jamead/psc_daughter_brd/psc_daughter_brd.png

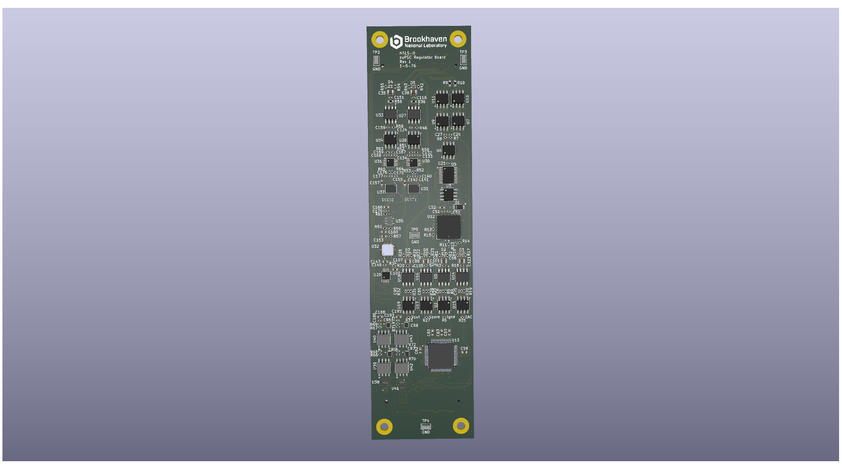
psc_daughter_brd.png
