jamead/psc_daughter_brd/assembly/psc_daughter_brd_BOM.ods

zuPSC Daughter Board
Parts per Board |  | 293
Total Parts Cost |  | $516.36
Do not install parts in red
Line Item | Qty per Board | Unit Cost | Cost Per Board | Part Number | Reference Designator | Value | Description | Manufacturer | DNP
1 | 1 | $0.01 | $0.01 | CL10B105KA8NNNC | C32 | 1uF | CAP CER 1UF 25V X7R 0603 | Samsung
2 | 4 | $0.01 | $0.04 | C0402C221K5RACTU | C1,C68,C78,C88 | 220pF | CAP CER 220PF 50V X7R 0402 | Kemet
3 | 6 | $0.01 | $0.06 | CL05B332KB5NNNC | C116,C133,C141,C151,C168,C176 | 3300pF | CAP CER 3300PF 50V X7R 0402 | Samsung
4 | 2 | $0.01 | $0.02 | MBASU105SB7103KFNA18 | C124,C159 | 0.01uF | CAP CER 0.01UF 50V X7R 0402 | Taiyo Yuden
5 | 8 |  | $0.00 | CAP CER 3300PF 50V X7R 0402 | C132,C134,C140,C142,C167,C169,C175,C177 | 6800pF | CAP CER 6800PF 50V X7R 0402 | Samsung
6 | 69 |  | $0.00 | CL10A106MA8NRNC | C2,C3,C6,C7,C11,C12,C15,C17,C18,C22,C23,C28,C30,C31,C33,C40,C41,C42,C43,C48,C52,C57,C59,C60,C61,C62,C63,C66,C69,C70,C73,C74,C79,C80,C83,C84,C89,C90,C93,C94,C98,C100,C106,C119,C121,C126,C127,C136,C137,C143,C145,C147,C153,C154,C155,C156,C157,C160,C161,C162,C166,C171,C172,C178,C180,C187,C188,C194,C195 | 10uF | CAP CER 10UF 25V X5R 0603 | Samsung
7 | 3 | $0.10 | $0.30 | C0402C100K5RACTU | C21,C26,C27 | 10pF | CAP CER 10PF 50V X7R 0402 | Kemet
8 | 6 | $0.22 | $1.32 | EMCT101W222M1GV001E | C35,C38,C101,C103,C105,C107 | 2200pF | CAP CER 2200PF 100V X7R 0805 FEED THROUGH | Johanson
9 | 76 |  | $0.00 | TMK105BJ104KV-F | C4,C5,C9,C10,C13,C14,C16,C19,C20,C24,C25,C29,C34,C36,C37,C39,C44,C45,C46,C47,C49,C50,C51,C53,C54,C55,C56,C58,C64,C65,C67,C71,C72,C76,C77,C81,C82,C86,C87,C91,C92,C96,C97,C99,C102,C104,C108,C117,C123,C128,C130,C138,C139,C144,C146,C148,C152,C158,C163,C164,C165,C170,C173,C174,C179,C181,C182,C183,C184,C185,C186,C189,C190,C191,C192,C193 | 0.1uF | CAP CER 0.1UF 25V X5R 0402 | Taiyo Yuden
10 | 4 | $0.10 | $0.40 | CL05B472KB5NNNC | C8,C75,C85,C95 | 4700pF | CAP CER 4700PF 50V X7R 0402 | Samsung
11 | 4 | $0.65 | $2.60 | SP3006-02XTG | CR5,CR6,CR7,CR8 |  | TVS DIODE 6VWM 15VC SOT563 | Littlefuse
12 | 1 | $0.23 | $0.23 | DFLS130-7 | D1 |  | DIODE SCHOTTK 30V 1A POWERDI 123 | Diodes Inc.
13 | 6 | $0.24 | $1.44 | SP3118-01ETG | D2,D3,D4,D5,D6,D7 |  | TVS DIODE 18VWM 38VC SOD882 | Littlefuse
14 | 2 | $2.53 | $5.06 | 61082-061400LF | J1,J2 |  | CONN RCPT 60POS SMD GOLD | Amphenol
15 | 1 |  | $0.00 | ERJ-2RKF1200X | R11 | 120 | RES SMD 120 OHM 1% 1/10W 0402 | Panasonic
16 | 1 |  | $0.00 | ERJ-2RKF6342X | R13 | 63K | RES SMD 63.4K OHM 1% 1/10W 0402 | Panasonic | DNP
17 | 1 |  | $0.00 | ERJ-2RKF7872X | R14 | 78.7K | RES SMD 78.7K OHM 1% 1/10W 0402 | Panasonic
18 | 1 |  | $0.00 | ERJ-2RKF1213X | R34 | 121K | RES SMD 121K OHM 1% 1/10W 0402 | Panasonic
19 | 12 | $0.01 | $0.12 | ERJ-2RKF1001X | R1,R2,R16,R17,R22,R23,R28,R29,R42,R43,R54,R55 | 1.0K | RES SMD 1K OHM 1% 1/10W 0402 | Panasonic
20 | 2 |  | $0.00 | ERJ-2GE0R00X | R15,R57 | 0 | RES SMD 0 OHM JUMPER 1/10W 0402 | Panasonic
21 | 4 |  | $0.00 | ERJ-2RKF10R0X | R3,R18,R24,R30 | 10 | RES SMD 10 OHM 1% 1/10W 0402 | Panasonic | DNP
22 | 2 | $0.32 | $0.64 | RQ73C1J665RBTD | R36,R56 | 665 | RES 665 OHMS 0.1% 0.15W 0603 | TE
23 | 10 | $0.01 | $0.10 | ERJ-2RKF1002X | R4,R5,R19,R20,R25,R26,R31,R32,R59,R60 | 10K | RES SMD 10K OHM 1% 1/10W 0402 | Panasonic
24 | 2 | $0.01 | $0.02 | ERJ-2RKF1301X | R46,R58 | 1.3K | RES SMD 1.3K OHM 1% 1/10W 0402 | Panasonic
25 | 2 | $0.01 | $0.02 | ERJ-2RKF15R0X | R51,R63 | 15 | RES SMD 15 OHM 1% 1/10W 0402 | Panasonic
26 | 4 | $0.01 | $0.04 | ERJ-2RKF30R1X | R52,R53,R64,R65 | 30.1 | RES SMD 30.1 OHM 1% 1/10W 0402 | Panasonic
27 | 8 | $0.01 | $0.08 | ERJ-2RKF10R0X | R6,R12,R21,R27,R33,R50,R61,R62 | 10 | RES SMD 10 OHM 1% 1/10W 0402 | Panasonic
28 | 8 | $0.01 | $0.08 | ERJ-2RKF2491X | R66,R67,R68,R69,R70,R71,R72,R73 | 2.49K | RES SMD 2.49K OHM 1% 1/10W 0402 | Panasonic
29 | 2 | $0.01 | $0.02 | ERJ-2RKF5111X | R7,R8 | 5.11K | RES SMD 5.11K OHM 1% 1/10W 0402 | Panasonic
30 | 2 | $0.01 | $0.02 | ERJ-PA3F1000V | R9,R10 | 100 | RES SMD 100 OHM 1% 1/3W 0603 | Panasonic
31 | 5 | $0.23 | $1.15 | RCS-0C | TP1,TP2,TP3,TP4,TP5 |  | PC TEST POINT NATURAL | TE
32 | 1 | $3.93 | $3.93 | AD8676ARZ-REEL7 | U3 |  | IC OPAMP GP 2 CIRCUIT 8SOIC | Analog Devices
33 | 1 | $129.29 | $129.29 | AD5791BRUZ | U5 |  | IC DAC 20BIT V-OUT 20TSSOP | Analog Devices
34 | 1 | $13.75 | $13.75 | AD797ARZ | U6 |  | IC OPAMP GP 1 CIRCUIT 8SOIC | Analog Devices
35 | 1 | $100.10 | $100.10 | ADR1001AEZ | U12 |  | IC VREF SERIES 5V 0.25% 20CLCC | Analog Devices
36 | 1 | $25.17 | $25.17 | ADS8568SPM | U13 |  | IC ADC 16BIT SAR 64LQFP | Analog Devices
37 | 1 | $4.96 | $4.96 | LT3042EMSE#TRPBF | U20 |  | IC REG LINEAR POS ADJ 10MSOP-EP | Analog Devices
38 | 1 | $14.02 | $14.02 | LTC6655BHLS8-5#PBF | U32 |  | IC VREF SERIES 0.025% 8CLCC | Analog Devices
39 | 1 | $3.79 | $3.79 | LT6202CS5#TRPBF | U35 |  | IC OPAMP GP 1 CIRCUIT TSOT23-5 | Analog Devices
40 | 4 | $10.23 | $40.92 | AD8221BRZ | U1,U14,U16,U18 |  | IC INST AMP 1 CIRCUIT 8SOIC | Analog Devices
41 | 2 | $2.99 | $5.98 | BUF634AIDR | U10,U11 |  | IC OPAMP GP 1 CIRCUIT 8SOIC | Analog Devices
42 | 6 | $2.66 | $15.96 | OPA277UA/2K5 | U2,U7,U9,U15,U17,U19 |  | IC OPAMP GP 1 CIRCUIT 8SOIC | Analog Devices
43 | 2 | $12.76 | $25.52 | AD8429BRZ | U27,U33 |  | IC INST AMP 1 CIRCUIT 8SOIC | Analog Devices
44 | 2 | $2.88 | $5.76 | AD8675ARZ | U28,U34 |  | IC OPAMP GP 1 CIRCUIT 8SOIC | Analog Devices
45 | 2 | $7.61 | $15.22 | LTC6363IMS8#TRPBF | U30,U36 |  | IC OPAMP DIFF 1 CIRCUIT 8MSOP | Analog Devices
46 | 2 | $34.72 | $69.44 | LTC2376CDE-20#PBF | U31,U37 |  | IC ADC 20BIT SAR 16DFN | Analog Devices
47 | 2 | $0.77 | $1.54 | TXUN0104RUTR | U38,U41 |  | IC XLTR VL UNIDIR 12-UQFN | TI
48 | 2 | $6.81 | $13.62 | ADUM5240ARZ | U39,U40 |  | DGTL ISOLTR 2.5KV 2CH GP 8-SOIC | Analog Devices
49 | 2 | $6.81 | $13.62 | ADUM5242ARZ | U42,U43 |  | DGTL ISOLTR 2.5KV 2CH GP 8-SOIC | Analog Devices
