jamead/psc_daughter_brd/3dmodels/E-20-1_ADI.step

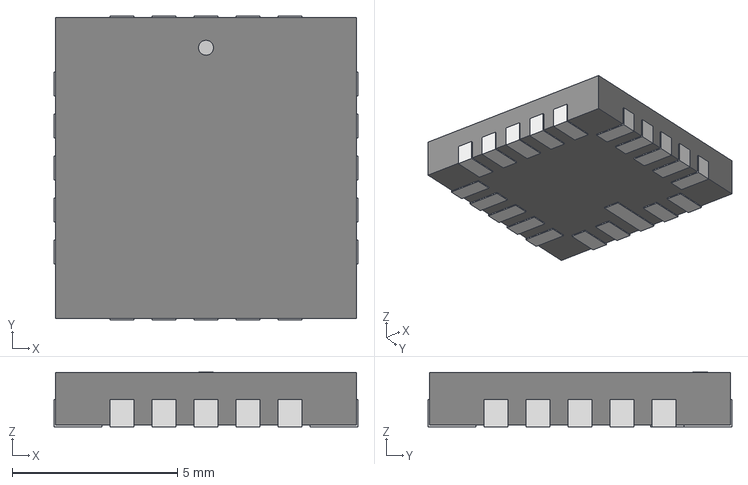
[picture p2: CAD file, 2026-01-05]
3dmodels/E-20-1_ADI.step
9.19 x 9.19 x 1.65 mm
