jamead/psc_daughter_brd/3dmodels/DFLS130-7_DIO.step

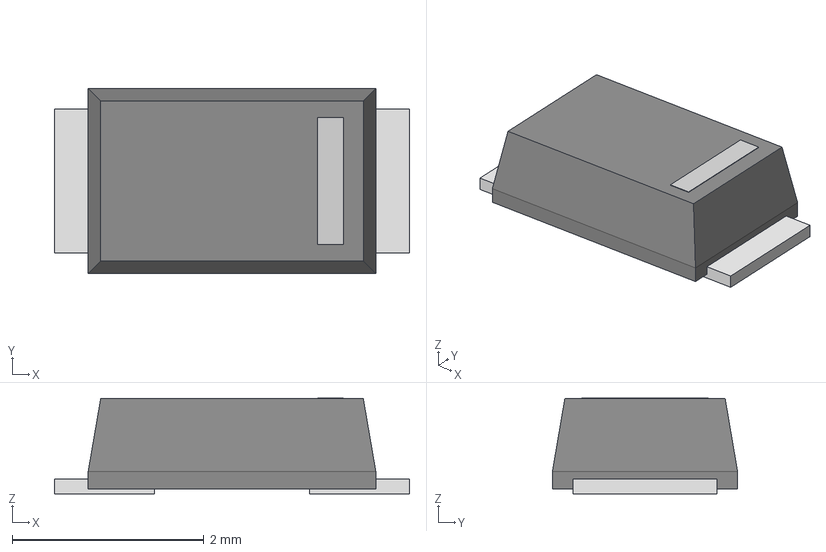
[picture p3: CAD file, 2026-01-05]
3dmodels/DFLS130-7_DIO.step
3.70 x 1.93 x 0.997 mm
