jamead/psc_daughter_brd/3dmodels/c-1625854-1-ba-3d.step

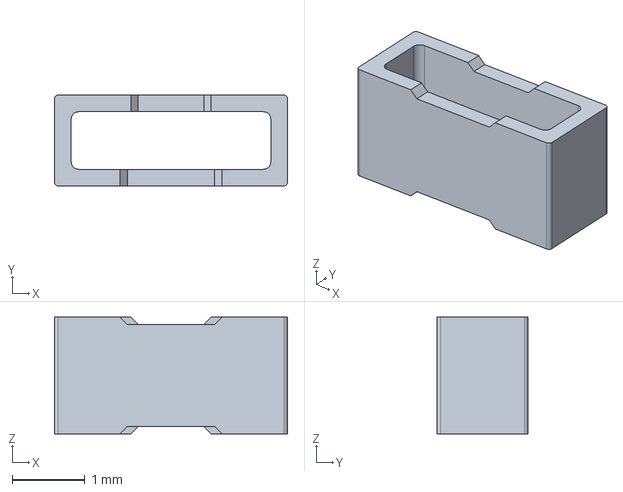
[picture p4: CAD file, 2026-01-05]
3dmodels/c-1625854-1-ba-3d.step
3.20 x 1.25 x 1.60 mm
