jamead/psc_daughter_brd/3dmodels/S_5_ADI.step

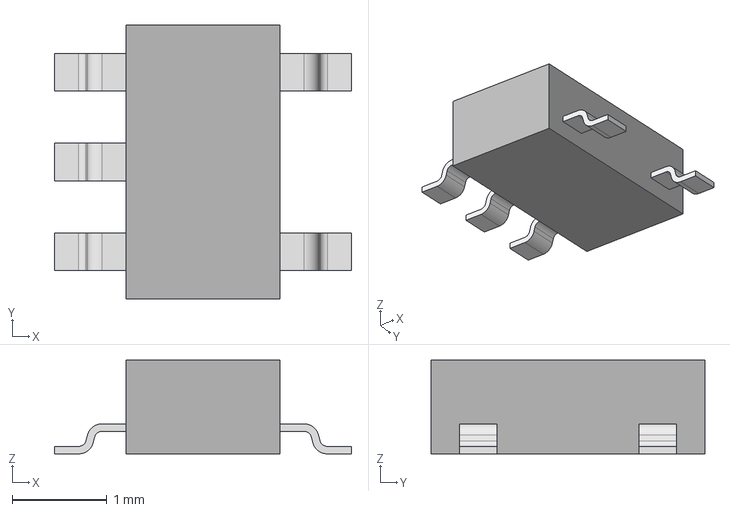
[picture p5: CAD file, 2026-01-05]
3dmodels/S_5_ADI.step
3.14 x 2.90 x 0.991 mm
