jamead/psc_daughter_brd/3dmodels/SOT563_LTF.step

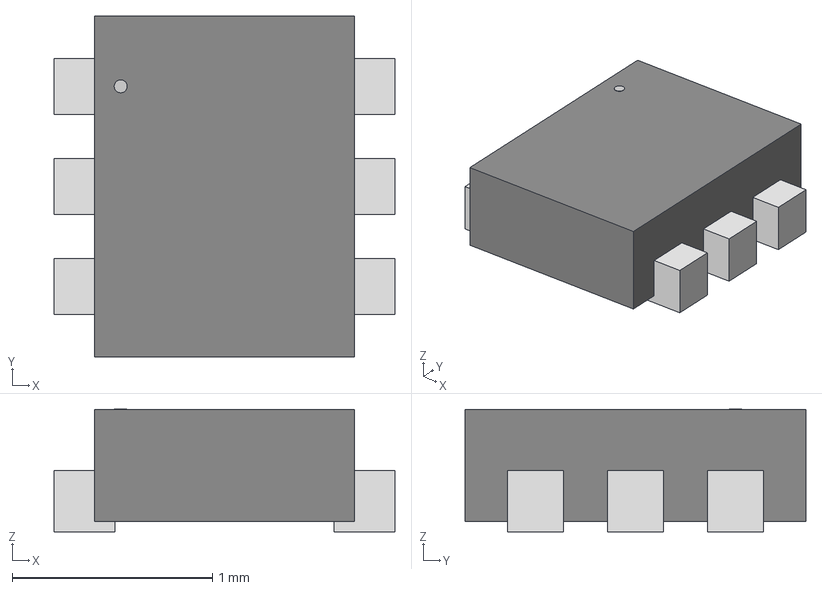
[picture p6: CAD file, 2026-01-05]
3dmodels/SOT563_LTF.step
1.70 x 1.70 x 0.612 mm
