jamead/psc_daughter_brd/3dmodels/RUT0012A.stp

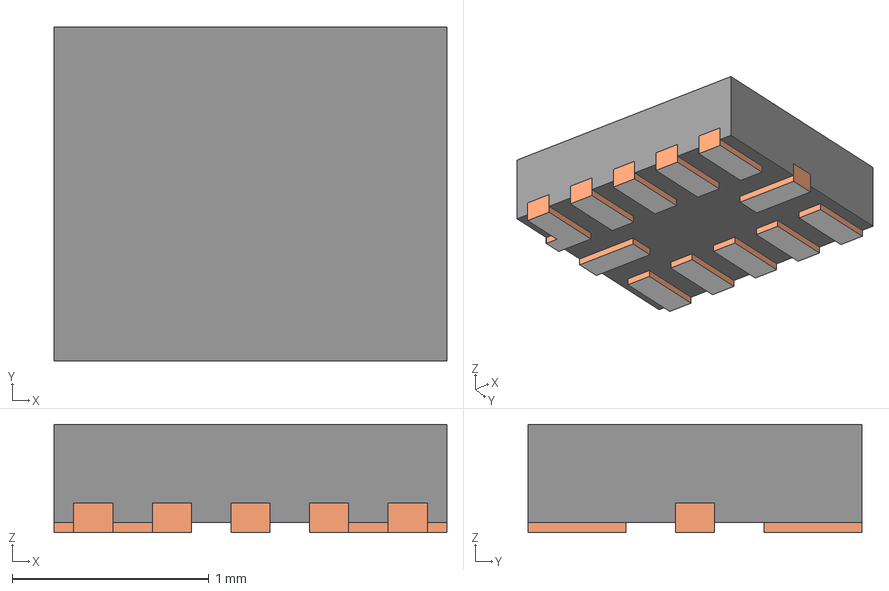
[picture p7: CAD file, 2026-01-05]
3dmodels/RUT0012A.stp
2.00 x 1.70 x 0.55 mm
BODY-SON
FRAME-RUT0012A
PIN1-ID
