jamead/psc_daughter_brd/3dmodels/R_8_ADI.step

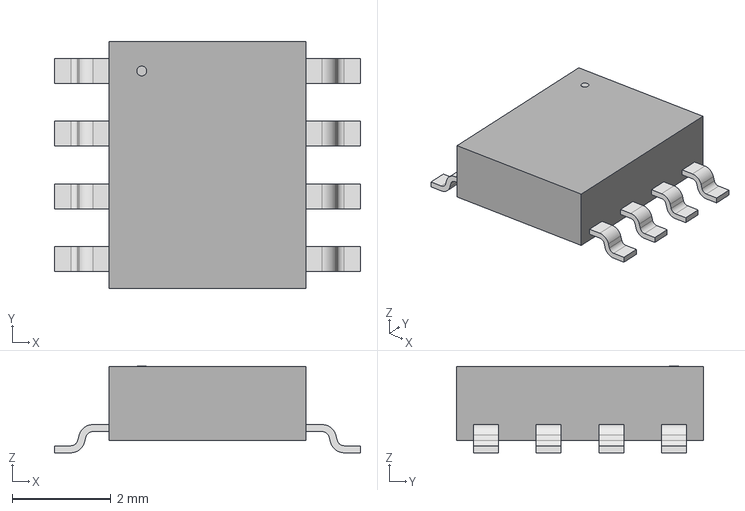
[picture p8: CAD file, 2026-01-05]
3dmodels/R_8_ADI.step
6.20 x 5.00 x 1.75 mm
