jamead/psc_daughter_brd/3dmodels/LTC2378CDE-20#PBF.STEP

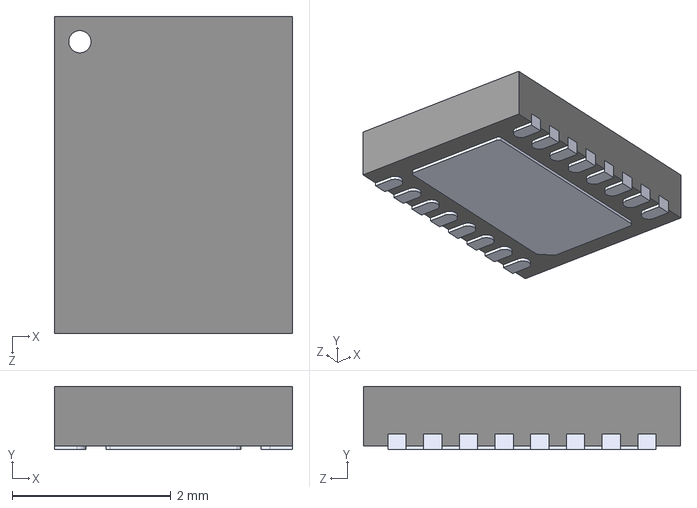
[picture p9: CAD file, 2025-11-20]
3dmodels/LTC2378CDE-20#PBF.STEP
3.00 x 0.8 x 4.00 mm
