jamead/psc_daughter_brd/3dmodels/LTC6655BHLS8-5#PBF.STEP

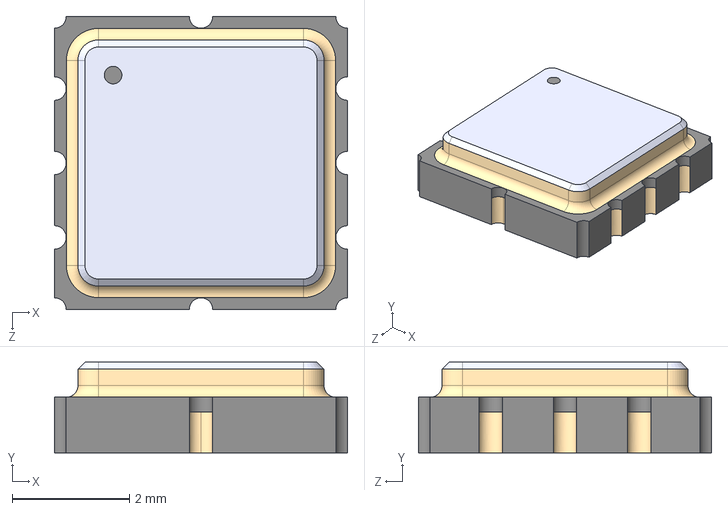
[picture p10: CAD file, 2025-11-20]
3dmodels/LTC6655BHLS8-5#PBF.STEP
5.00 x 1.55 x 5.00 mm
