jamead/psc_daughter_brd/3dmodels/ADS8568SPM.step

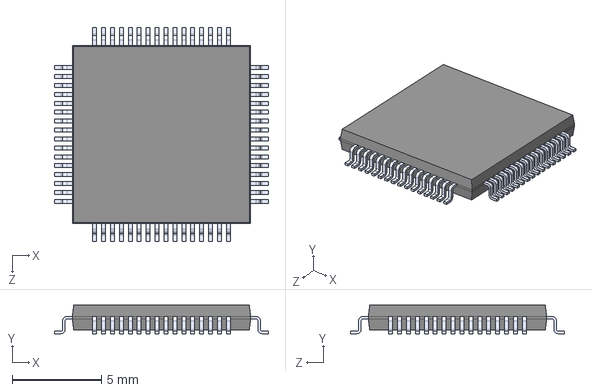
[picture p11: CAD file, 2025-07-15]
3dmodels/ADS8568SPM.step
12.0 x 1.60 x 12.0 mm
