jamead/psc_daughter_brd/3dmodels/AD8221BRZ.STEP

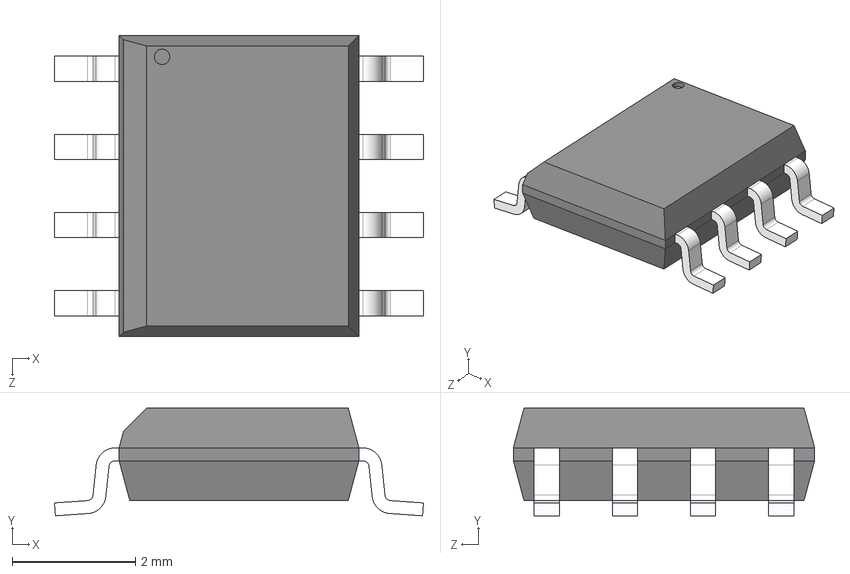
[picture p12: CAD file, 2025-07-15]
3dmodels/AD8221BRZ.STEP
6.00 x 1.75 x 4.90 mm
