jamead/psc_daughter_brd/3dmodels/Amphenol_10090926-P264XLF.step

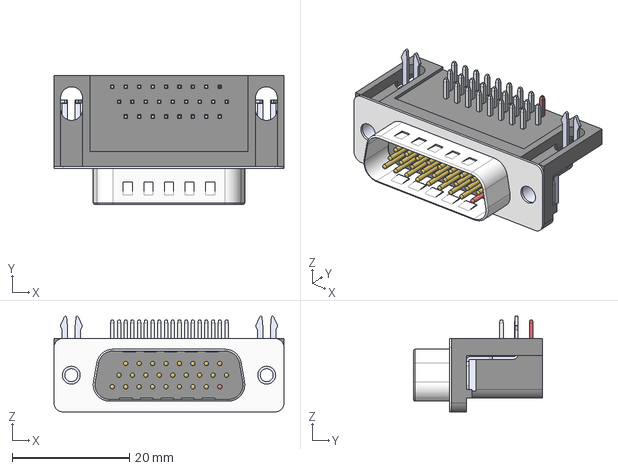
[picture p13: CAD file, 2025-07-02]
3dmodels/Amphenol_10090926-P264XLF.step
39.2 x 22.0 x 16.3 mm
