jamead/psc_daughter_brd/3dmodels/61082-061400LF--3DModel-STEP-740395.STEP

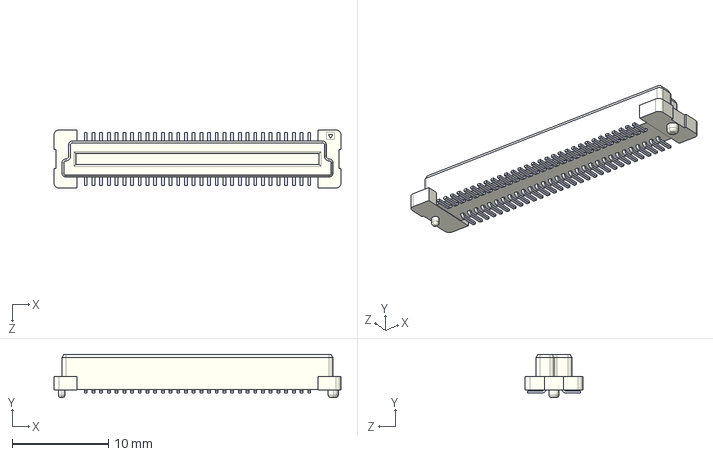
[picture p14: CAD file, 2025-11-18]
3dmodels/61082-061400LF--3DModel-STEP-740395.STEP
29.8 x 4.50 x 6.00 mm
61082-additional_06
pin^61082 add Ass x 30
