jamead/psc_daughter_brd/3dmodels/39301022.step

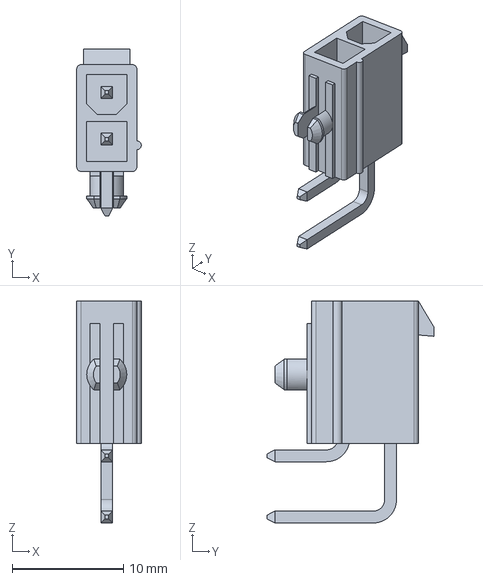
[picture p15: CAD file, 2025-07-02]
3dmodels/39301022.step
5.80 x 15.0 x 19.9 mm
