jamead/psc_daughter_brd/3dmodels/836149012.step

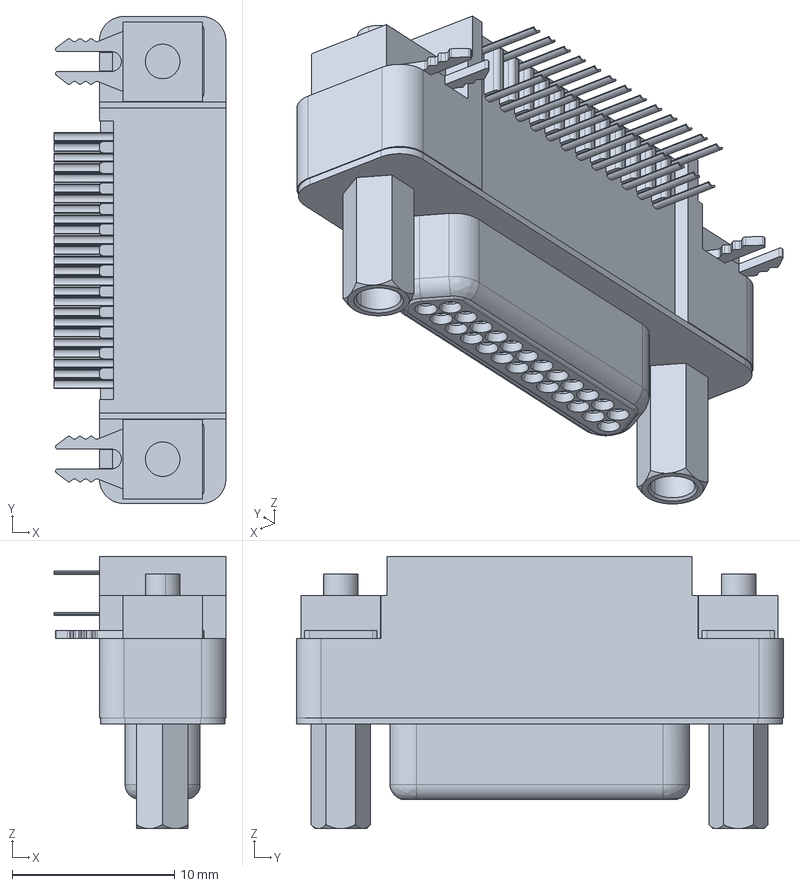
[picture p16: CAD file, 2025-07-02]
3dmodels/836149012.step
10.6 x 30.0 x 16.8 mm
