jamead/psc_daughter_brd/3dmodels/6469028-1.step

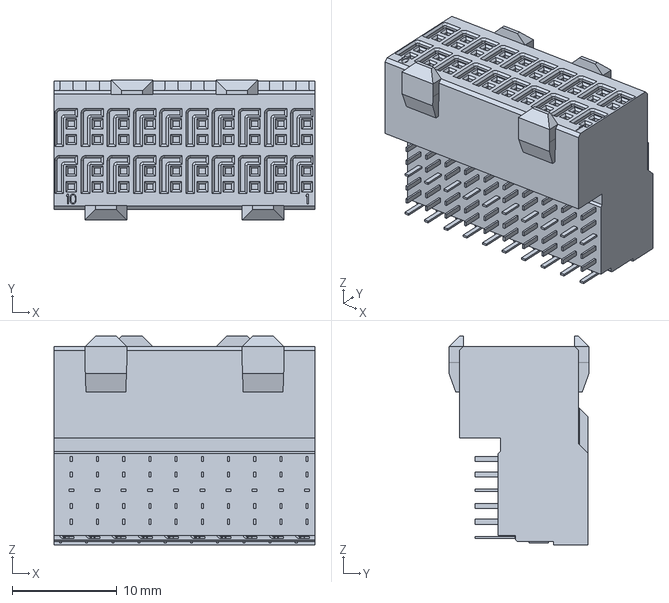
[picture p17: CAD file, 2025-07-02]
3dmodels/6469028-1.step
24.9 x 13.3 x 19.9 mm
