jamead/psc_daughter_brd/psc_daughter_brd_sch.pdf

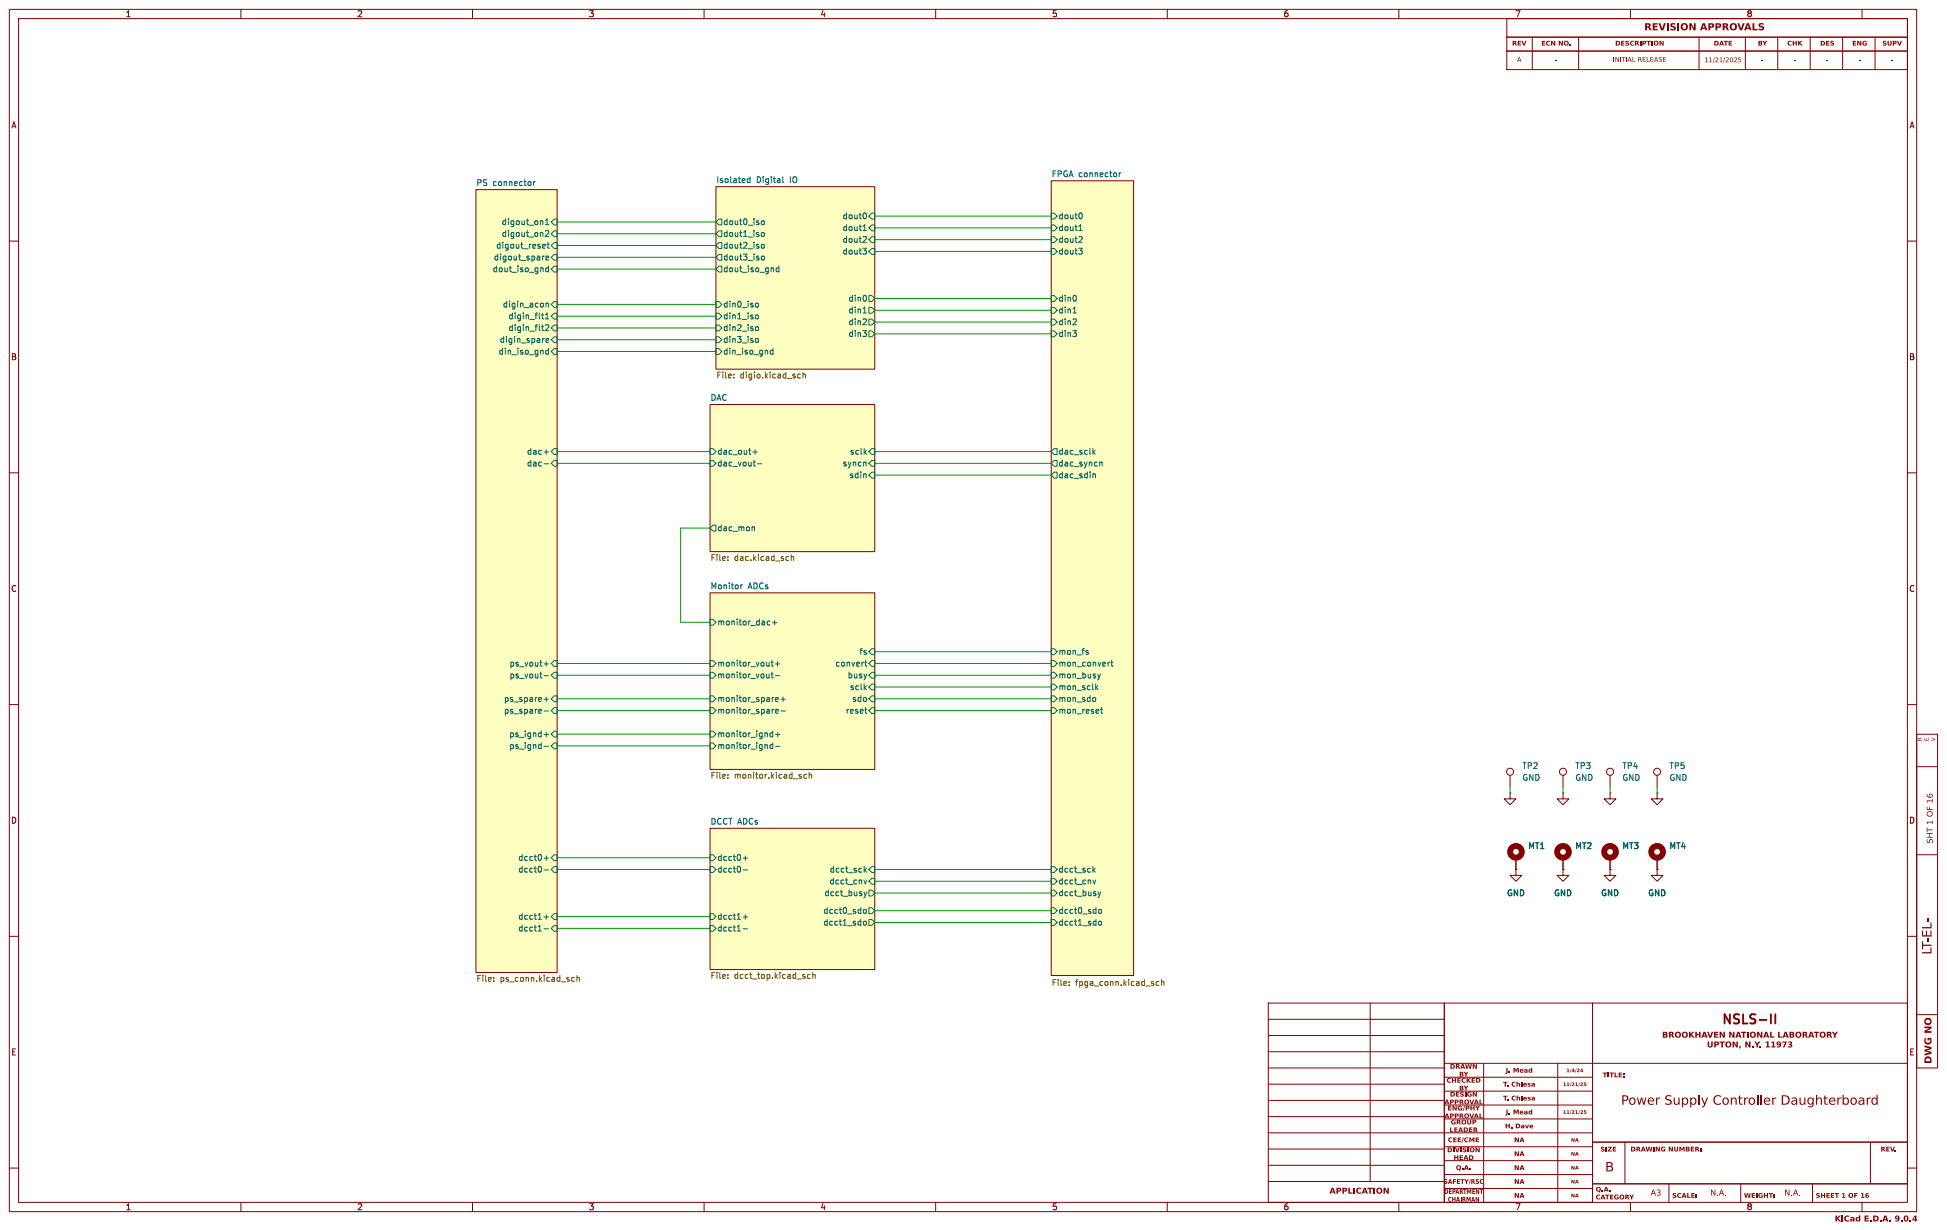
[picture p18: page 1]

REV | ECN NO. - | INITIAL RELEASE REVISION APPROVALS DESCRIPTION | DATE | BY | CHK | DES | ENG | SUPV A

BY CHECKED | J. Mead | 1/4/24 | TITLE:Power Supply Controller Daughterboard
BY DESIGN | T. Chiesa | 11/21/25
APPROVAL ENG/PHY
APPROVAL GROUP

LEADER | J. Mead H. Dave NA | 11/21/25 NA

CEE/CME DIVISION
HEAD Q.A. SAFETY/RSC | NA | NA

SIZE | DRAWING NUMBER: | REV. Q.A.

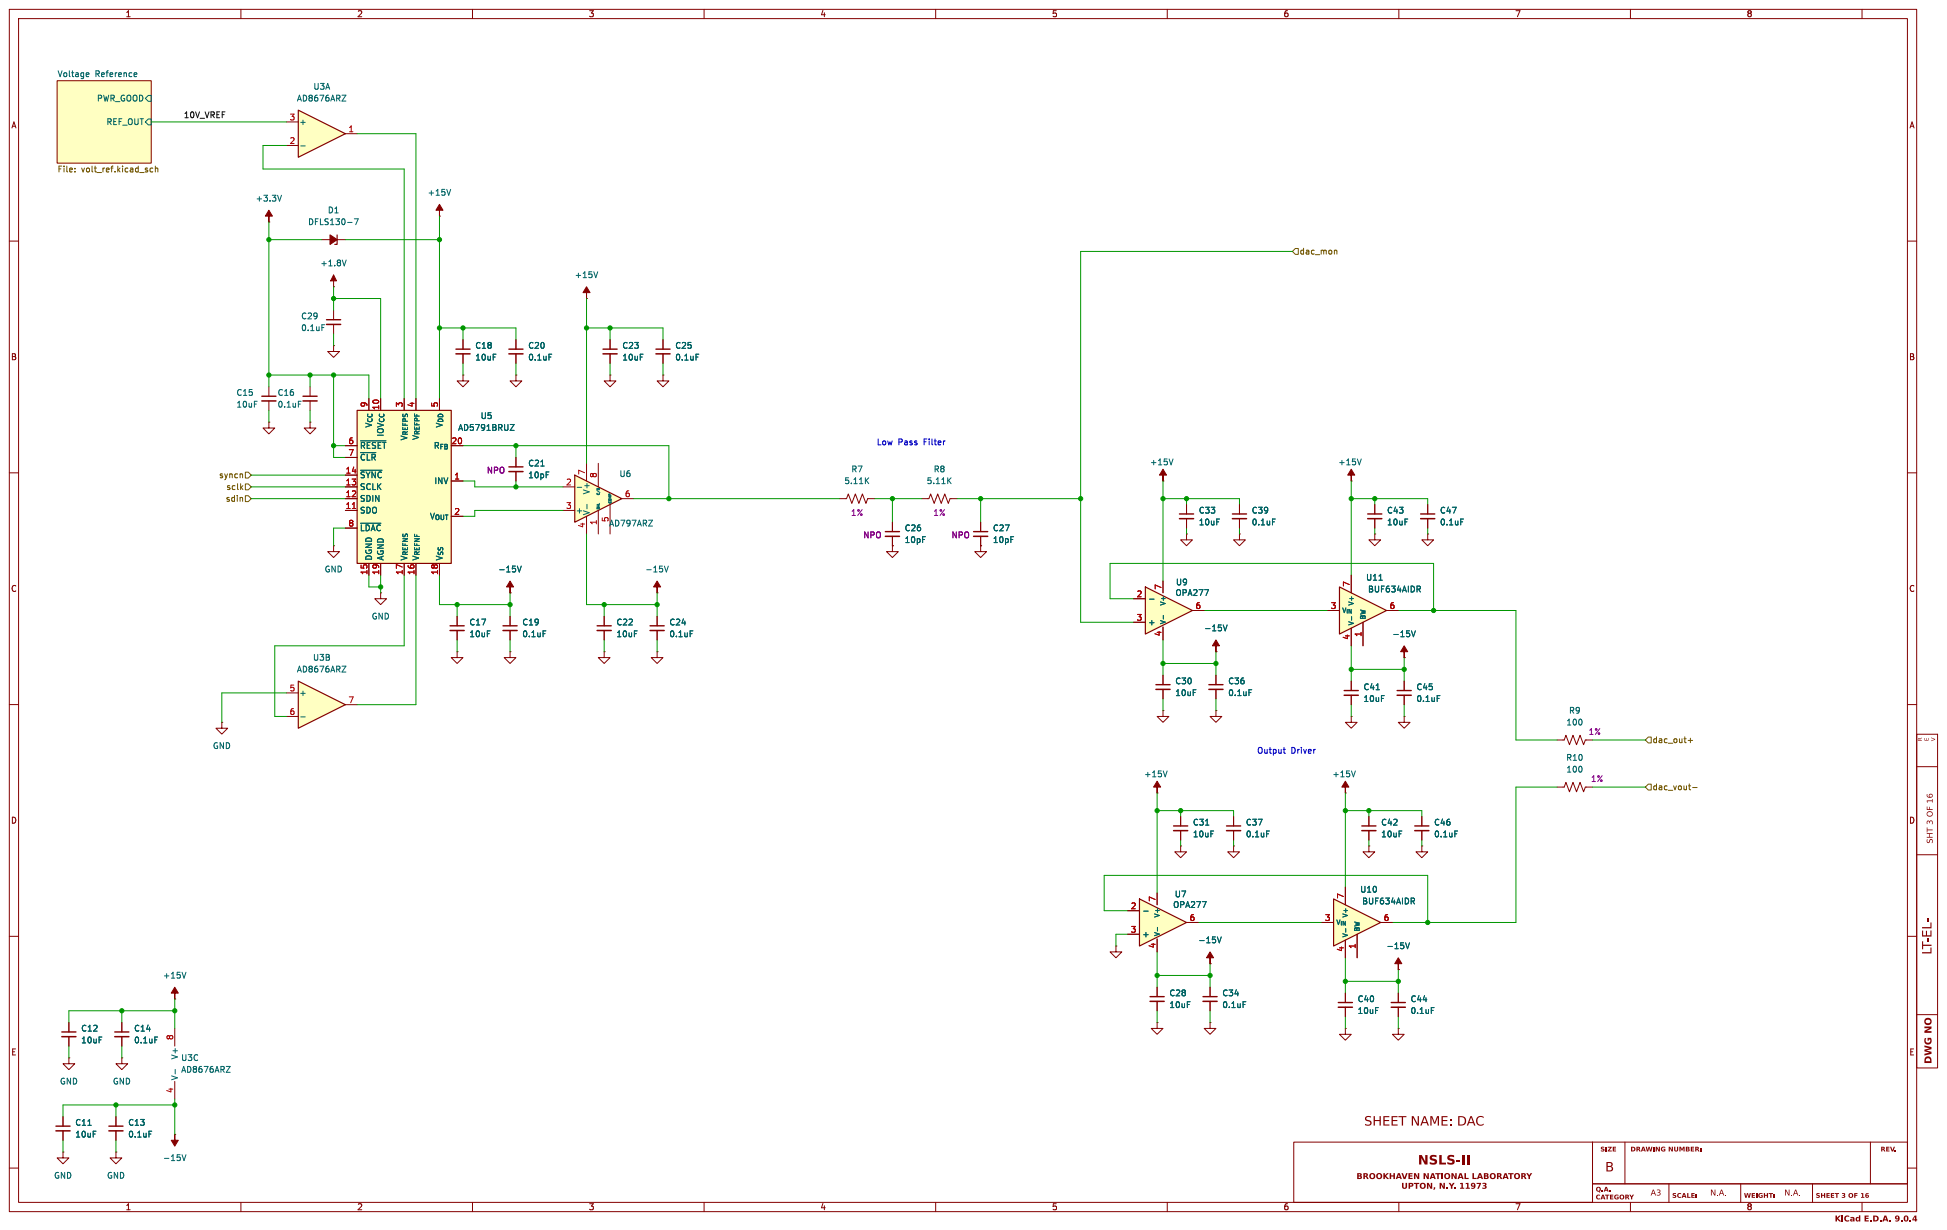
[picture p19: page 2]

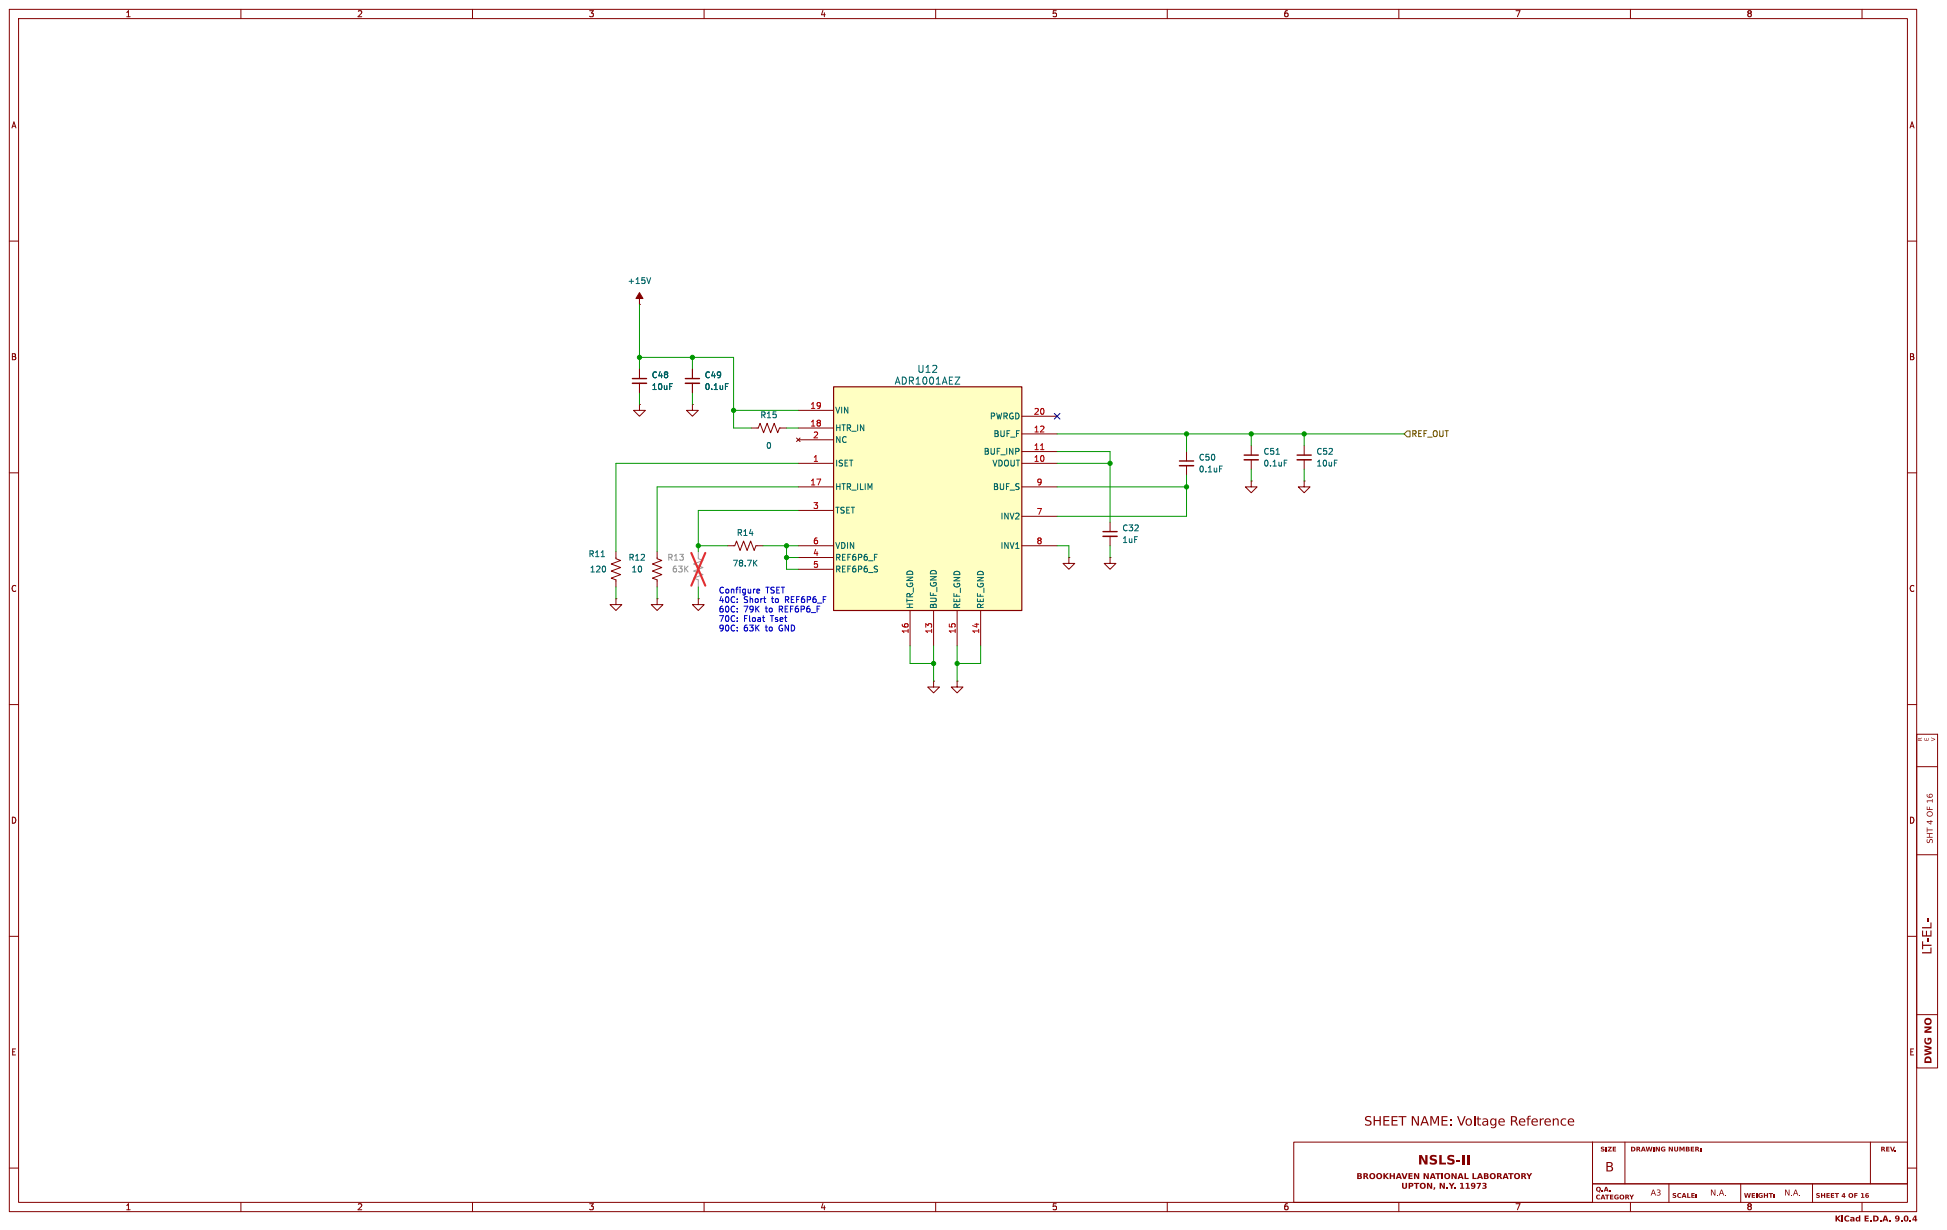
[picture p20: page 3]

40C: Short to REF6P6_F
60C: 79K to REF6P6_F
70C: Float Tset 90C: 63K to GND

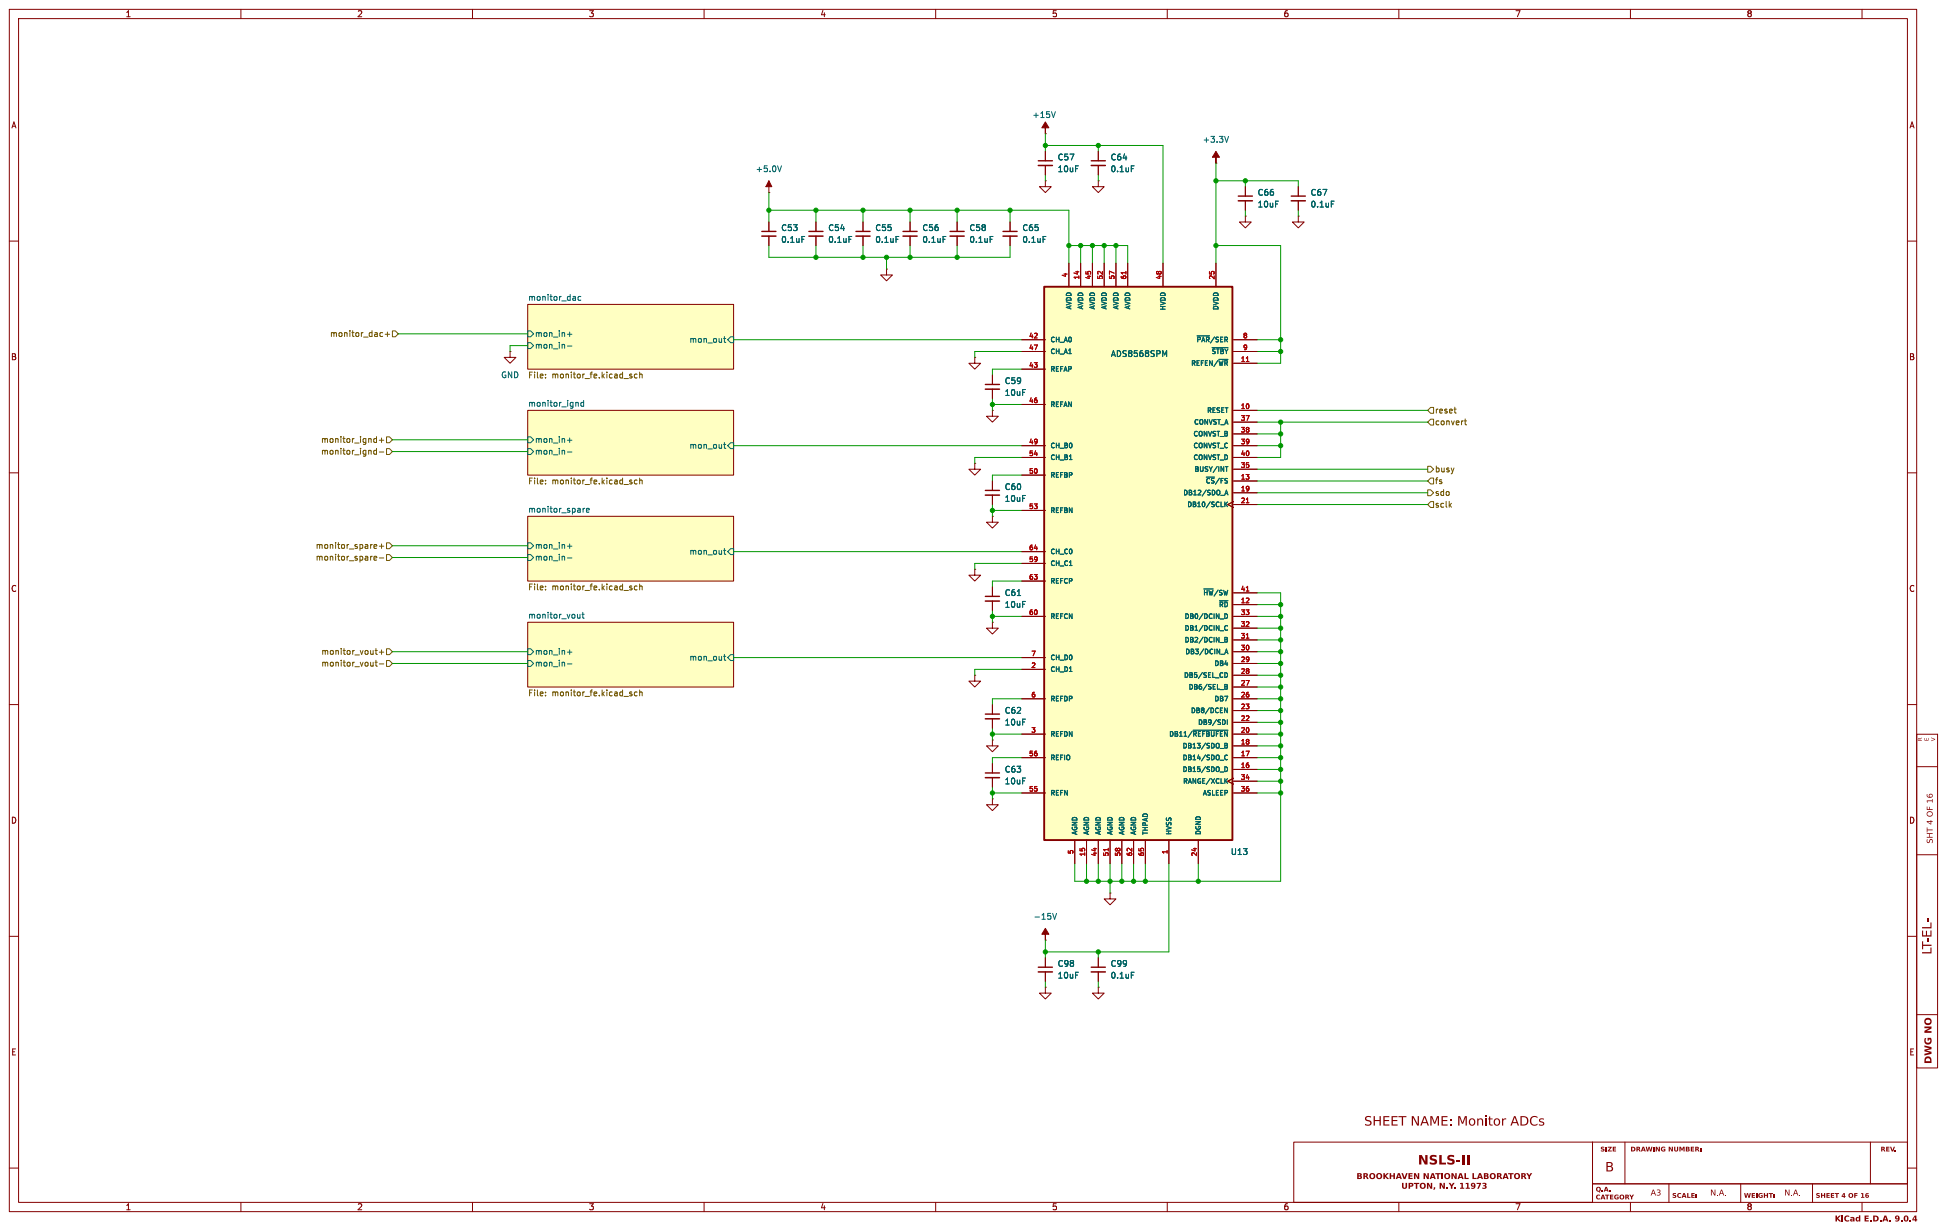
[picture p21: page 4]

1 DGND 24 DVDD 25 ~{PAR}/SER 8 ~{STBY} 9 REFEN/~{WR} 11 RESET 10 CONVST_B 38 CONVST_C 39 CONVST_D 40 BUSY/INT 35 ~{CS}/FS 13 DB12/SDO_A 19 DB10/SCLK 21 ~{HW}/SW 41 ~{RD} 12 DB0/DCIN_D 33 DB1/DCIN_C 32 DB2/DCIN_B 31 DB3/DCIN_A 30 DB4 29 DB5/SEL_CD 28 DB6/SEL_B 27 DB7 26 DB8/DCEN 23 DB9/SDI 22 DB11/~{REFBUFEN} 20 DB13/SDO_B 18 DB14/SDO_C 17 DB15/SDO_D 16 RANGE/XCLK 34 ASLEEP 36 AVDD 14 AGND 15 AVDD 45 AGND 44 AVDD 52 AGND 51 AVDD 57 AGND 58 AVDD 61 AGND 62 THPAD 65 CONVST_A 37 C61

1 DGND 24 DVDD 25 ~{PAR}/SER 8 ~{STBY} 9 REFEN/~{WR} 11 RESET 10 CONVST_B 38 CONVST_C 39 CONVST_D 40 BUSY/INT 35 ~{CS}/FS 13 DB12/SDO_A 19 DB10/SCLK 21 ~{HW}/SW 41 ~{RD} 12 DB0/DCIN_D 33 DB1/DCIN_C 32 DB2/DCIN_B 31 DB3/DCIN_A 30 DB4 29 DB5/SEL_CD 28 DB6/SEL_B 27 DB7 26 DB8/DCEN 23 DB9/SDI 22 DB11/~{REFBUFEN} 20 DB13/SDO_B 18 DB14/SDO_C 17 DB15/SDO_D 16 RANGE/XCLK 34 ASLEEP 36 AVDD 14 AGND 15 AVDD 45 AGND 44 AVDD 52 AGND 51 AVDD 57 AGND 58 AVDD 61 AGND 62 THPAD 65 CONVST_A 37 U13

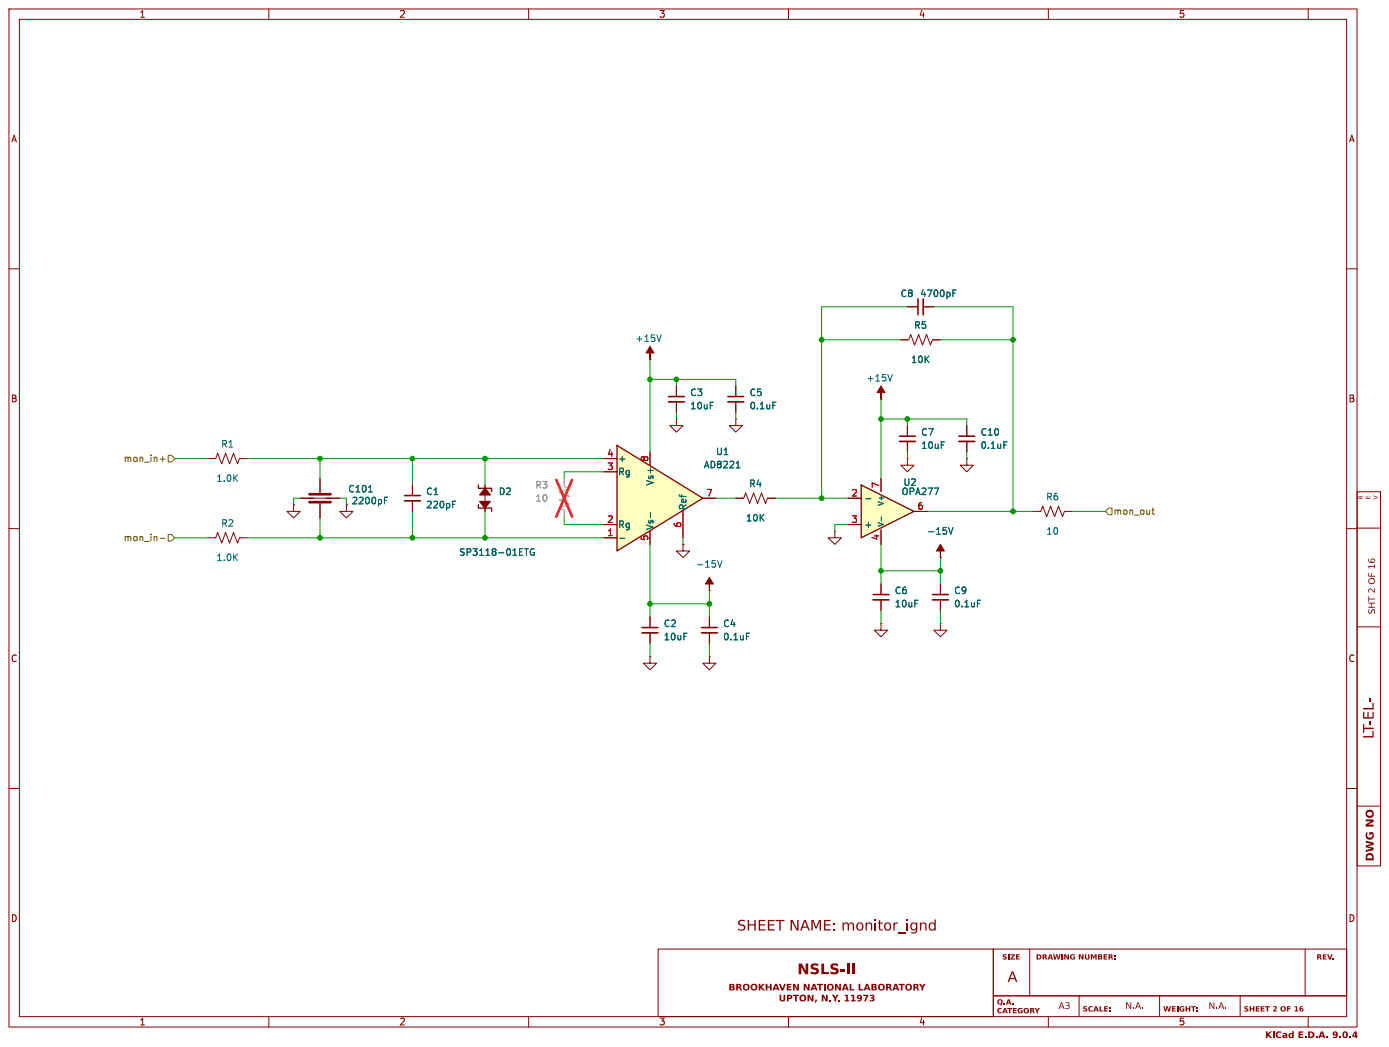
[picture p22: page 5]

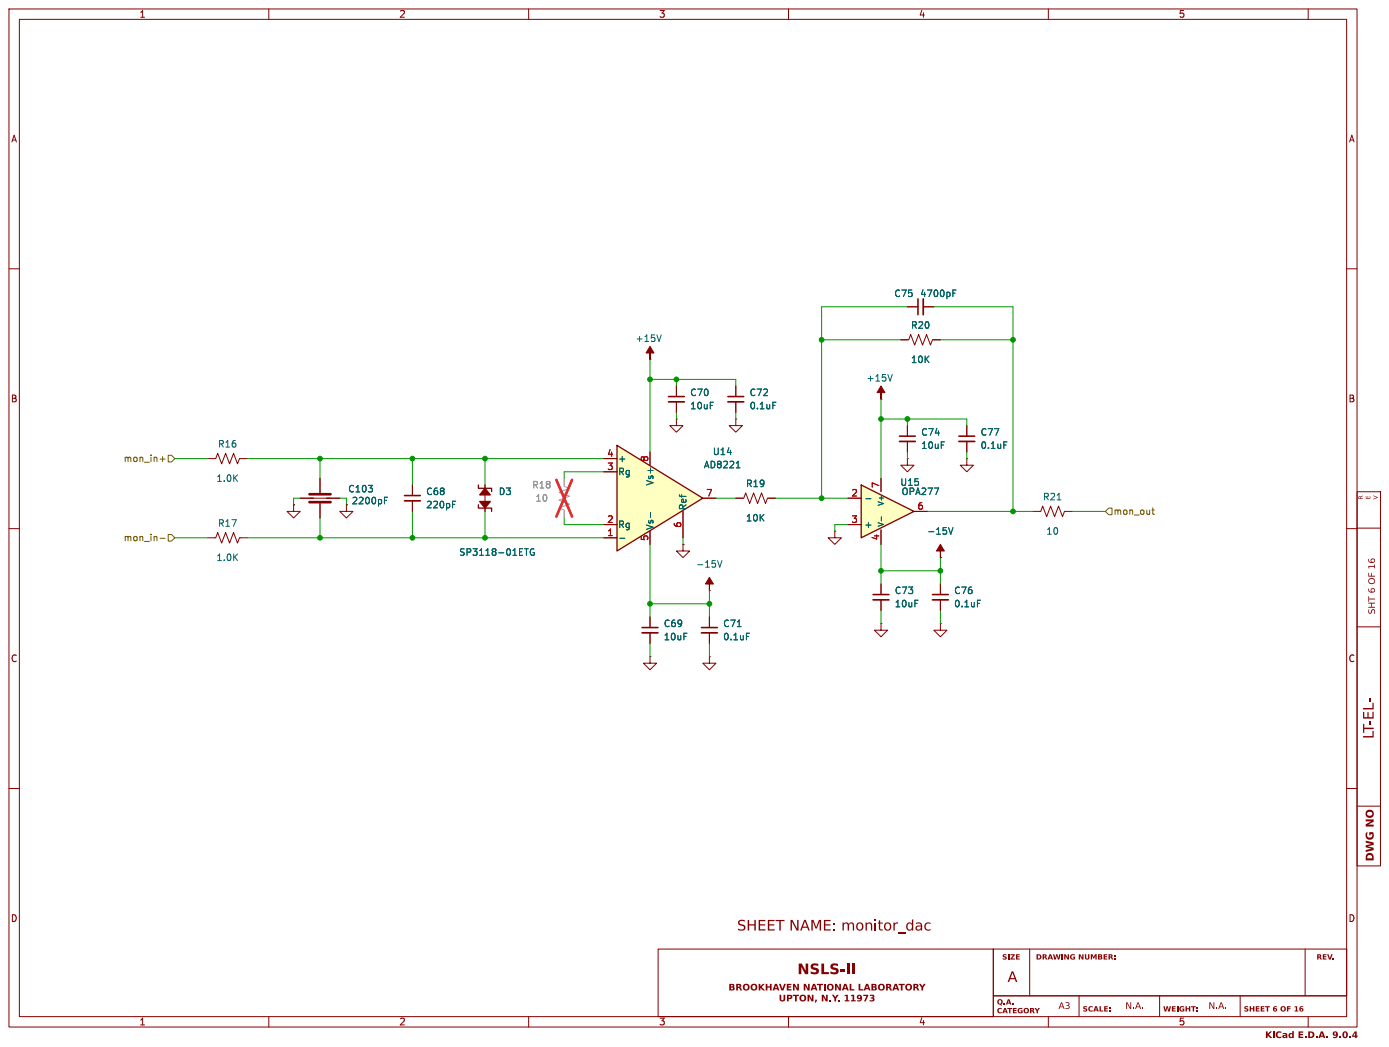
[picture p23: page 6]

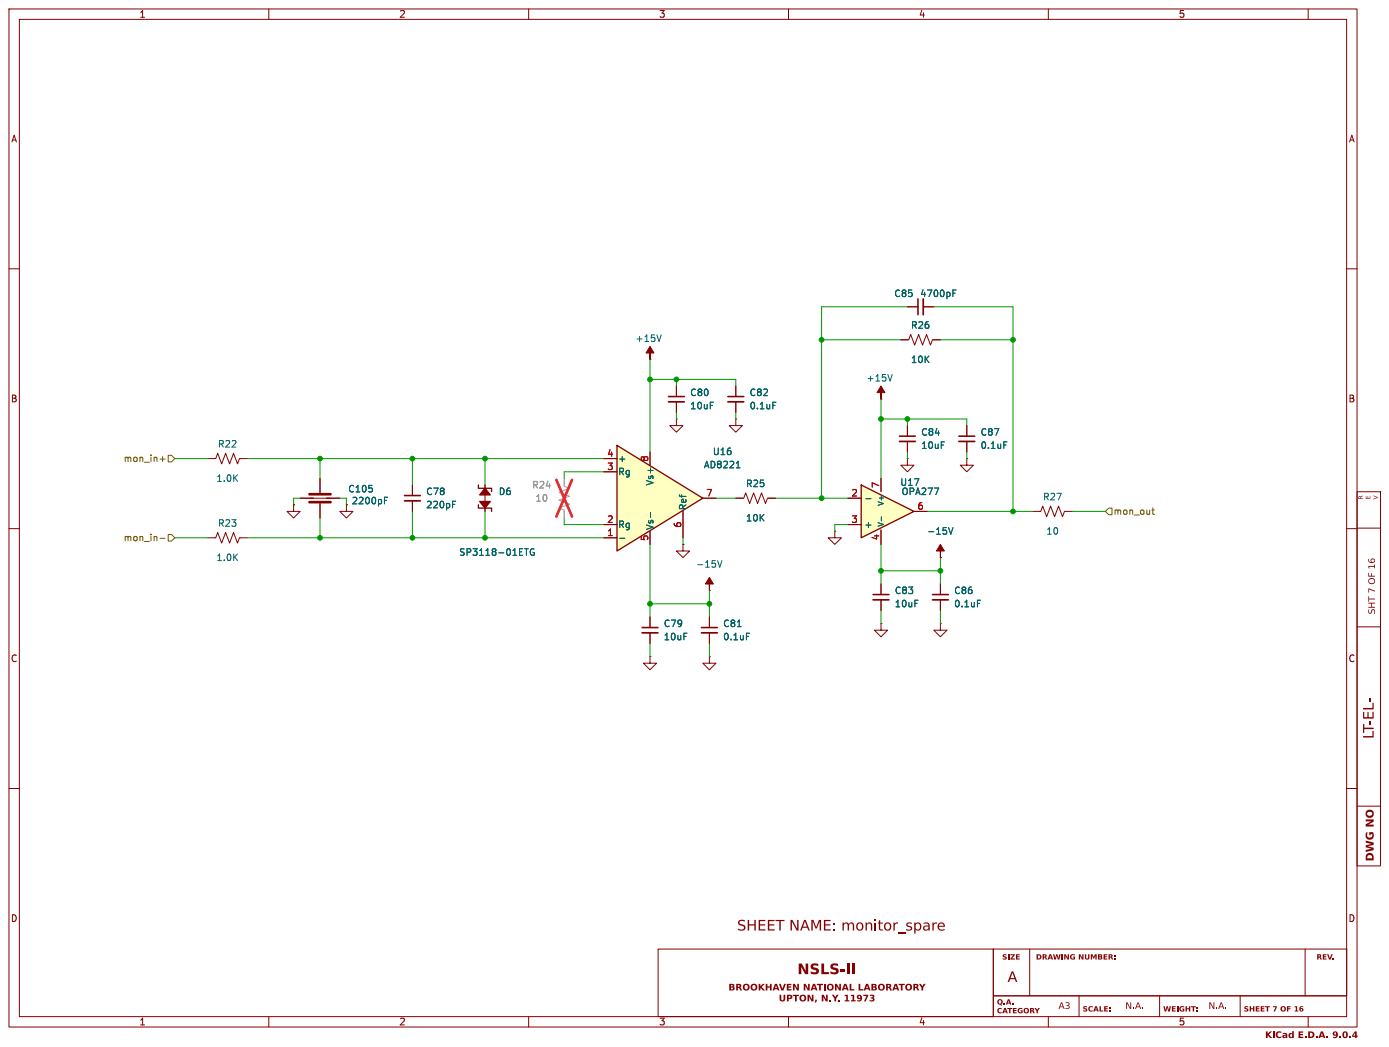
[picture p24: page 7]

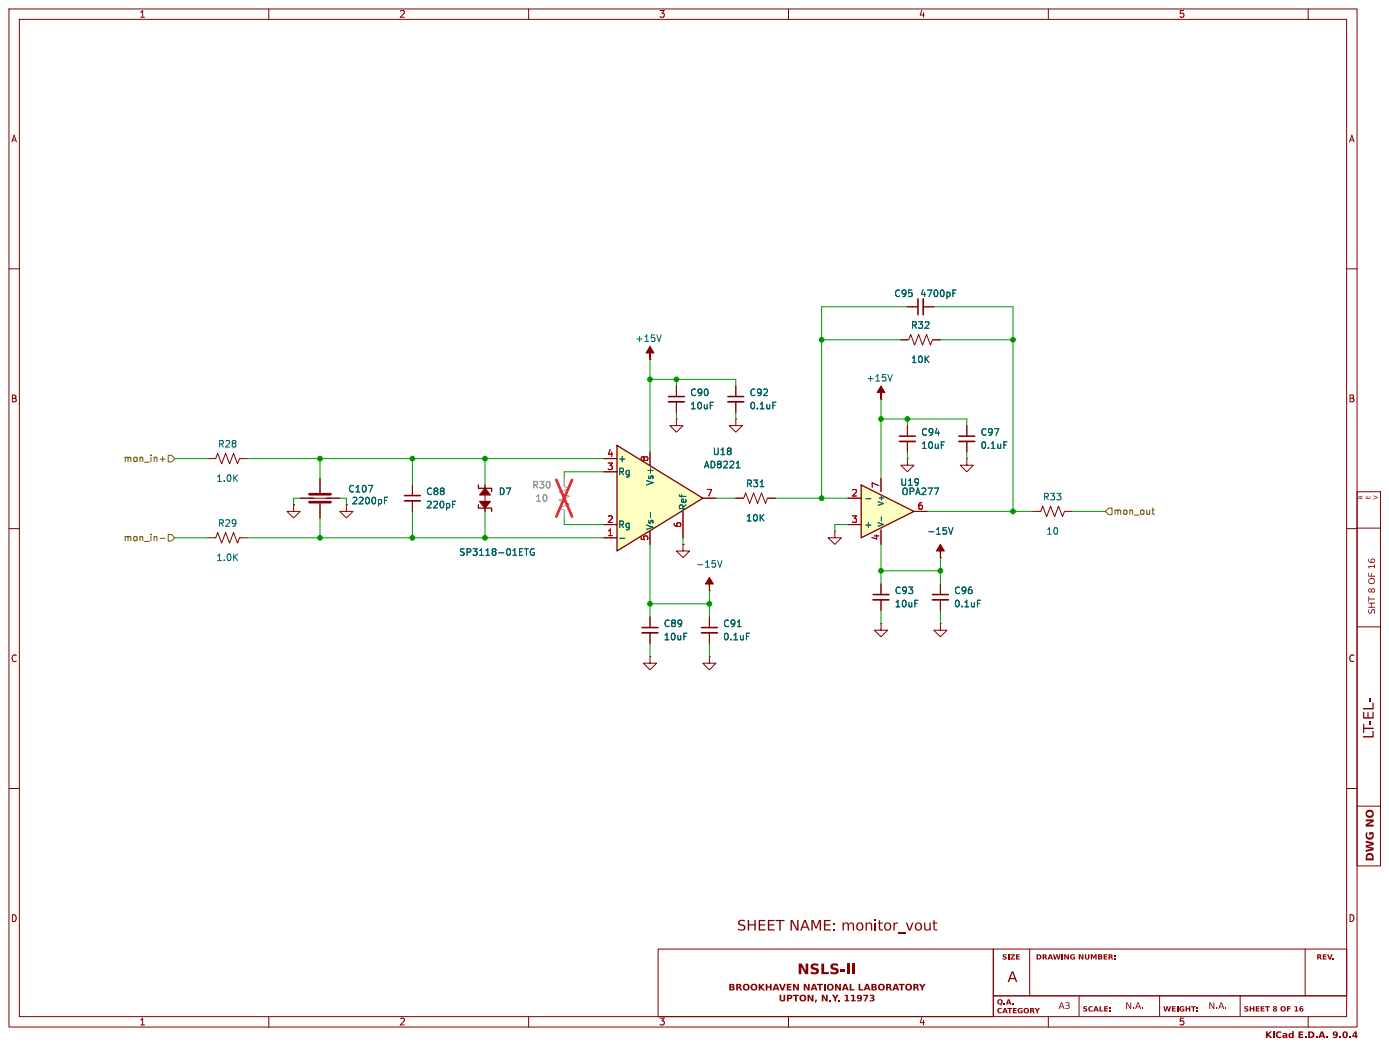
[picture p25: page 8]

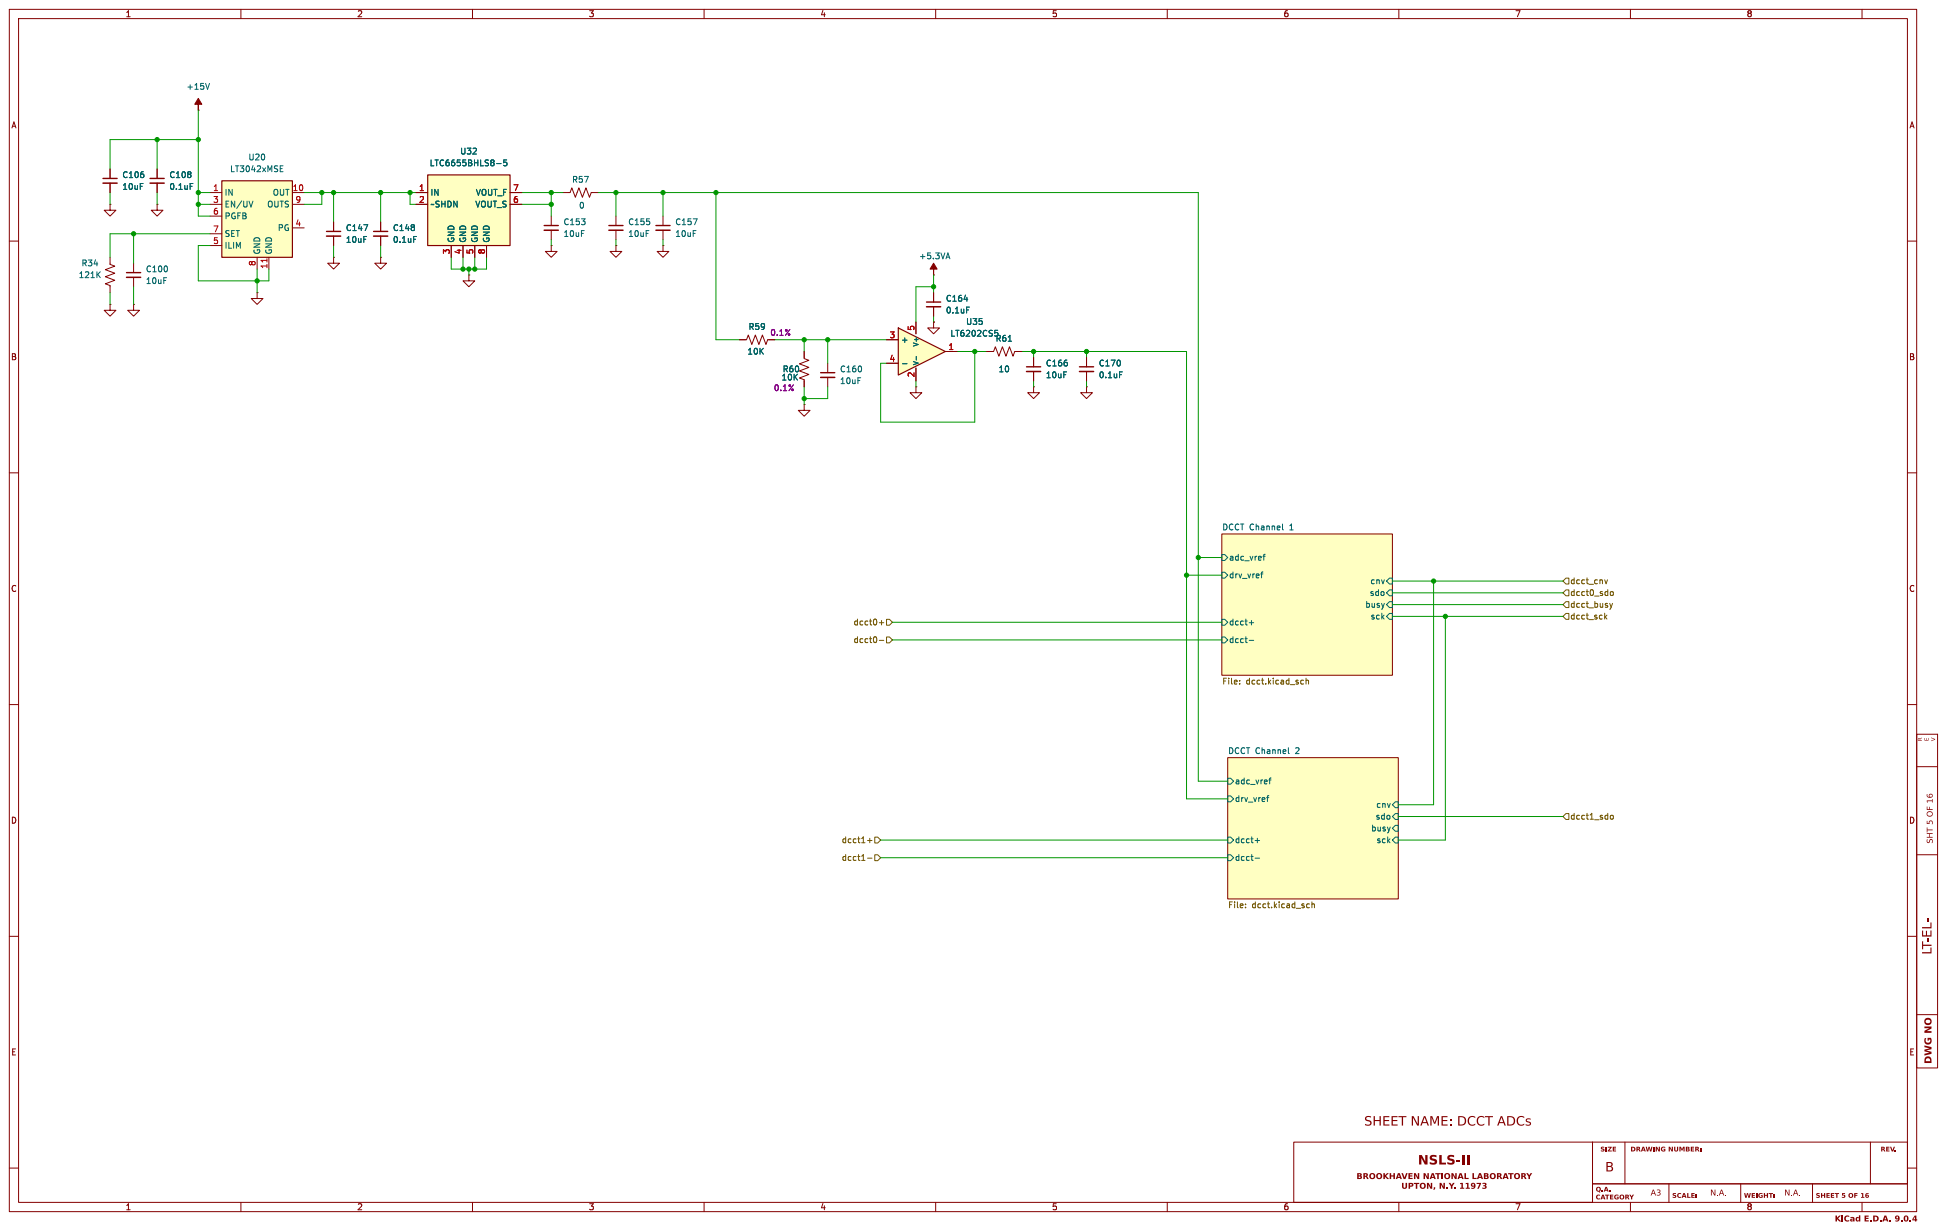
[picture p26: page 9]

8 GND 11 OUT 10 OUTS 9 PG 4 U20

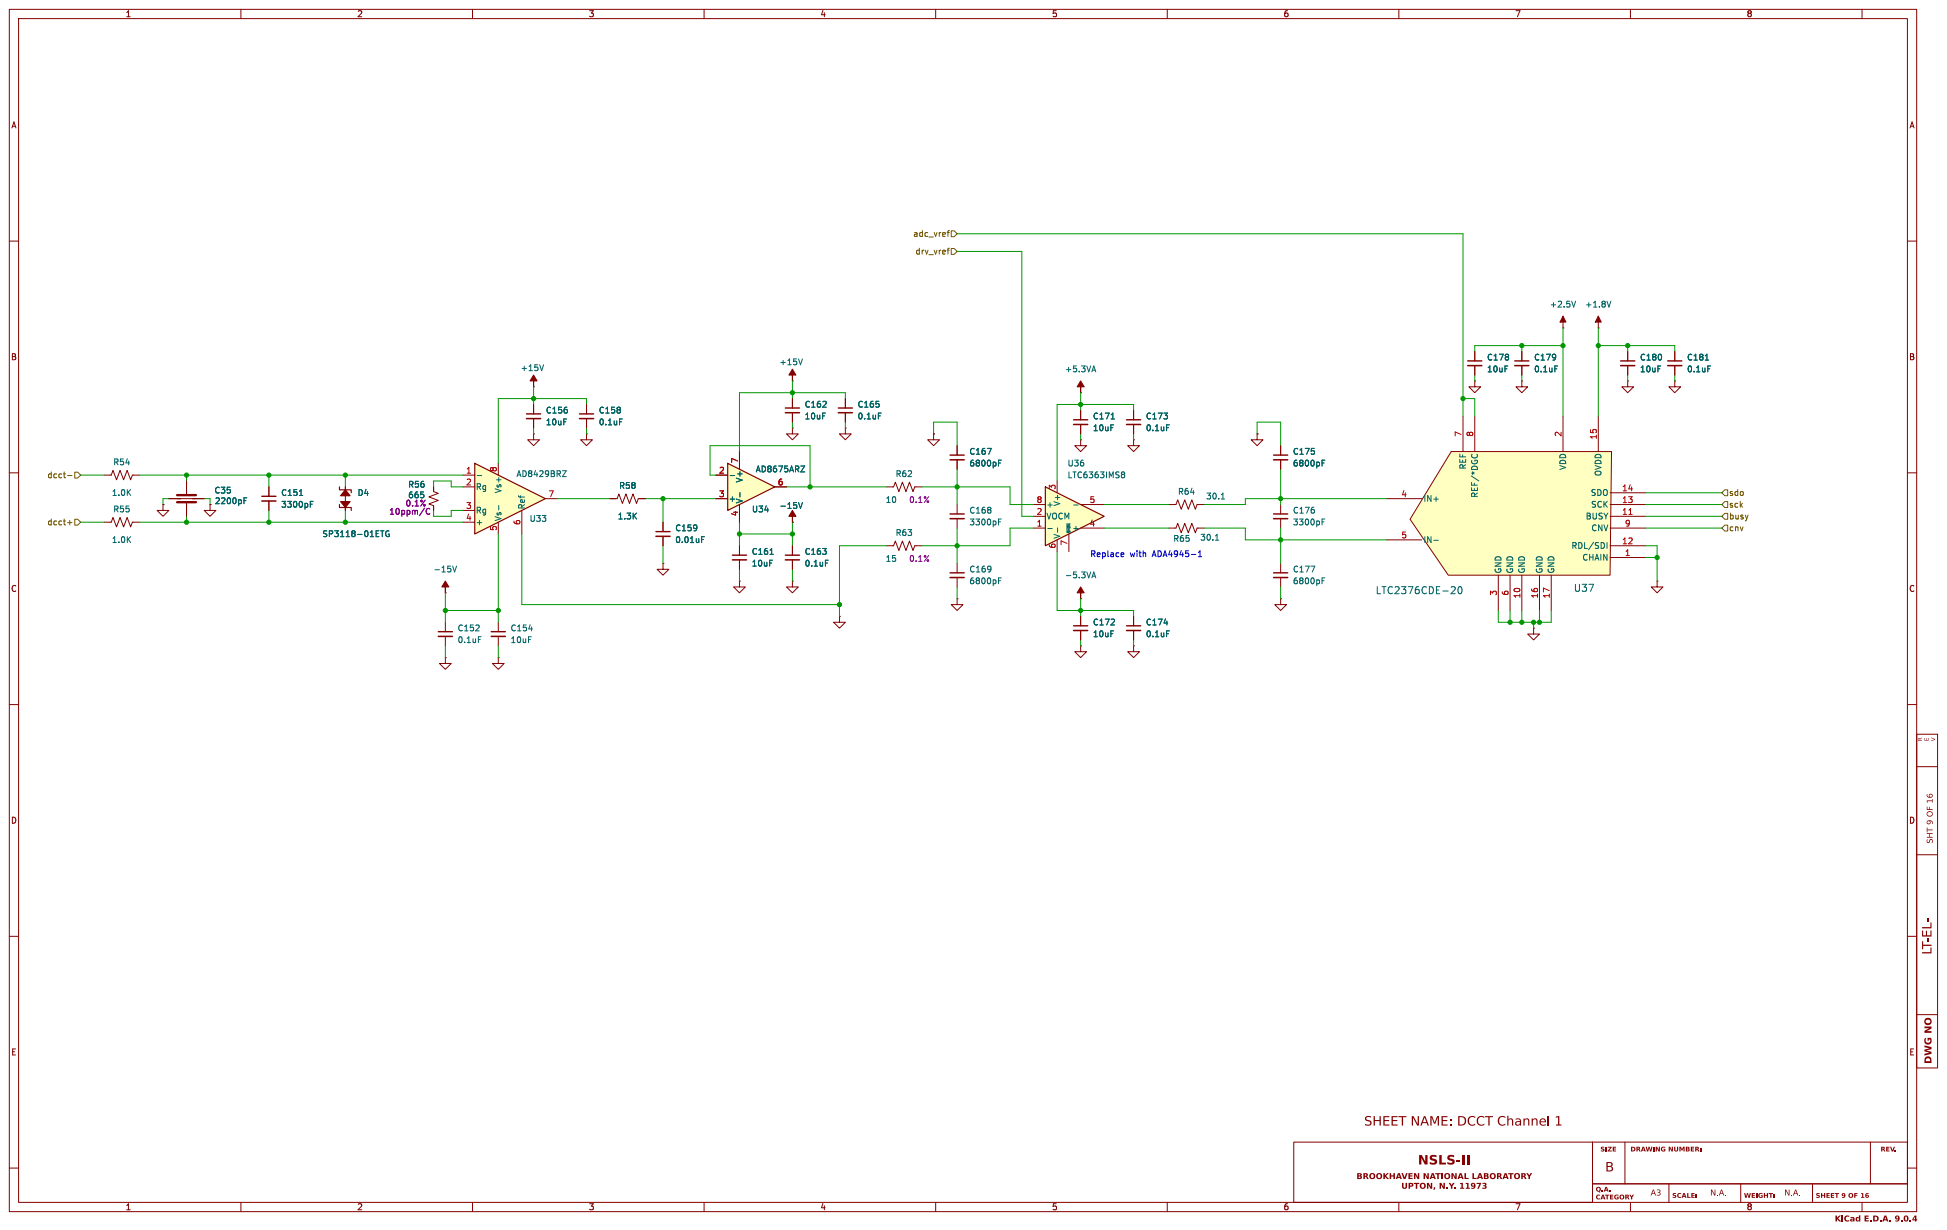
[picture p27: page 10]

6 GND 10 GND 16 GND 17 VDD

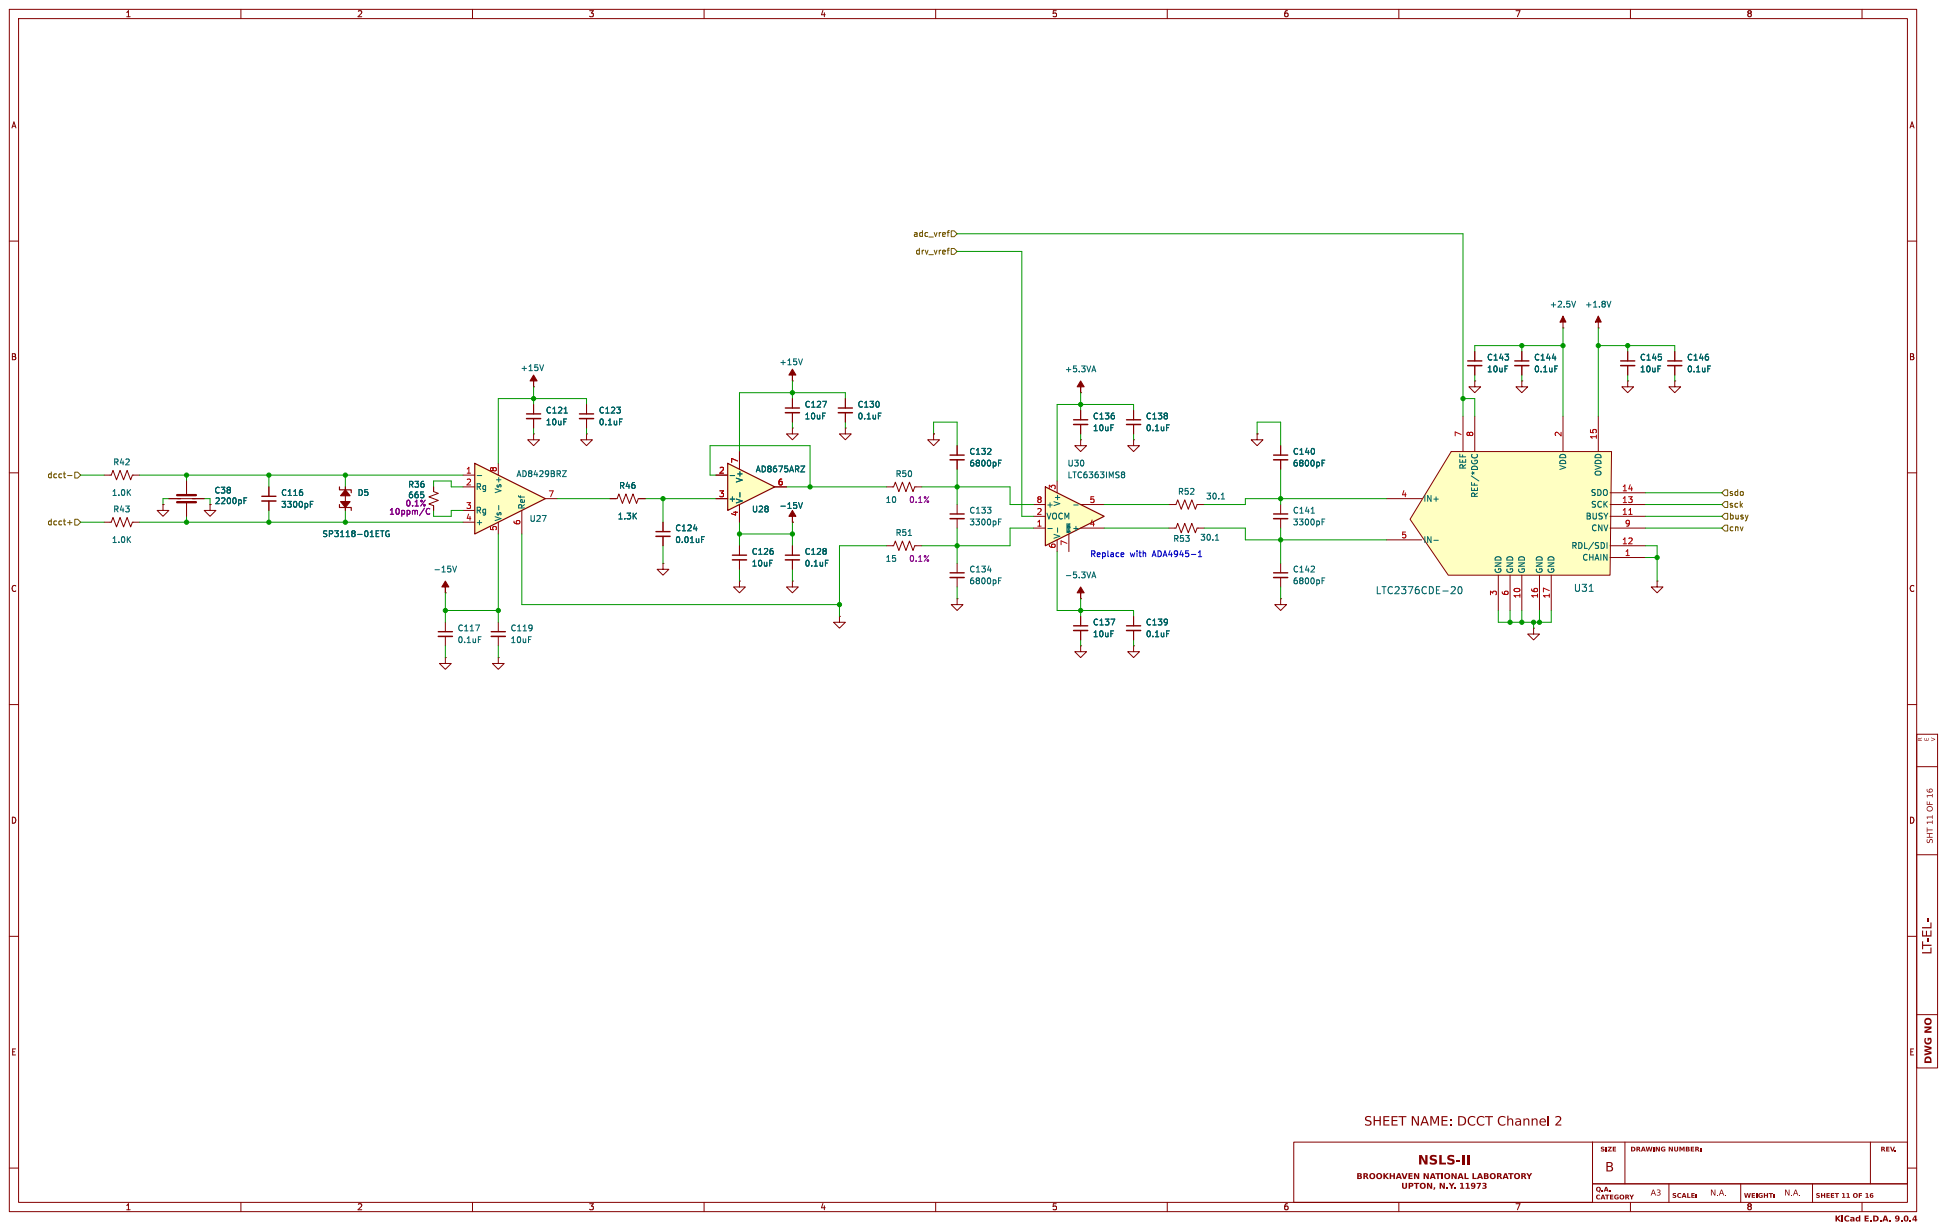
[picture p28: page 11]

6 GND 10 GND 16 GND 17 VDD

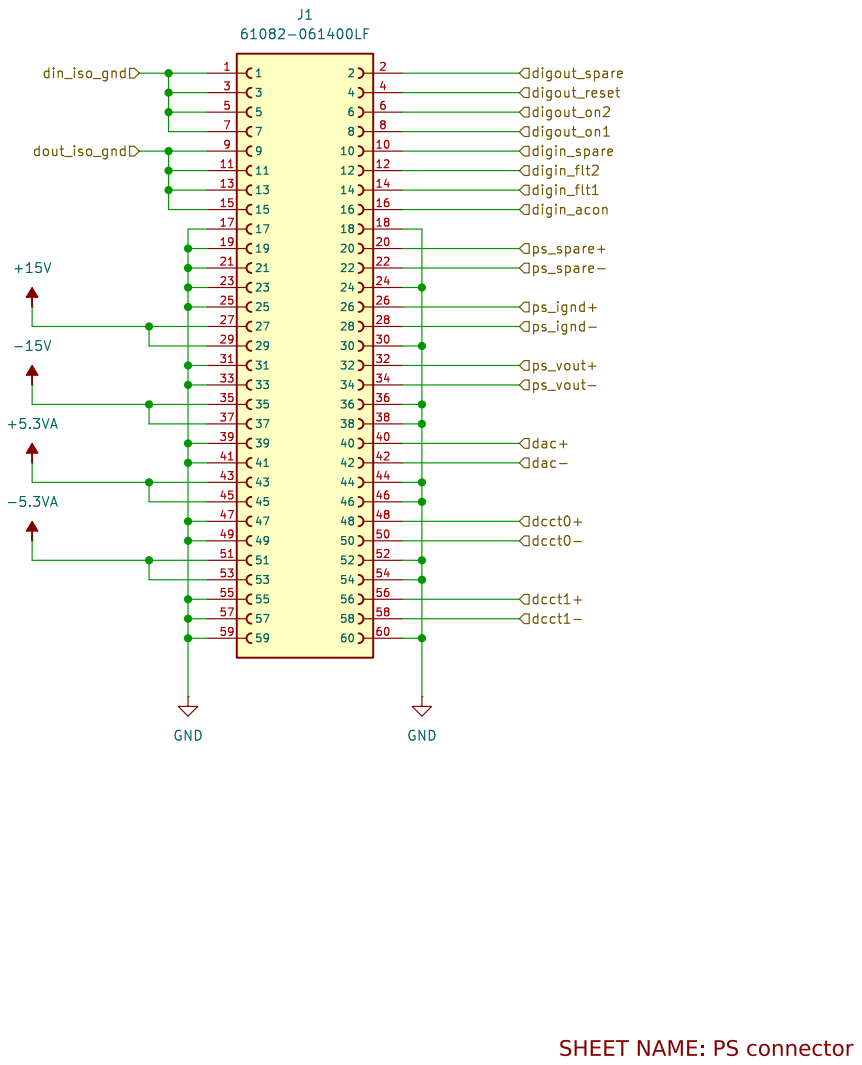
[picture p29: page 12]

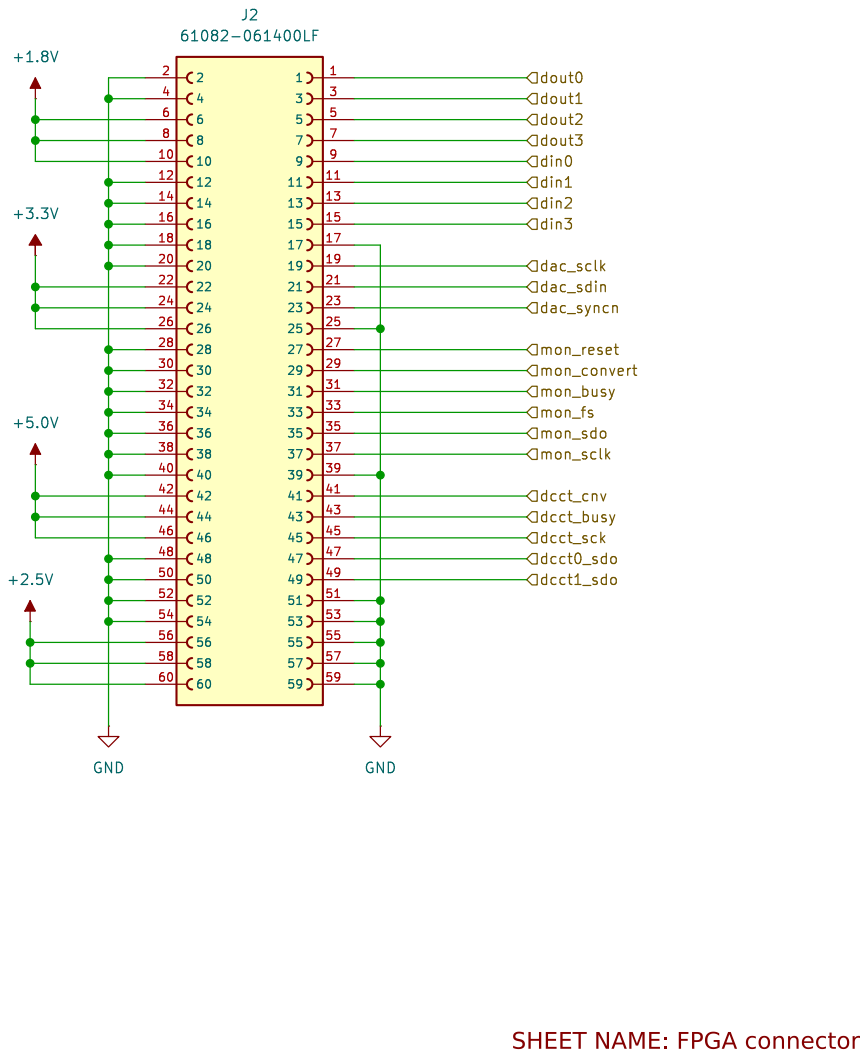
[picture p30: page 13]

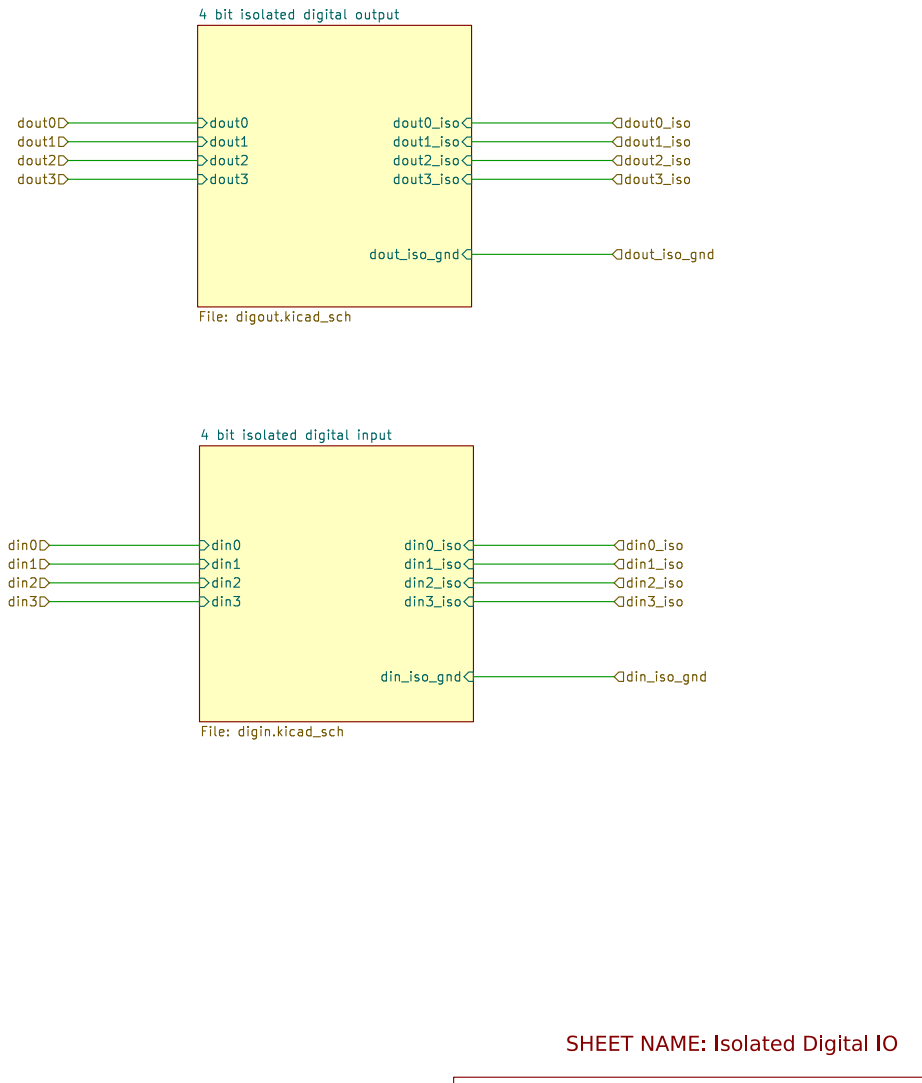
[picture p31: page 14]

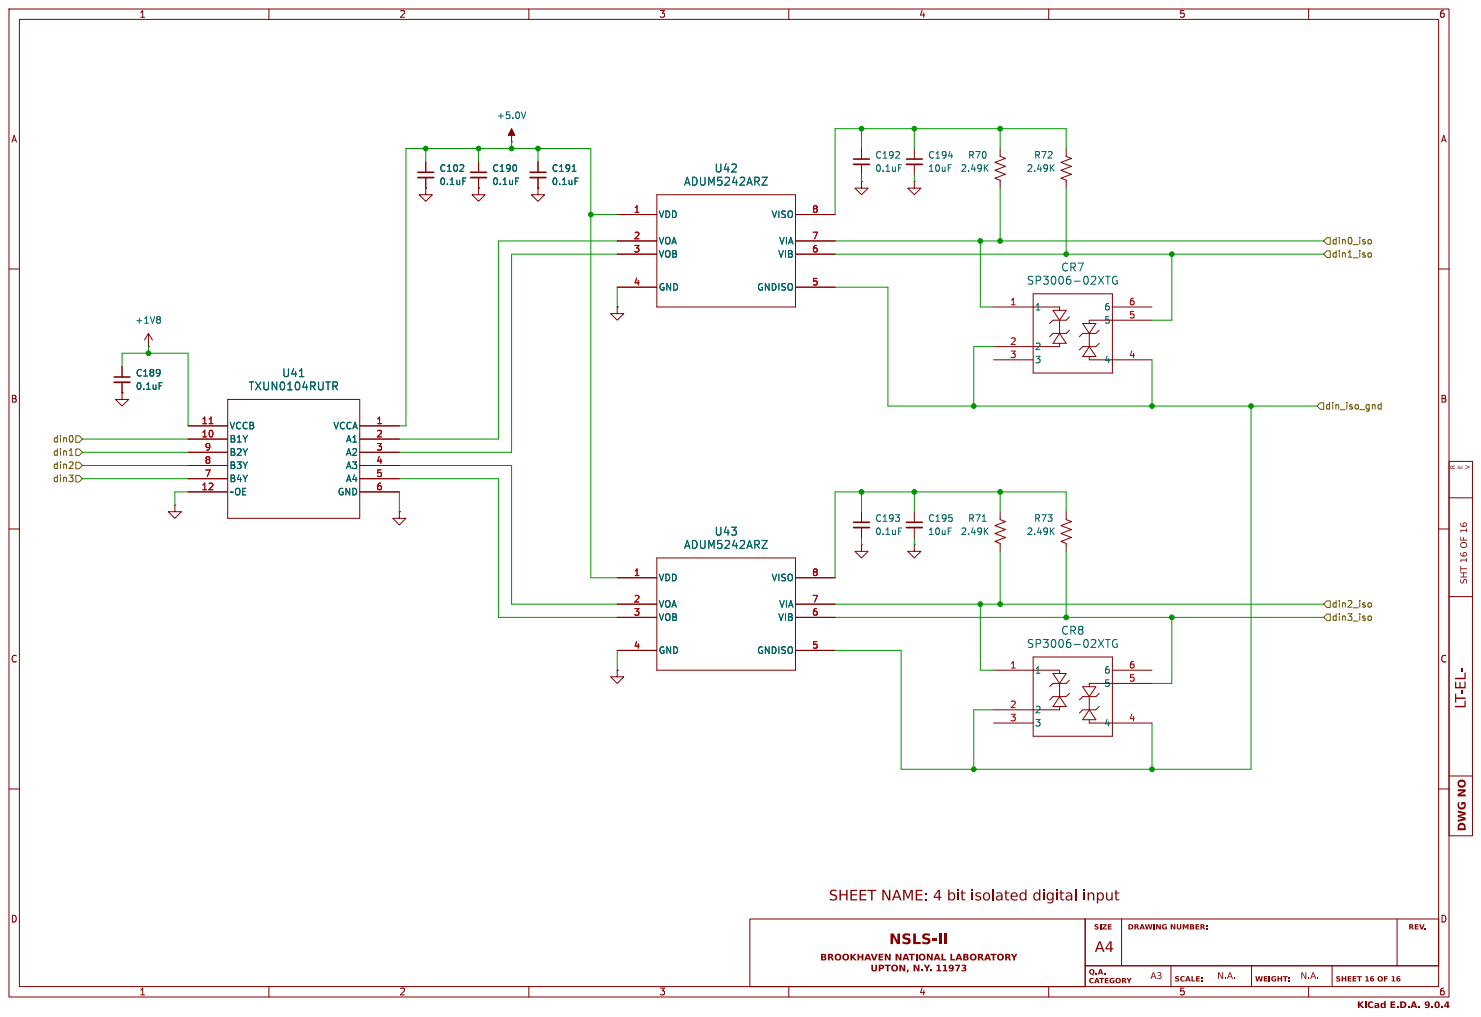
[picture p32: page 15]

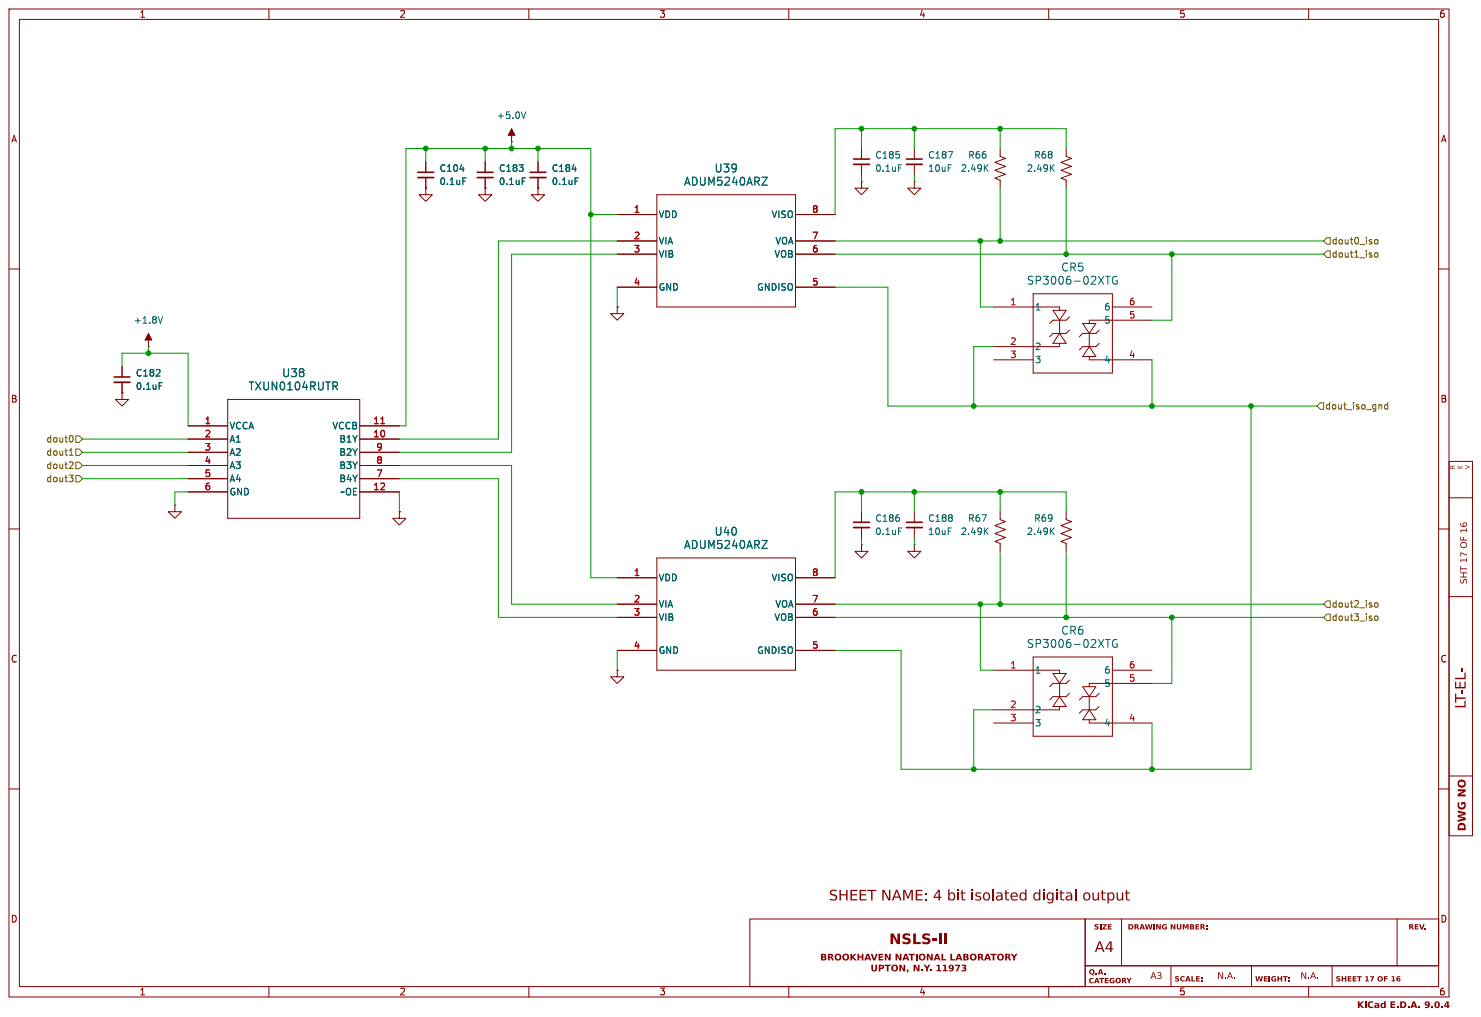
[picture p33: page 16]
