jamead/psc_daughter_brd/psc_daughter_brd.kicad_pcb

## KiCad design psc_daughter_brd.kicad_pcb (2025-12-03)

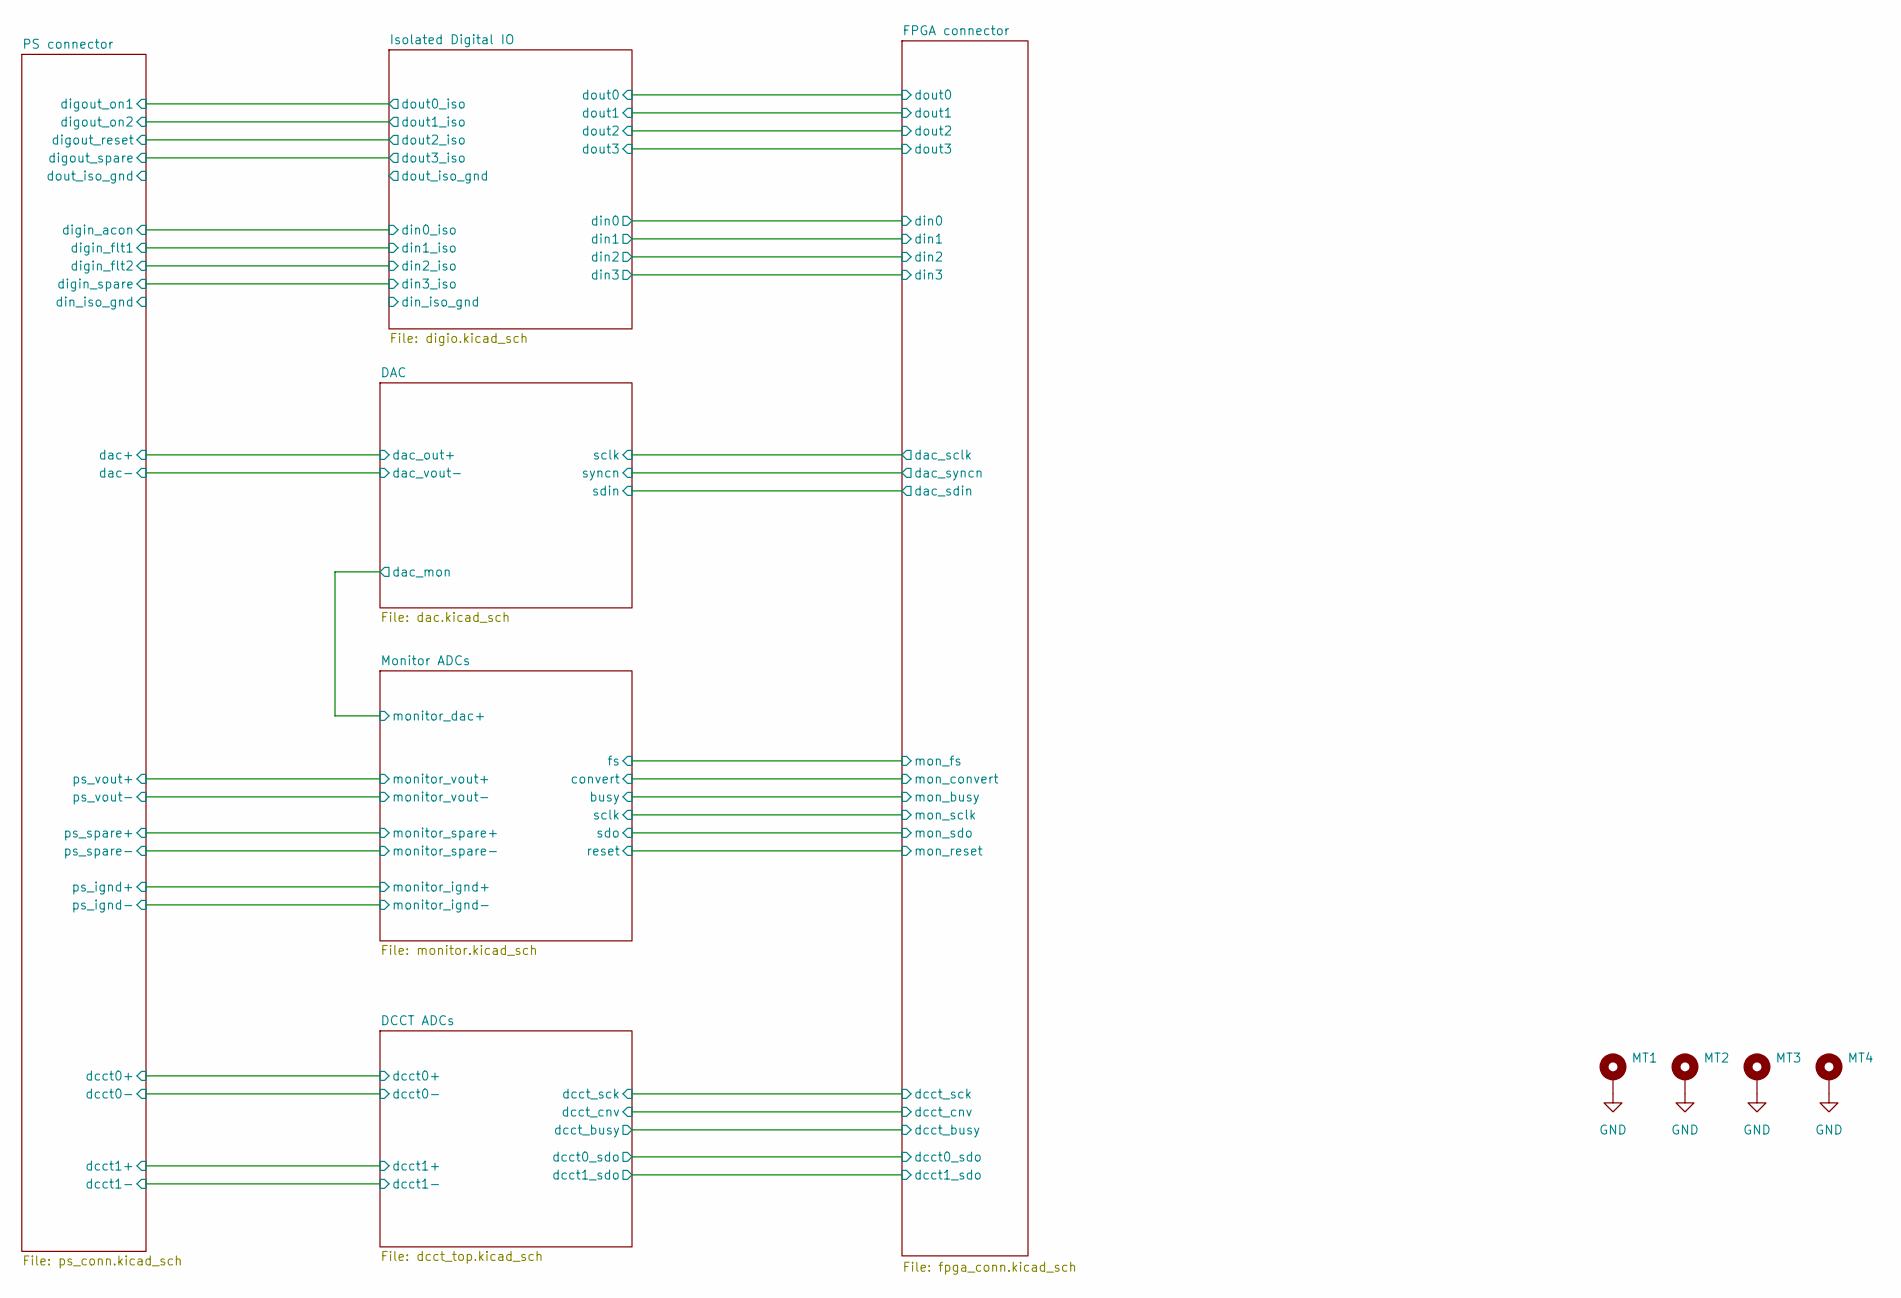
[picture p34: schematic psc_daughter_brd.kicad_sch, Power Supply Controller Daughterboard]

Parts:
MT1, MT2, MT3, MT4: MountingHole_Pad; MountingHole_3.2mm_M3_Pad_TopBottom

Connections:
GND: MT1.1, MT2.1, MT3.1, MT4.1; also elsewhere on the board

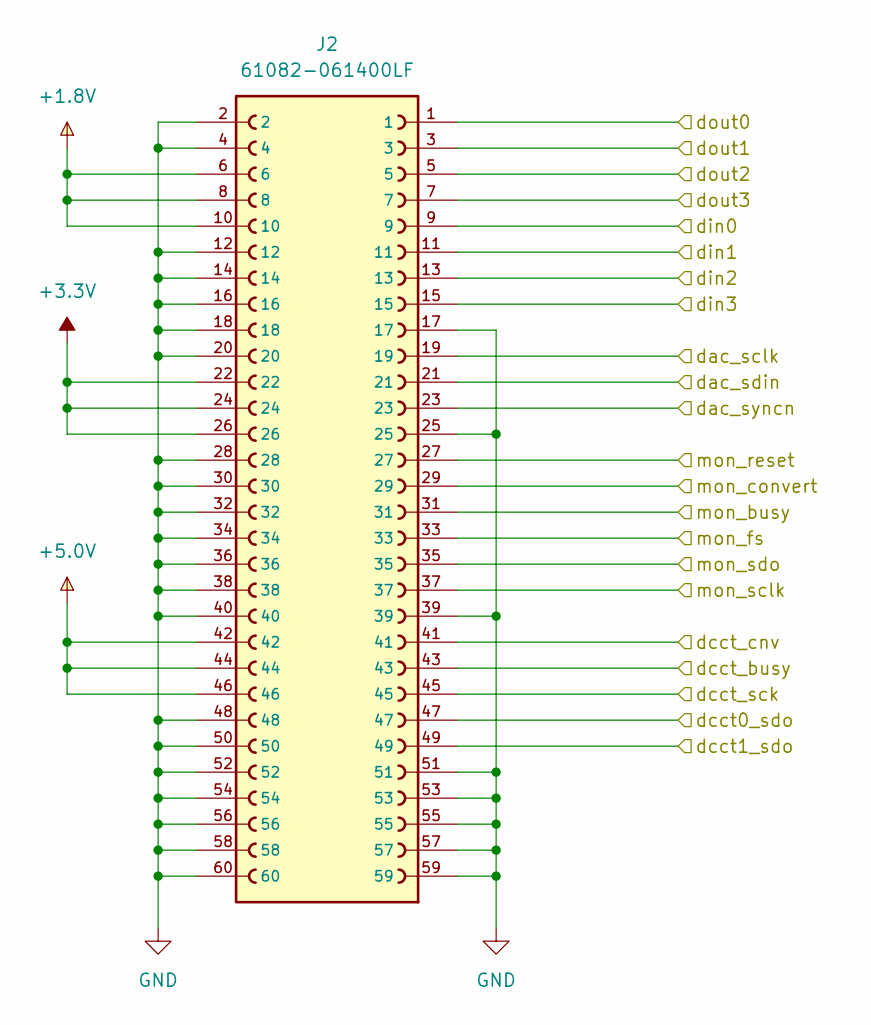
[picture p35: schematic fpga_conn.kicad_sch]

Parts:
J2: 61082-061400LF; AMPHENOL_61082-061400LF; PARTREV AS

Connections:
+1.8V: J2.6, J2.8, J2.10; also elsewhere on the board
+3.3V: J2.22, J2.24, J2.26; also elsewhere on the board
+5.0V: J2.42, J2.44, J2.46; also elsewhere on the board
/DAC/sclk: J2.19; also elsewhere on the board
/DAC/sdin: J2.21; also elsewhere on the board
/DAC/syncn: J2.23; also elsewhere on the board
/DCCT ADCs/dcct0_sdo: J2.47; also elsewhere on the board
/DCCT ADCs/dcct1_sdo: J2.49; also elsewhere on the board
/DCCT ADCs/dcct_busy: J2.43; also elsewhere on the board
/DCCT ADCs/dcct_cnv: J2.41; also elsewhere on the board
/DCCT ADCs/dcct_sck: J2.45; also elsewhere on the board
/FPGA connector/din0: J2.9; also elsewhere on the board
/FPGA connector/din1: J2.11; also elsewhere on the board
/FPGA connector/din2: J2.13; also elsewhere on the board
/FPGA connector/din3: J2.15; also elsewhere on the board
/FPGA connector/dout0: J2.1; also elsewhere on the board
/FPGA connector/dout1: J2.3; also elsewhere on the board
/FPGA connector/dout2: J2.5; also elsewhere on the board
/FPGA connector/dout3: J2.7; also elsewhere on the board
/FPGA connector/mon_busy: J2.31; also elsewhere on the board
/FPGA connector/mon_convert: J2.29; also elsewhere on the board
/FPGA connector/mon_fs: J2.33; also elsewhere on the board
/FPGA connector/mon_reset: J2.27; also elsewhere on the board
/FPGA connector/mon_sclk: J2.37; also elsewhere on the board
/FPGA connector/mon_sdo: J2.35; also elsewhere on the board
GND: J2.2, J2.4, J2.12, J2.14, J2.16, J2.17, J2.18, J2.20, J2.25, J2.28, J2.30, J2.32, J2.34, J2.36, J2.38, J2.39, J2.40, J2.48, J2.50, J2.51, J2.52, J2.53, J2.54, J2.55, J2.56, J2.57, J2.58, J2.59, J2.60; also elsewhere on the board

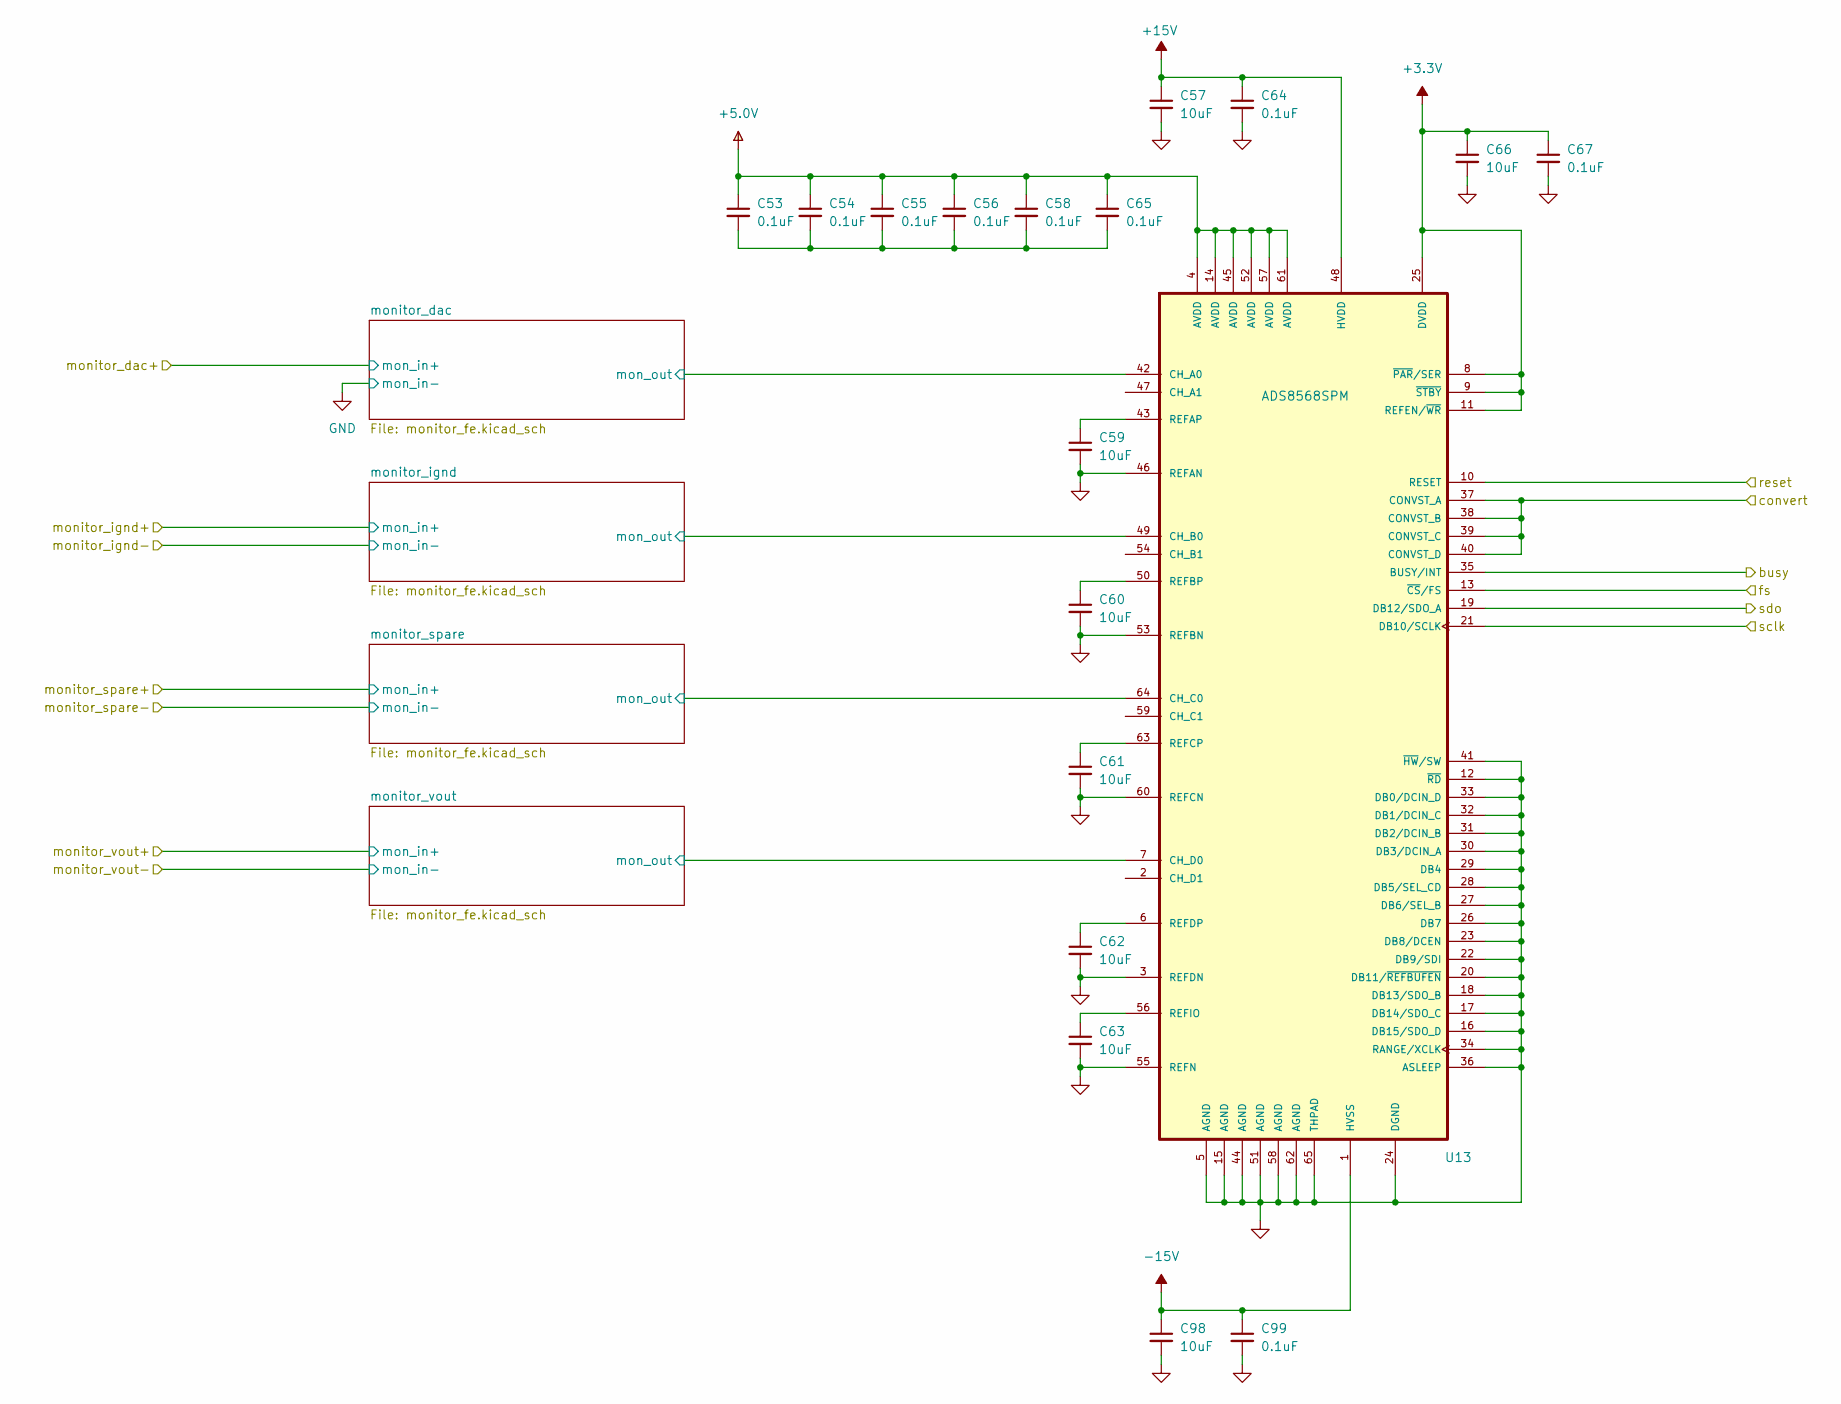
[picture p36: schematic monitor.kicad_sch]

Parts:
C53, C54, C55, C56, C58, C64, C65, C67, C99: 0.1uF; C_0402_1005Metric
C57, C59, C60, C61, C62, C63, C66, C98: 10uF; C_0603_1608Metric; Voltage 25V
U13: ADS8568SPM; QFP50P1200X1200X160-64N

Connections:
+3.3V: C66.1, C67.1, U13.8 (~PAR/SER), U13.9 (~STBY), U13.11 (REFEN/~WR), U13.25 (DVDD); also elsewhere on the board
+5.0V: C53.1, C54.1, C55.1, C56.1, C58.1, C65.1, U13.4 (AVDD), U13.14 (AVDD), U13.45 (AVDD), U13.52 (AVDD), U13.57 (AVDD), U13.61 (AVDD); also elsewhere on the board
+15V: C57.1, C64.1, U13.48 (HVDD); also elsewhere on the board
-15V: C98.1, C99.1, U13.1 (HVSS); also elsewhere on the board
/FPGA connector/mon_busy: U13.35 (BUSY/INT); also elsewhere on the board
/FPGA connector/mon_convert: U13.37 (CONVST_A), U13.38 (CONVST_B), U13.39 (CONVST_C), U13.40 (CONVST_D); also elsewhere on the board
/FPGA connector/mon_fs: U13.13 (~CS/FS); also elsewhere on the board
/FPGA connector/mon_reset: U13.10 (RESET); also elsewhere on the board
/FPGA connector/mon_sclk: U13.21 (DB10/SCLK); also elsewhere on the board
/FPGA connector/mon_sdo: U13.19 (DB12/SDO_A); also elsewhere on the board
/Monitor ADCs/monitor_dac/mon_out: U13.42 (CH_A0); also elsewhere on the board
/Monitor ADCs/monitor_ignd/mon_out: U13.49 (CH_B0); also elsewhere on the board
/Monitor ADCs/monitor_spare/mon_out: U13.64 (CH_C0); also elsewhere on the board
/Monitor ADCs/monitor_vout/mon_out: U13.7 (CH_D0); also elsewhere on the board
GND: C57.2, C59.2, C60.2, C61.2, C62.2, C63.2, C64.2, C66.2, C67.2, C98.2, C99.2, U13.3 (REFDN), U13.5 (AGND), U13.12 (~RD), U13.15 (AGND), U13.16 (DB15/SDO_D), U13.17 (DB14/SDO_C), U13.18 (DB13/SDO_B), U13.20 (DB11/~REFBUFEN), U13.22 (DB9/SDI), U13.23 (DB8/DCEN), U13.24 (DGND), U13.26 (DB7), U13.27 (DB6/SEL_B), U13.28 (DB5/SEL_CD), U13.29 (DB4), U13.30 (DB3/DCIN_A), U13.31 (DB2/DCIN_B), U13.32 (DB1/DCIN_C), U13.33 (DB0/DCIN_D), U13.34 (RANGE/XCLK), U13.36 (ASLEEP), U13.41 (~HW/SW), U13.44 (AGND), U13.46 (REFAN), U13.51 (AGND), U13.53 (REFBN), U13.55 (REFN), U13.58 (AGND), U13.60 (REFCN), U13.62 (AGND), U13.65 (THPAD); also elsewhere on the board
unnamed: C53.2, C54.2, C55.2, C56.2, C58.2, C65.2
unnamed: C59.1, U13.43 (REFAP)
unnamed: C60.1, U13.50 (REFBP)
unnamed: C61.1, U13.63 (REFCP)
unnamed: C62.1, U13.6 (REFDP)
unnamed: C63.1, U13.56 (REFIO)

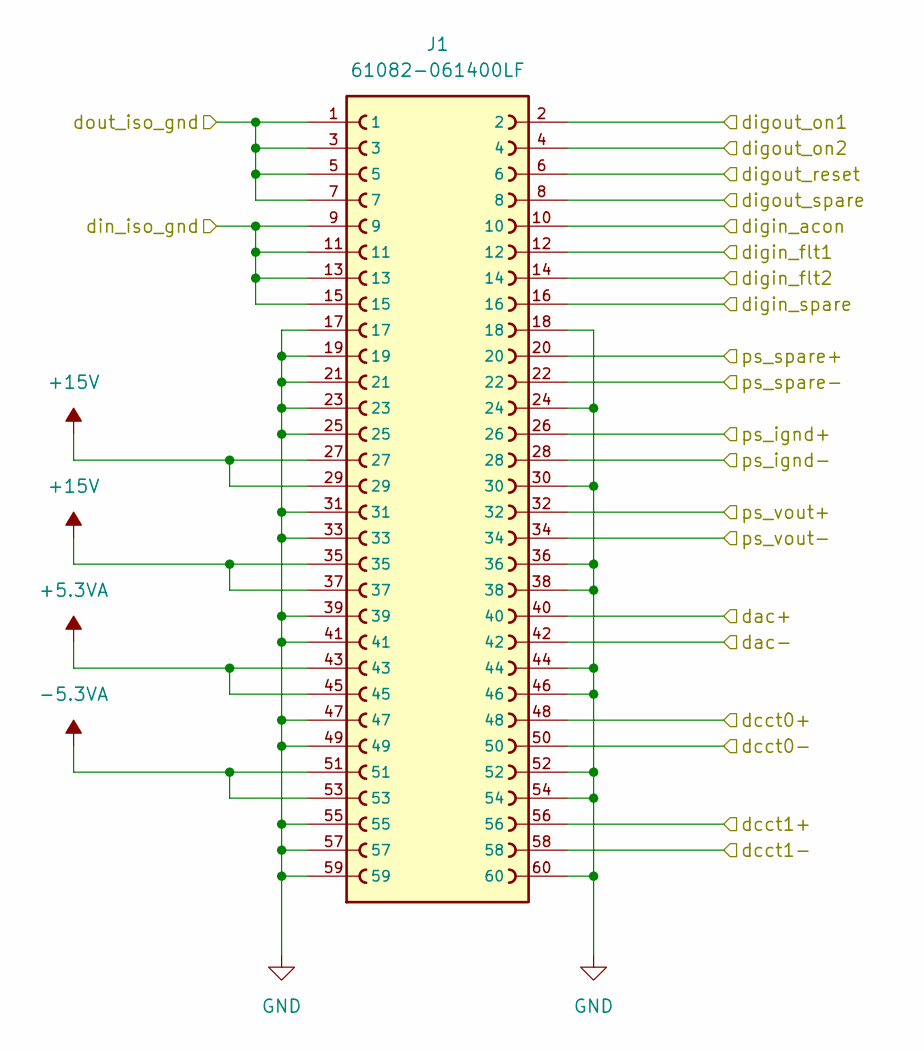
[picture p37: schematic ps_conn.kicad_sch]

Parts:
J1: 61082-061400LF; AMPHENOL_61082-061400LF; PARTREV AS

Connections:
+5.3VA: J1.43, J1.45; also elsewhere on the board
+15V: J1.27, J1.29, J1.35, J1.37; also elsewhere on the board
-5.3VA: J1.51, J1.53; also elsewhere on the board
/DAC/dac_out+: J1.40; also elsewhere on the board
/DAC/dac_vout-: J1.42; also elsewhere on the board
/DCCT ADCs/dcct0+: J1.48; also elsewhere on the board
/DCCT ADCs/dcct0-: J1.50; also elsewhere on the board
/DCCT ADCs/dcct1+: J1.56; also elsewhere on the board
/DCCT ADCs/dcct1-: J1.58; also elsewhere on the board
/Isolated Digital IO/din0_iso: J1.10; also elsewhere on the board
/Isolated Digital IO/din1_iso: J1.12; also elsewhere on the board
/Isolated Digital IO/din2_iso: J1.14; also elsewhere on the board
/Isolated Digital IO/din3_iso: J1.16; also elsewhere on the board
/Isolated Digital IO/dout0_iso: J1.2; also elsewhere on the board
/Isolated Digital IO/dout1_iso: J1.4; also elsewhere on the board
/Isolated Digital IO/dout2_iso: J1.6; also elsewhere on the board
/Isolated Digital IO/dout3_iso: J1.8; also elsewhere on the board
/Monitor ADCs/monitor_ignd+: J1.26; also elsewhere on the board
/Monitor ADCs/monitor_ignd-: J1.28; also elsewhere on the board
/Monitor ADCs/monitor_spare+: J1.20; also elsewhere on the board
/Monitor ADCs/monitor_spare-: J1.22; also elsewhere on the board
/Monitor ADCs/monitor_vout+: J1.32; also elsewhere on the board
/Monitor ADCs/monitor_vout-: J1.34; also elsewhere on the board
/PS connector/din_iso_gnd: J1.9, J1.11, J1.13, J1.15
/PS connector/dout_iso_gnd: J1.1, J1.3, J1.5, J1.7
GND: J1.17, J1.18, J1.19, J1.21, J1.23, J1.24, J1.25, J1.30, J1.31, J1.33, J1.36, J1.38, J1.39, J1.41, J1.44, J1.46, J1.47, J1.49, J1.52, J1.54, J1.55, J1.57, J1.59, J1.60; also elsewhere on the board

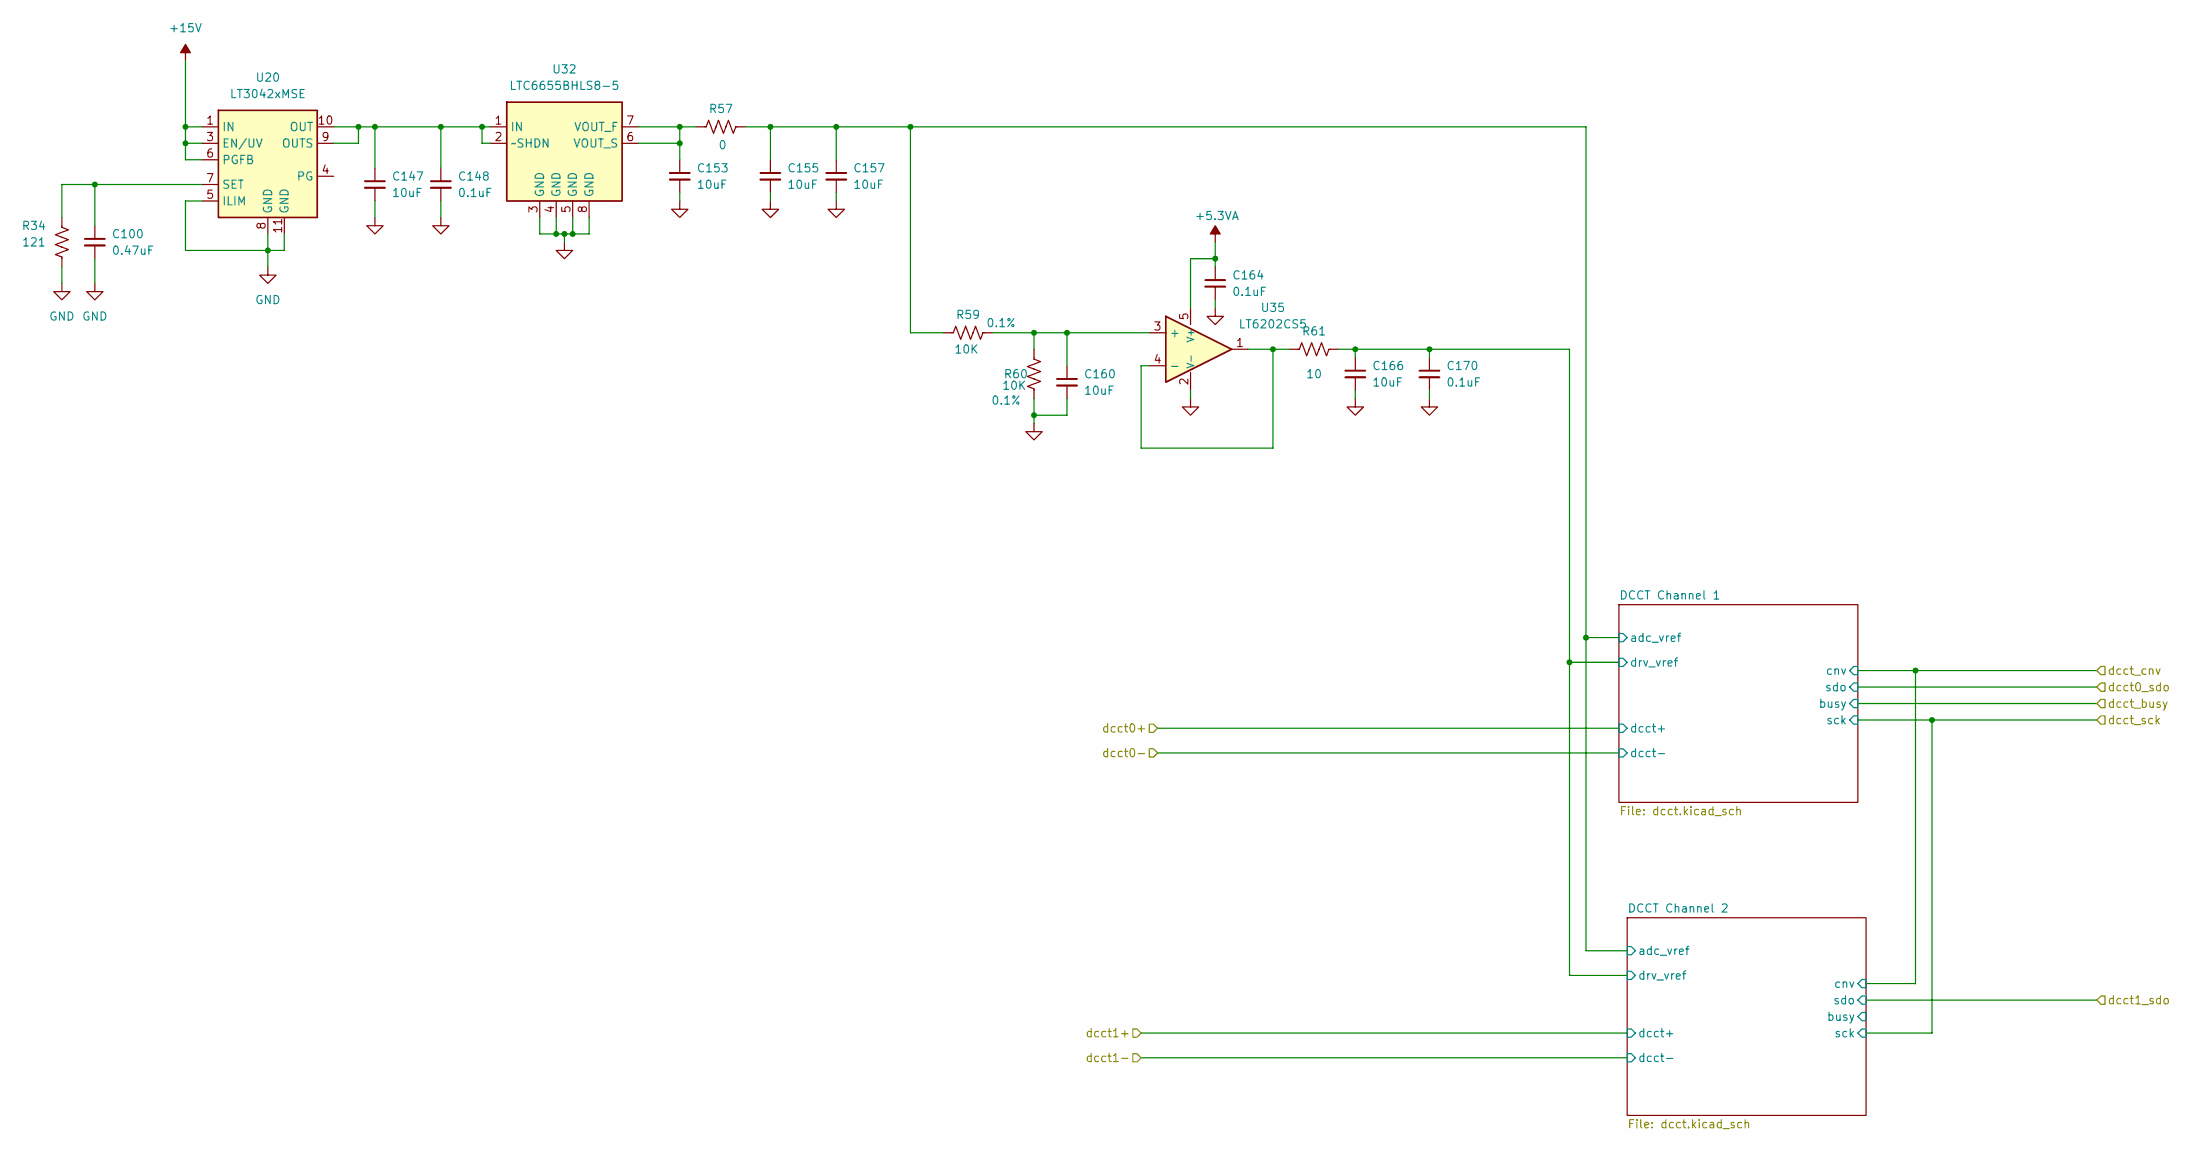
[picture p38: schematic dcct_top.kicad_sch]

Parts:
C100: 0.47uF; C_0402_1005Metric
C147, C153, C155, C157, C160, C166: 10uF; C_0603_1608Metric; Voltage 25V
C148, C164, C170: 0.1uF; C_0402_1005Metric
R34: 121; R_0402_1005Metric; Tolerance 1%
R57: 0; R_0402_1005Metric; Tolerance 1%
R59, R60: 10K; R_0402_1005Metric; Tolerance 0.1%
R61: 10; R_0402_1005Metric; Tolerance 1%
U20: LT3042xMSE; MSOP-10-1EP_3x3mm_P0.5mm_EP1.68x1.88mm
U32: LTC6655BHLS8-5; LTC6655
U35: LT6202CS5

Connections:
+5.3VA: C164.1, U35.5 (V+); also elsewhere on the board
+15V: U20.1 (IN), U20.2 (IN), U20.3 (EN/UV), U20.6 (PGFB); also elsewhere on the board
/DCCT ADCs/DCCT Channel 1/adc_vref: C155.1, C157.1, R57.1, R59.2; also elsewhere on the board
/DCCT ADCs/DCCT Channel 1/drv_vref: C166.1, C170.1, R61.1; also elsewhere on the board
GND: C100.2, C147.2, C148.2, C153.2, C155.2, C157.2, C160.2, C164.2, C166.2, C170.2, R34.1, R60.2, U20.5 (ILIM), U20.8 (GND), U20.11 (GND), U32.3 (GND), U32.4 (GND), U32.5 (GND), U32.8 (GND), U35.2 (V-); also elsewhere on the board
unnamed: C147.1, C148.1, U20.9 (OUTS), U20.10 (OUT), U32.1 (IN), U32.2 (~SHDN)
unnamed: C100.1, R34.2, U20.7 (SET)
unnamed: C153.1, R57.2, U32.6 (VOUT_S), U32.7 (VOUT_F)
unnamed: C160.1, R59.1, R60.1, U35.3 (+)
unnamed: R61.2, U35.1, U35.4 (-)

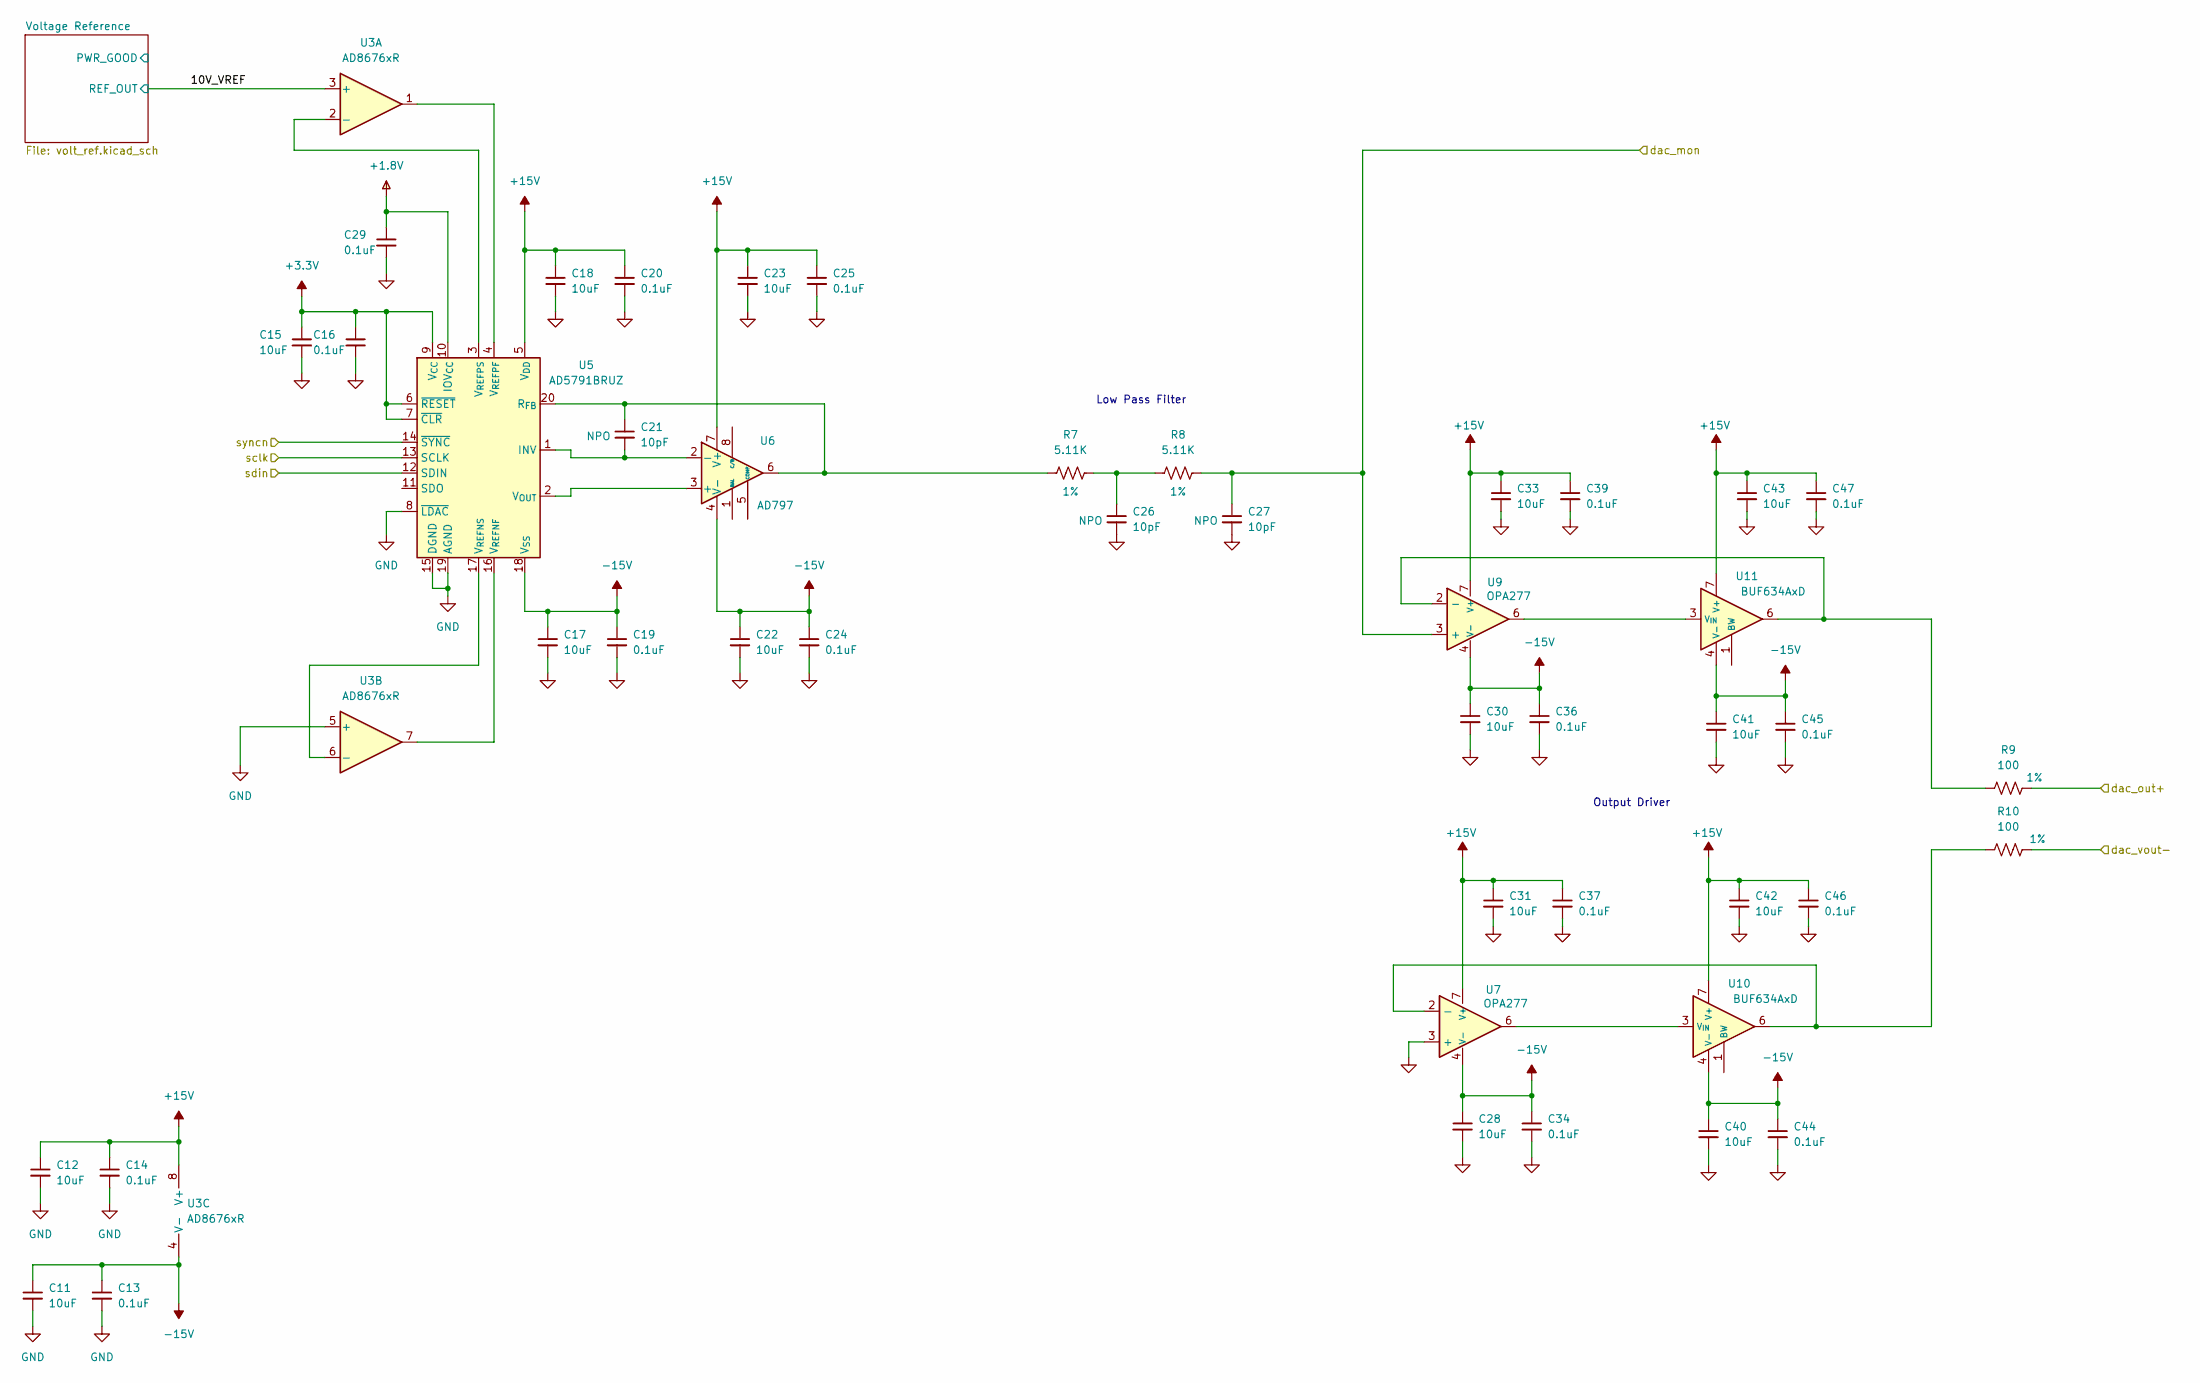
[picture p39: schematic dac.kicad_sch]

Parts:
C11, C12, C15, C17, C18, C22, C23, C28, C30, C31, C33, C40, C41, C42, C43: 10uF; C_0603_1608Metric; Voltage 25V
C13, C14, C16, C19, C20, C24, C25, C29, C34, C36, C37, C39, C44, C45, C46, C47: 0.1uF; C_0402_1005Metric
C21, C26, C27: 10pF; C_0402_1005Metric
R7, R8: 5.11K; R_0402_1005Metric; Tolerance 1%
R9, R10: 100; R_0603_1608Metric; Tolerance 1%
U3: AD8676xR; SOIC-8_3.9x4.9mm_P1.27mm
U5: AD5791BRUZ; TSSOP-20_4.4x6.5mm_P0.65mm
U6: AD797; SOIC-8_3.9x4.9mm_P1.27mm
U7, U9: OPA277; SOIC-8_3.9x4.9mm_P1.27mm
U10, U11: BUF634AxD; SOIC-8_3.9x4.9mm_P1.27mm

Connections:
+1.8V: C29.1, U5.10 (IOV_{CC}); also elsewhere on the board
+3.3V: C15.1, C16.1, U5.6 (~RESET), U5.7 (~CLR), U5.9 (V_{CC}); also elsewhere on the board
+15V: C12.1, C14.1, C18.1, C20.1, C23.1, C25.1, C31.1, C33.1, C37.1, C39.1, C42.1, C43.1, C46.1, C47.1, U3.8 (V+), U5.5 (V_{DD}), U6.7 (V+), U7.7 (V+), U9.7 (V+), U10.7 (V+), U11.7 (V+); also elsewhere on the board
-15V: C11.1, C13.1, C17.1, C19.1, C22.1, C24.1, C28.1, C30.1, C34.1, C36.1, C40.1, C41.1, C44.1, C45.1, U3.4 (V-), U5.18 (V_{SS}), U6.4 (V-), U7.4 (V-), U9.4 (V-), U10.4 (V-), U11.4 (V-); also elsewhere on the board
/DAC/Voltage Reference/REF_OUT: U3.3 (+); also elsewhere on the board
/DAC/dac_mon: C27.1, R8.2, U9.3 (+); also elsewhere on the board
/DAC/dac_out+: R9.2; also elsewhere on the board
/DAC/dac_vout-: R10.2; also elsewhere on the board
/DAC/sclk: U5.13 (SCLK); also elsewhere on the board
/DAC/sdin: U5.12 (SDIN); also elsewhere on the board
/DAC/syncn: U5.14 (~SYNC); also elsewhere on the board
GND: C11.2, C12.2, C13.2, C14.2, C15.2, C16.2, C17.2, C18.2, C19.2, C20.2, C22.2, C23.2, C24.2, C25.2, C26.2, C27.2, C28.2, C29.2, C30.2, C31.2, C33.2, C34.2, C36.2, C37.2, C39.2, C40.2, C41.2, C42.2, C43.2, C44.2, C45.2, C46.2, C47.2, U3.5 (+), U5.8 (~LDAC), U5.15 (DGND), U5.19 (AGND), U7.3 (+); also elsewhere on the board
unnamed: C26.1, R7.2, R8.1
unnamed: U3.2 (-), U5.3 (V_{REFPS})
unnamed: U3.6 (-), U5.17 (V_{REFNS})
unnamed: C21.2, U5.1 (INV), U6.2 (-)
unnamed: C21.1, R7.1, U5.20 (R_{FB}), U6.6
unnamed: U5.2 (V_{OUT}), U6.3 (+)
unnamed: U3.7, U5.16 (V_{REFNF})
unnamed: U3.1, U5.4 (V_{REFPF})
unnamed: R10.1, U7.2 (-), U10.6
unnamed: R9.1, U9.2 (-), U11.6
unnamed: U7.6, U10.3 (V_{IN})
unnamed: U9.6, U11.3 (V_{IN})

Notes on the sheet:
Output Driver
Low Pass Filter

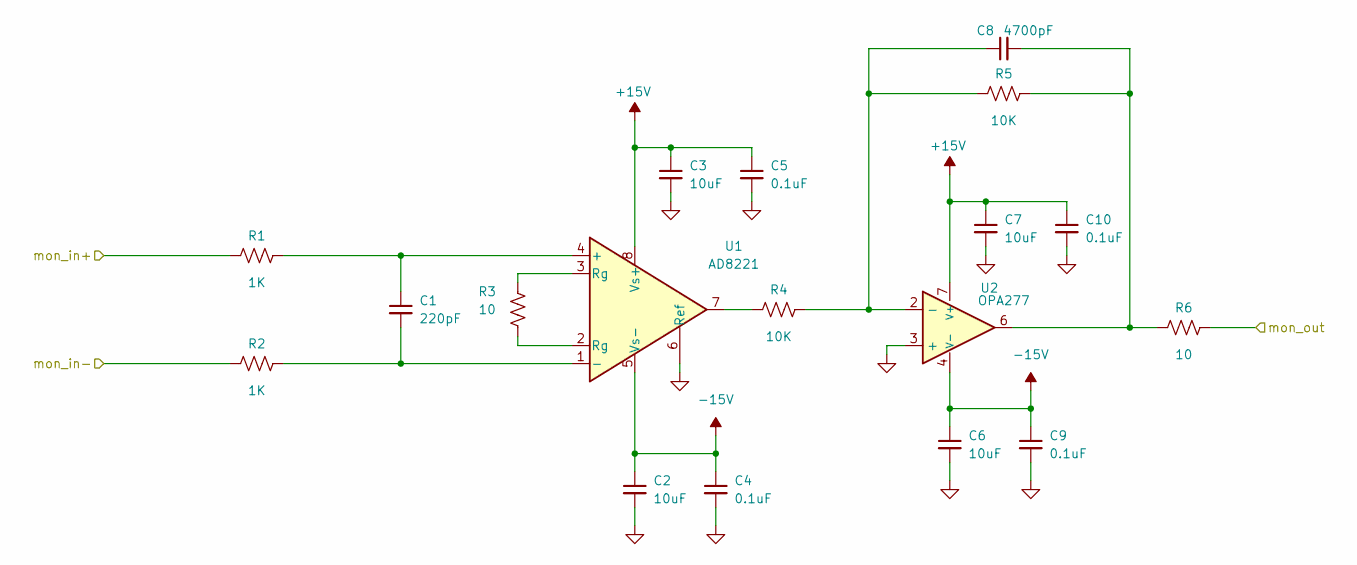
[picture p40: schematic monitor_fe.kicad_sch]

Parts:
C1: 220pF; C_0402_1005Metric
C2, C3, C6, C7: 10uF; C_0603_1608Metric; Voltage 25V
C4, C5, C9, C10: 0.1uF; C_0402_1005Metric
C8: 4700pF; C_0402_1005Metric
R1, R2: 1K; R_0402_1005Metric; Tolerance 1%
R3, R6: 10; R_0402_1005Metric; Tolerance 1%
R4, R5: 10K; R_0402_1005Metric; Tolerance 1%
U1: AD8221; SOIC127P600X175-8N
U2: OPA277; SOIC-8_3.9x4.9mm_P1.27mm

Connections:
+15V: C3.1, C5.1, C7.1, C10.1, U1.8 (Vs+), U2.7 (V+); also elsewhere on the board
-15V: C2.1, C4.1, C6.1, C9.1, U1.5 (Vs-), U2.4 (V-); also elsewhere on the board
/Monitor ADCs/monitor_ignd+: R1.2; also elsewhere on the board
/Monitor ADCs/monitor_ignd-: R2.2; also elsewhere on the board
/Monitor ADCs/monitor_ignd/mon_out: R6.1; also elsewhere on the board
GND: C2.2, C3.2, C4.2, C5.2, C6.2, C7.2, C9.2, C10.2, U1.6 (Ref), U2.3 (+); also elsewhere on the board
unnamed: C8.2, R5.1, R6.2, U2.6
unnamed: R3.1, U1.2 (Rg)
unnamed: R3.2, U1.3 (Rg)
unnamed: R4.2, U1.7
unnamed: C1.1, R1.1, U1.4 (+)
unnamed: C1.2, R2.1, U1.1 (-)
unnamed: C8.1, R4.1, R5.2, U2.2 (-)

Parts of its further copies:
C68, C78, C88: 220pF; C_0402_1005Metric
C69, C70, C73, C74, C79, C80, C83, C84, C89, C90, C93, C94: 10uF; C_0603_1608Metric; Voltage 25V
C71, C72, C76, C77, C81, C82, C86, C87, C91, C92, C96, C97: 0.1uF; C_0402_1005Metric
C75, C85, C95: 4700pF; C_0402_1005Metric
R16, R17, R22, R23, R28, R29: 1K; R_0402_1005Metric; Tolerance 1%
R18, R21, R24, R27, R30, R33: 10; R_0402_1005Metric; Tolerance 1%
R19, R20, R25, R26, R31, R32: 10K; R_0402_1005Metric; Tolerance 1%
U14, U16, U18: AD8221; SOIC127P600X175-8N
U15, U17, U19: OPA277; SOIC-8_3.9x4.9mm_P1.27mm

Connections of its further copies:
+15V: C70.1, C72.1, C74.1, C77.1, C80.1, C82.1, C84.1, C87.1, C90.1, C92.1, C94.1, C97.1, U14.8 (Vs+), U15.7 (V+), U16.8 (Vs+), U17.7 (V+), U18.8 (Vs+), U19.7 (V+); also elsewhere on the board
-15V: C69.1, C71.1, C73.1, C76.1, C79.1, C81.1, C83.1, C86.1, C89.1, C91.1, C93.1, C96.1, U14.5 (Vs-), U15.4 (V-), U16.5 (Vs-), U17.4 (V-), U18.5 (Vs-), U19.4 (V-); also elsewhere on the board
/DAC/dac_mon: R16.2; also elsewhere on the board
/Monitor ADCs/monitor_dac/mon_out: R21.1; also elsewhere on the board
/Monitor ADCs/monitor_spare+: R22.2; also elsewhere on the board
/Monitor ADCs/monitor_spare-: R23.2; also elsewhere on the board
/Monitor ADCs/monitor_spare/mon_out: R27.1; also elsewhere on the board
/Monitor ADCs/monitor_vout+: R28.2; also elsewhere on the board
/Monitor ADCs/monitor_vout-: R29.2; also elsewhere on the board
/Monitor ADCs/monitor_vout/mon_out: R33.1; also elsewhere on the board
GND: C69.2, C70.2, C71.2, C72.2, C73.2, C74.2, C76.2, C77.2, C79.2, C80.2, C81.2, C82.2, C83.2, C84.2, C86.2, C87.2, C89.2, C90.2, C91.2, C92.2, C93.2, C94.2, C96.2, C97.2, R17.2, U14.6 (Ref), U15.3 (+), U16.6 (Ref), U17.3 (+), U18.6 (Ref), U19.3 (+); also elsewhere on the board
unnamed: C75.2, R20.1, R21.2, U15.6
unnamed: C85.2, R26.1, R27.2, U17.6
unnamed: C95.2, R32.1, R33.2, U19.6
unnamed: R18.1, U14.2 (Rg)
unnamed: R18.2, U14.3 (Rg)
unnamed: R19.2, U14.7
unnamed: R24.1, U16.2 (Rg)
unnamed: R24.2, U16.3 (Rg)
unnamed: R25.2, U16.7
unnamed: R30.1, U18.2 (Rg)
unnamed: R30.2, U18.3 (Rg)
unnamed: R31.2, U18.7
unnamed: C68.1, R16.1, U14.4 (+)
unnamed: C68.2, R17.1, U14.1 (-)
unnamed: C75.1, R19.1, R20.2, U15.2 (-)
unnamed: C78.1, R22.1, U16.4 (+)
unnamed: C78.2, R23.1, U16.1 (-)
unnamed: C85.1, R25.1, R26.2, U17.2 (-)
unnamed: C88.1, R28.1, U18.4 (+)
unnamed: C88.2, R29.1, U18.1 (-)
unnamed: C95.1, R31.1, R32.2, U19.2 (-)
