jamead/psc_daughter_brd/psc_daughter_brd.kicad_pcb

## KiCad design psc_daughter_brd.kicad_pcb (continued)

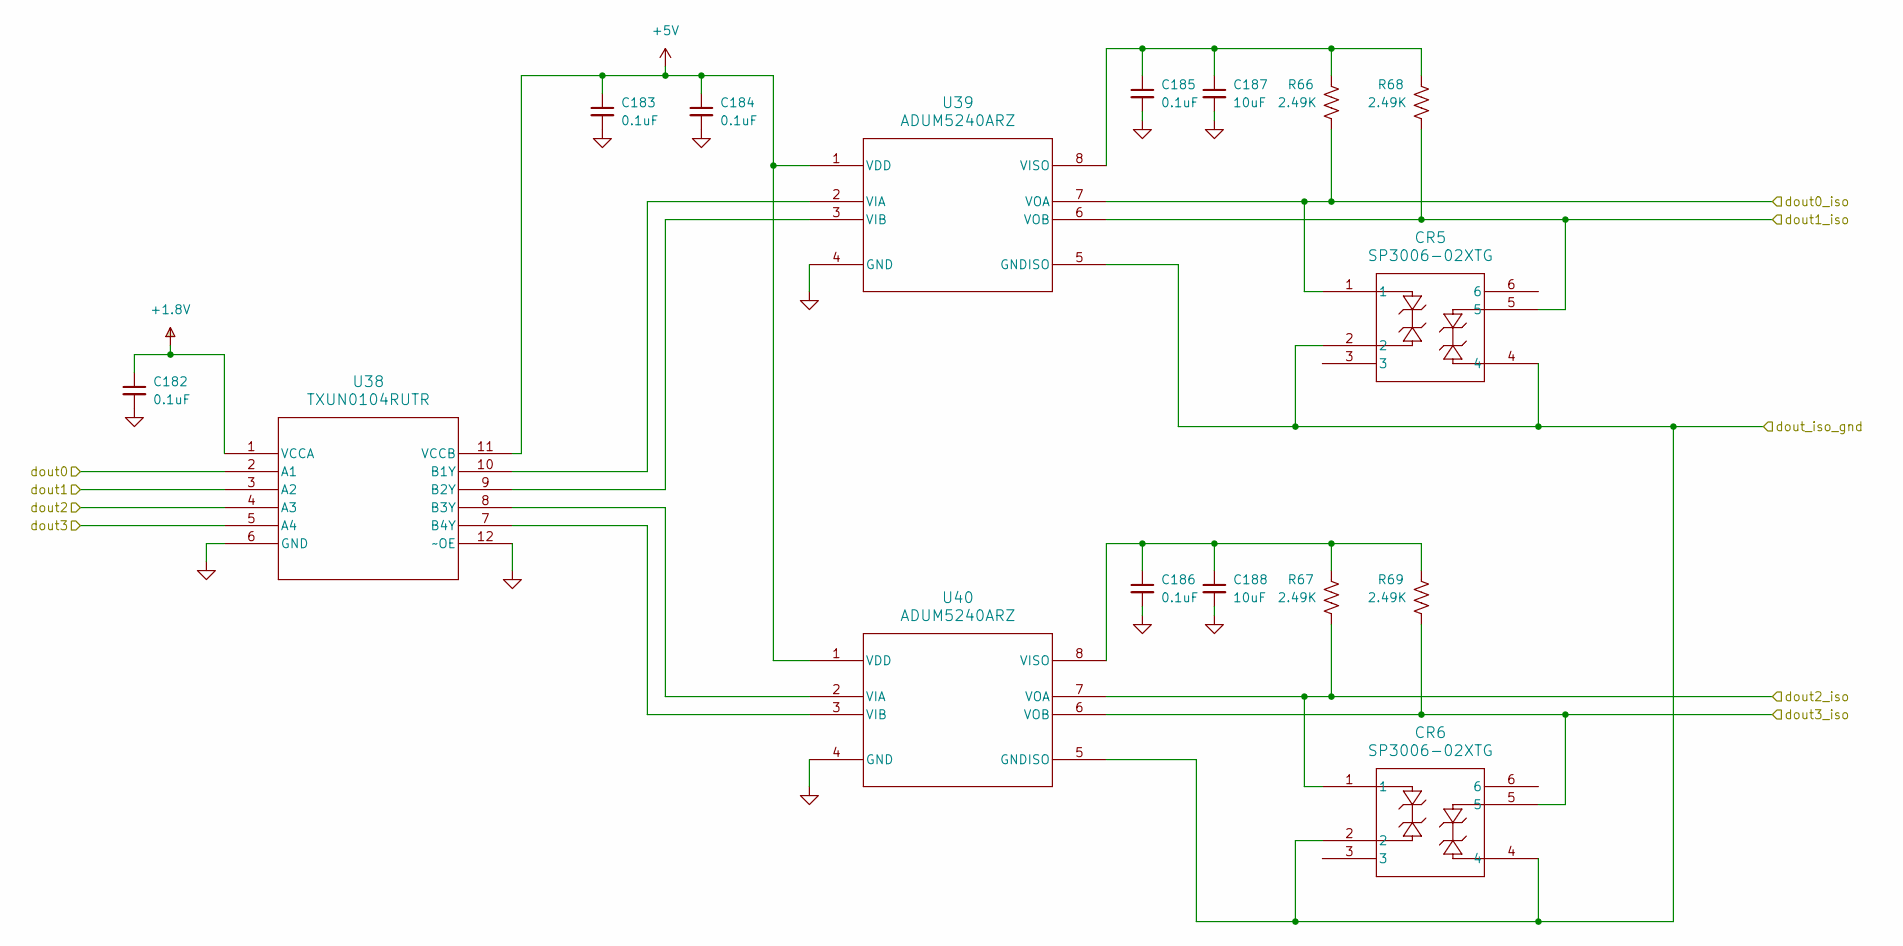
[picture p41: schematic digout.kicad_sch]

Parts:
C182, C183, C184, C185, C186: 0.1uF; C_0402_1005Metric
C187, C188: 10uF; C_0603_1608Metric; Voltage 25V
CR5, CR6: SP3006-02XTG; SOT563_LTF
R66, R67, R68, R69: 2.49K; R_0402_1005Metric; Tolerance 1%
U38: TXUN0104RUTR; PQFP12_RUT_TEX
U39, U40: ADUM5240ARZ; R_8_ADI

Connections:
+1.8V: C182.1, U38.1 (VCCA); also elsewhere on the board
+5V: C183.1, C184.1, U38.11 (VCCB), U39.1 (VDD), U40.1 (VDD); also elsewhere on the board
/FPGA connector/dout0: U38.2 (A1); also elsewhere on the board
/FPGA connector/dout1: U38.3 (A2); also elsewhere on the board
/FPGA connector/dout2: U38.4 (A3); also elsewhere on the board
/FPGA connector/dout3: U38.5 (A4); also elsewhere on the board
/Isolated Digital IO/dout0_iso: CR5.1, R66.1, U39.7 (VOA); also elsewhere on the board
/Isolated Digital IO/dout1_iso: CR5.5, R68.1, U39.6 (VOB); also elsewhere on the board
/Isolated Digital IO/dout2_iso: CR6.1, R67.1, U40.7 (VOA); also elsewhere on the board
/Isolated Digital IO/dout3_iso: CR6.5, R69.1, U40.6 (VOB); also elsewhere on the board
/Isolated Digital IO/dout_iso_gnd: CR5.2, CR5.4, CR6.2, CR6.4, U39.5 (GNDISO), U40.5 (GNDISO)
GND: C182.2, C183.2, C184.2, C185.2, C186.2, C187.2, C188.2, U38.6 (GND), U38.12 (~OE), U39.4 (GND), U40.4 (GND); also elsewhere on the board
unnamed: U38.10 (B1Y), U39.2 (VIA)
unnamed: U38.9 (B2Y), U39.3 (VIB)
unnamed: U38.8 (B3Y), U40.2 (VIA)
unnamed: U38.7 (B4Y), U40.3 (VIB)
unnamed: C185.1, C187.1, R66.2, R68.2, U39.8 (VISO)
unnamed: C186.1, C188.1, R67.2, R69.2, U40.8 (VISO)

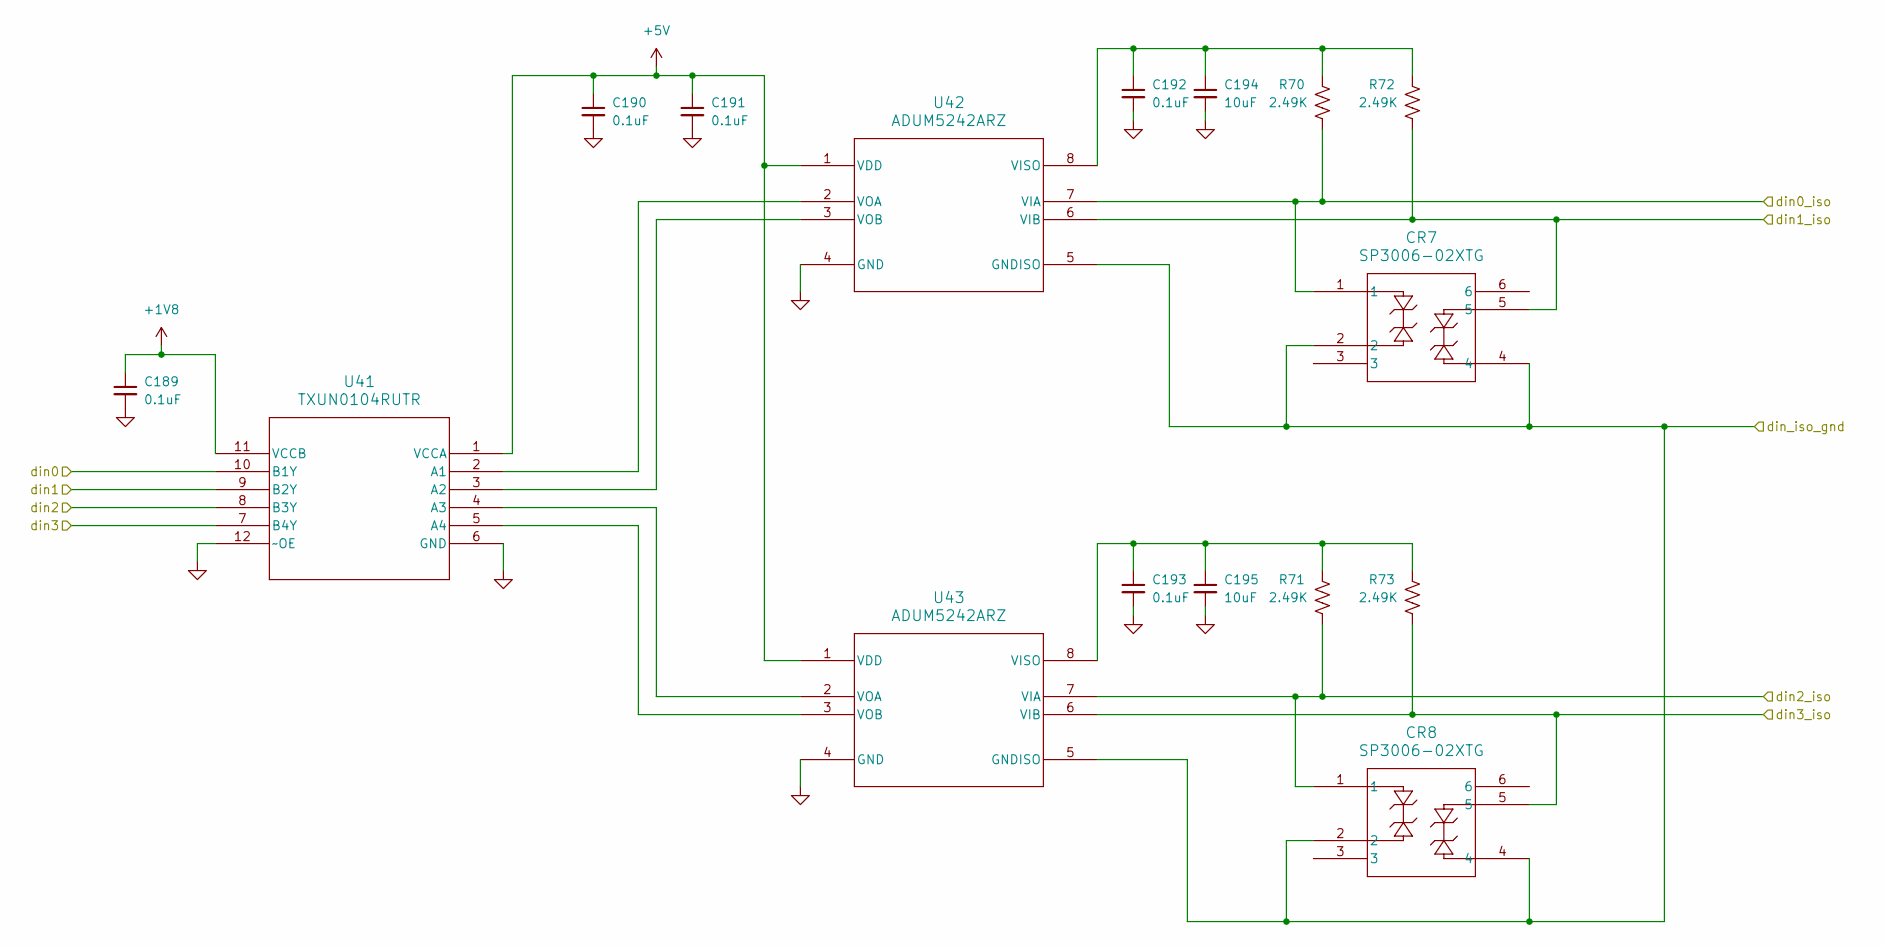
[picture p42: schematic digin.kicad_sch]

Parts:
C189, C190, C191, C192, C193: 0.1uF; C_0402_1005Metric
C194, C195: 10uF; C_0603_1608Metric; Voltage 25V
CR7, CR8: SP3006-02XTG; SOT563_LTF
R70, R71, R72, R73: 2.49K; R_0402_1005Metric; Tolerance 1%
U41: TXUN0104RUTR; PQFP12_RUT_TEX
U42, U43: ADUM5242ARZ; R_8_ADI

Connections:
+1V8: C189.1, U41.11 (VCCB)
+5V: C190.1, C191.1, U41.1 (VCCA), U42.1 (VDD), U43.1 (VDD); also elsewhere on the board
/FPGA connector/din0: U41.10 (B1Y); also elsewhere on the board
/FPGA connector/din1: U41.9 (B2Y); also elsewhere on the board
/FPGA connector/din2: U41.8 (B3Y); also elsewhere on the board
/FPGA connector/din3: U41.7 (B4Y); also elsewhere on the board
/Isolated Digital IO/din0_iso: CR7.1, R70.1, U42.7 (VIA); also elsewhere on the board
/Isolated Digital IO/din1_iso: CR7.5, R72.1, U42.6 (VIB); also elsewhere on the board
/Isolated Digital IO/din2_iso: CR8.1, R71.1, U43.7 (VIA); also elsewhere on the board
/Isolated Digital IO/din3_iso: CR8.5, R73.1, U43.6 (VIB); also elsewhere on the board
/Isolated Digital IO/din_iso_gnd: CR7.2, CR7.4, CR8.2, CR8.4, U42.5 (GNDISO), U43.5 (GNDISO)
GND: C189.2, C190.2, C191.2, C192.2, C193.2, C194.2, C195.2, U41.6 (GND), U41.12 (~OE), U42.4 (GND), U43.4 (GND); also elsewhere on the board
unnamed: U41.2 (A1), U42.2 (VOA)
unnamed: U41.3 (A2), U42.3 (VOB)
unnamed: U41.4 (A3), U43.2 (VOA)
unnamed: U41.5 (A4), U43.3 (VOB)
unnamed: C192.1, C194.1, R70.2, R72.2, U42.8 (VISO)
unnamed: C193.1, C195.1, R71.2, R73.2, U43.8 (VISO)

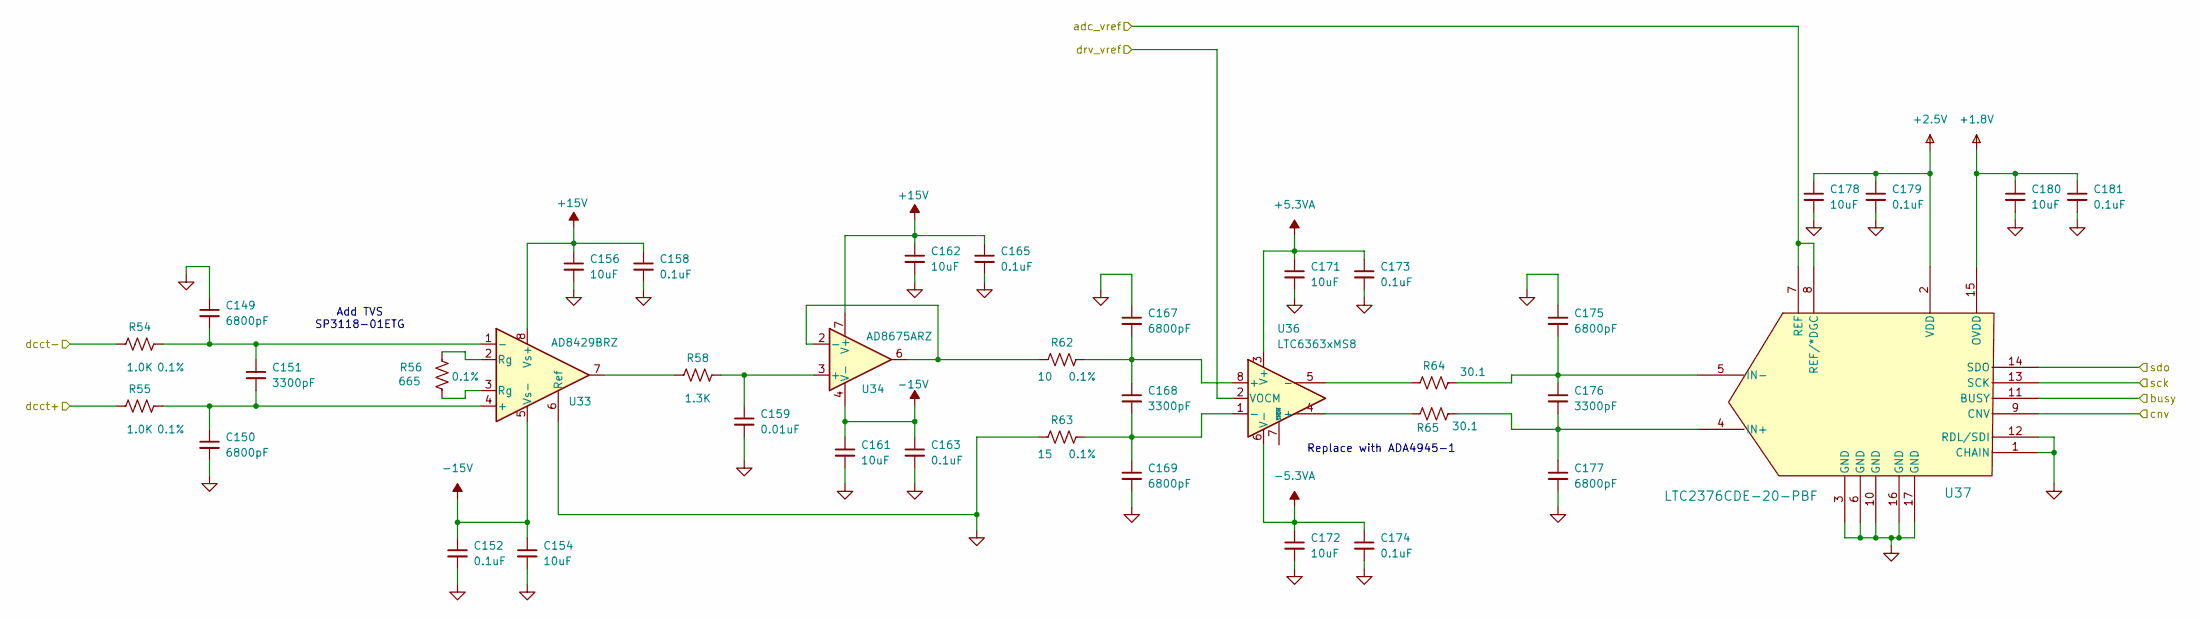
[picture p43: schematic dcct.kicad_sch]

Parts:
C149, C150, C167, C169, C175, C177: 6800pF; C_0402_1005Metric
C151, C168, C176: 3300pF; C_0402_1005Metric
C152, C158, C163, C165, C173, C174, C179, C181: 0.1uF; C_0402_1005Metric
C154, C156, C161, C162, C171, C172, C178, C180: 10uF; C_0603_1608Metric; Voltage 25V
C159: 0.01uF; C_0402_1005Metric
R54, R55: 1.0K; R_0402_1005Metric; Tolerance 0.1%
R56: 665; R_0402_1005Metric; Tolerance 0.1%
R58: 1.3K; R_0402_1005Metric; Tolerance 1%
R62: 10; R_0402_1005Metric; Tolerance 0.1%
R63: 15; R_0402_1005Metric; Tolerance 0.1%
R64, R65: 30.1; R_0402_1005Metric; Tolerance 1%
U33: AD8429BRZ; SOIC127P600X175-8N
U34: AD8675ARZ; SOIC-8_3.9x4.9mm_P1.27mm
U36: LTC6363xMS8; MSOP-8_3x3mm_P0.65mm
U37: LTC2376CDE-20-PBF; DFN-16_DE_LIT

Connections:
+1.8V: C180.1, C181.1, U37.15 (OVDD); also elsewhere on the board
+2.5V: C178.1, C179.1, U37.2 (VDD); also elsewhere on the board
+5.3VA: C171.1, C173.1, U36.3 (V+); also elsewhere on the board
+15V: C156.1, C158.1, C162.1, C165.1, U33.8 (Vs+), U34.7 (V+); also elsewhere on the board
-5.3VA: C172.1, C174.1, U36.6 (V-); also elsewhere on the board
-15V: C152.1, C154.1, C161.1, C163.1, U33.5 (Vs-), U34.4 (V-); also elsewhere on the board
/DCCT ADCs/DCCT Channel 1/adc_vref: U37.7 (REF), U37.8 (REF/*DGC); also elsewhere on the board
/DCCT ADCs/DCCT Channel 1/drv_vref: U36.2 (VOCM); also elsewhere on the board
/DCCT ADCs/dcct0+: R55.2; also elsewhere on the board
/DCCT ADCs/dcct0-: R54.2; also elsewhere on the board
/DCCT ADCs/dcct0_sdo: U37.14 (SDO); also elsewhere on the board
/DCCT ADCs/dcct_busy: U37.11 (BUSY); also elsewhere on the board
/DCCT ADCs/dcct_cnv: U37.9 (CNV); also elsewhere on the board
/DCCT ADCs/dcct_sck: U37.13 (SCK); also elsewhere on the board
GND: C149.1, C150.2, C152.2, C154.2, C156.2, C158.2, C159.2, C161.2, C162.2, C163.2, C165.2, C167.1, C169.2, C171.2, C172.2, C173.2, C174.2, C175.1, C177.2, C178.2, C179.2, C180.2, C181.2, R63.2, U33.6 (Ref), U37.1 (CHAIN), U37.3 (GND), U37.6 (GND), U37.10 (GND), U37.12 (RDL/SDI), U37.16 (GND), U37.17 (GND); also elsewhere on the board
unnamed: C167.2, C168.1, R62.1, U36.8 (+)
unnamed: C168.2, C169.1, R63.1, U36.1 (-)
unnamed: R56.1, U33.2 (Rg)
unnamed: R56.2, U33.3 (Rg)
unnamed: R58.2, U33.7
unnamed: R64.2, U36.5 (-)
unnamed: R65.2, U36.4 (+)
unnamed: C150.1, C151.2, R55.1, U33.4 (+)
unnamed: C149.2, C151.1, R54.1, U33.1 (-)
unnamed: C159.1, R58.1, U34.3 (+)
unnamed: R62.2, U34.2 (-), U34.6
unnamed: C176.2, C177.1, R65.1, U37.4 (IN+)
unnamed: C175.2, C176.1, R64.1, U37.5 (IN-)

Parts of its further copies:
C114, C115, C132, C134, C140, C142: 6800pF; C_0402_1005Metric
C116, C133, C141: 3300pF; C_0402_1005Metric
C117, C123, C128, C130, C138, C139, C144, C146: 0.1uF; C_0402_1005Metric
C119, C121, C126, C127, C136, C137, C143, C145: 10uF; C_0603_1608Metric; Voltage 25V
C124: 0.01uF; C_0402_1005Metric
R42, R43: 1.0K; R_0402_1005Metric; Tolerance 0.1%
R44: 665; R_0402_1005Metric; Tolerance 0.1%
R46: 1.3K; R_0402_1005Metric; Tolerance 1%
R50: 10; R_0402_1005Metric; Tolerance 0.1%
R51: 15; R_0402_1005Metric; Tolerance 0.1%
R52, R53: 30.1; R_0402_1005Metric; Tolerance 1%
U27: AD8429BRZ; SOIC127P600X175-8N
U28: AD8675ARZ; SOIC-8_3.9x4.9mm_P1.27mm
U30: LTC6363xMS8; MSOP-8_3x3mm_P0.65mm
U31: LTC2376CDE-20-PBF; DFN-16_DE_LIT

Connections of its further copies:
+1.8V: C145.1, C146.1, U31.15 (OVDD); also elsewhere on the board
+2.5V: C143.1, C144.1, U31.2 (VDD); also elsewhere on the board
+5.3VA: C136.1, C138.1, U30.3 (V+); also elsewhere on the board
+15V: C121.1, C123.1, C127.1, C130.1, U27.8 (Vs+), U28.7 (V+); also elsewhere on the board
-5.3VA: C137.1, C139.1, U30.6 (V-); also elsewhere on the board
-15V: C117.1, C119.1, C126.1, C128.1, U27.5 (Vs-), U28.4 (V-); also elsewhere on the board
/DCCT ADCs/DCCT Channel 1/adc_vref: U31.7 (REF), U31.8 (REF/*DGC); also elsewhere on the board
/DCCT ADCs/DCCT Channel 1/drv_vref: U30.2 (VOCM); also elsewhere on the board
/DCCT ADCs/DCCT Channel 2/busy: U31.11 (BUSY)
/DCCT ADCs/dcct1+: R43.2; also elsewhere on the board
/DCCT ADCs/dcct1-: R42.2; also elsewhere on the board
/DCCT ADCs/dcct1_sdo: U31.14 (SDO); also elsewhere on the board
/DCCT ADCs/dcct_cnv: U31.9 (CNV); also elsewhere on the board
/DCCT ADCs/dcct_sck: U31.13 (SCK); also elsewhere on the board
GND: C114.1, C115.2, C117.2, C119.2, C121.2, C123.2, C124.2, C126.2, C127.2, C128.2, C130.2, C132.1, C134.2, C136.2, C137.2, C138.2, C139.2, C140.1, C142.2, C143.2, C144.2, C145.2, C146.2, R51.2, U27.6 (Ref), U31.1 (CHAIN), U31.3 (GND), U31.6 (GND), U31.10 (GND), U31.12 (RDL/SDI), U31.16 (GND), U31.17 (GND); also elsewhere on the board
unnamed: C132.2, C133.1, R50.1, U30.8 (+)
unnamed: C133.2, C134.1, R51.1, U30.1 (-)
unnamed: R44.1, U27.2 (Rg)
unnamed: R44.2, U27.3 (Rg)
unnamed: R46.2, U27.7
unnamed: R52.2, U30.5 (-)
unnamed: R53.2, U30.4 (+)
unnamed: C115.1, C116.2, R43.1, U27.4 (+)
unnamed: C114.2, C116.1, R42.1, U27.1 (-)
unnamed: C124.1, R46.1, U28.3 (+)
unnamed: R50.2, U28.2 (-), U28.6
unnamed: C141.2, C142.1, R53.1, U31.4 (IN+)
unnamed: C140.2, C141.1, R52.1, U31.5 (IN-)

Notes on the sheet:
Add TVS SP3118-01ETG
Replace with ADA4945-1

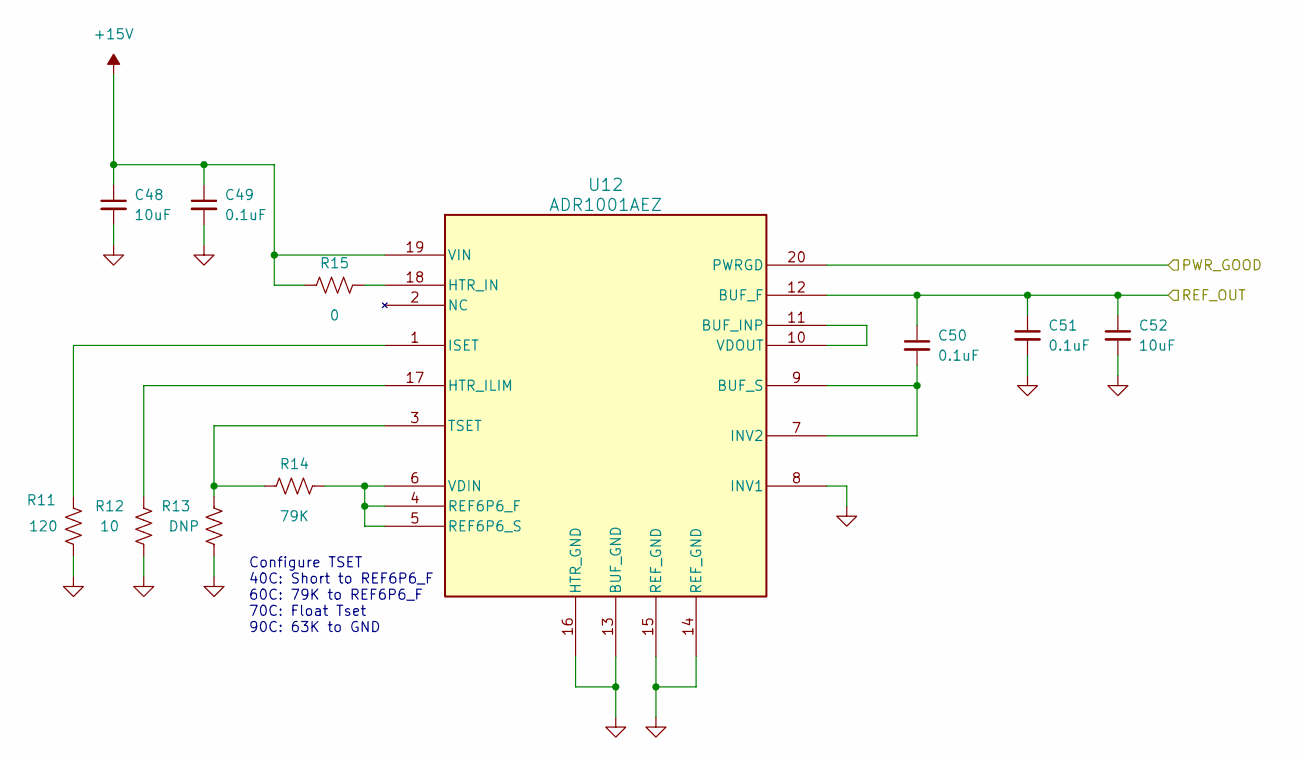
[picture p44: schematic volt_ref.kicad_sch]

Parts:
C48, C52: 10uF; C_0603_1608Metric; Voltage 25V
C49, C50, C51: 0.1uF; C_0402_1005Metric
R11: 120; R_0402_1005Metric; Tolerance 1%
R12: 10; R_0402_1005Metric; Tolerance 1%
R13: DNP; R_0402_1005Metric; Tolerance 1%
R14: 79K; R_0402_1005Metric; Tolerance 1%
R15: 0; R_0402_1005Metric; Tolerance 1%
U12: ADR1001AEZ; E-20-1_ADI

Connections:
+15V: C48.1, C49.1, R15.2, U12.19 (VIN); also elsewhere on the board
/DAC/Voltage Reference/PWR_GOOD: U12.20 (PWRGD)
/DAC/Voltage Reference/REF_OUT: C50.1, C51.1, C52.1, U12.12 (BUF_F); also elsewhere on the board
GND: C48.2, C49.2, C51.2, C52.2, R11.1, R12.1, R13.1, U12.8 (INV1), U12.13 (BUF_GND), U12.14 (REF_GND), U12.15 (REF_GND), U12.16 (HTR_GND); also elsewhere on the board
unnamed: U12.10 (VDOUT), U12.11 (BUF_INP)
unnamed: C50.2, U12.7 (INV2), U12.9 (BUF_S)
unnamed: R12.2, U12.17 (HTR_ILIM)
unnamed: R15.1, U12.18 (HTR_IN)
unnamed: R11.2, U12.1 (ISET)
unnamed: R14.1, U12.4 (REF6P6_F), U12.5 (REF6P6_S), U12.6 (VDIN)
unnamed: R13.2, R14.2, U12.3 (TSET)

Notes on the sheet:
Configure TSET 40C: Short to REF6P6_F 60C: 79K to REF6P6_F 70C: Float Tset 90C: 63K to GND

Board: 10 copper layers, 278 parts (120 on the bottom side), 161 nets, no tracks yet.
