jamead/psc_daughter_brd/(commit log)

2025-07-02 Initial commit, copied from Carrier Board
    [39301022.step, 6469028-1.step, 836149012.step, Amphenol_10090926-P264XLF.step, dac.kicad_sch, psc_carrier_brd.kicad_pcb, psc_carrier_brd.kicad_sch, untitled.kicad_sch]
2025-07-02 Add DAC Sheet
    [dac.kicad_sch, psc_carrier_brd.kicad_pcb, psc_carrier_brd.kicad_sch, psc_daughter_brd.kicad_pcb, psc_daughter_brd.kicad_sch, untitled.kicad_sch, zudfe_conn.kicad_sch]
2025-07-09 DAC section schematic updates
    [dac.kicad_sch, psc_daughter_brd.kicad_sch]
2025-07-13 Add ADR1001 Voltage Reference
    [dac.kicad_sch, psc_daughter_brd.kicad_pcb, psc_daughter_brd.kicad_sch, volt_ref.kicad_sch]
2025-07-15 Add ADC monitor circuit
    [AD8221BRZ.step, ADS8568SPM.step, dcct.kicad_sch, monitor.kicad_sch, monitor_fe.kicad_sch, psc_daughter_brd.kicad_pcb, psc_daughter_brd.kicad_sch, volt_ref.kicad_sch]
2025-11-17 Change board size, add DB connector
    [psc_daughter_brd.kicad_pcb, psc_daughter_brd.kicad_sch]
2025-11-18 Add isolated digital I/O
    [61082-061400LF.step, dac.kicad_sch, digin.kicad_sch, digio.kicad_sch, digout.kicad_sch, fpga_conn.kicad_sch, monitor.kicad_sch, ps_conn.kicad_sch]
2025-11-20 Add DCCT ADCs
    [LTC2378CDE-20#PBF.STEP, LTC6655BHLS8-5#PBF.STEP, dac.kicad_sch, dcct.kicad_sch, dcct_top.kicad_sch, digin.kicad_sch, digio.kicad_sch, digout.kicad_sch]
2025-11-22 DAC and DCCT placement
    [dcct.kicad_sch, dcct_top.kicad_sch, digout.kicad_sch, fpga_conn.kicad_sch, monitor.kicad_sch, ps_conn.kicad_sch, psc_daughter_brd.kicad_pcb, psc_daughter_brd.kicad_sch]
2025-11-24 finish rough placement
    [dac.kicad_sch, dcct.kicad_sch, dcct_top.kicad_sch, ps_conn.kicad_sch, psc_daughter_brd.kicad_pcb, psc_daughter_brd.kicad_sch]
2025-12-01 Tweaks to connector pinouts
    [dcct.kicad_sch, fpga_conn.kicad_sch, ps_conn.kicad_sch]
2025-12-03 Change DAC outputs to 1.8v
    [dac.kicad_sch, psc_daughter_brd.kicad_pcb, psc_daughter_brd.kicad_sch]
2026-01-05 Finish layout
    [61082-061400LF--3DModel-STEP-740395.STEP, AD8221BRZ.STEP, DFLS130-7_DIO.step, E-20-1_ADI.step, RUT0012A.stp, R_8_ADI.step, SOT563_LTF.step, S_5_ADI.step]
2026-01-05 Add testpoints to BOM
    [psc_daughter_brd.csv, psc_daughter_brd.ods]
2026-01-05 Rename BOM file
    [psc_daughter_brd_BOM.ods]
2026-01-05 Modify fab drawing
    [psc_daughter_brd-B_Cu - L10-sig.gbr, psc_daughter_brd-B_Mask.gbr, psc_daughter_brd-B_Paste.gbr, psc_daughter_brd-B_Silkscreen.gbr, psc_daughter_brd-Edge_Cuts.gbr, psc_daughter_brd-F_Cu - L1-sig.gbr, psc_daughter_brd-F_Fab.gbr, psc_daughter_brd-F_Mask.gbr]
2026-01-06 Add drawing number
    [psc_daughter_brd-B_Cu - L10-sig.gbr, psc_daughter_brd-B_Mask.gbr, psc_daughter_brd-B_Paste.gbr, psc_daughter_brd-B_Silkscreen.gbr, psc_daughter_brd-Edge_Cuts.gbr, psc_daughter_brd-F_Cu - L1-sig.gbr, psc_daughter_brd-F_Fab.gbr, psc_daughter_brd-F_Mask.gbr]
